krolbot/sirokko-26201-controller/pcb/README.md

# Исходники платы

Откройте **[Sirokko.kicad_pro](Sirokko.kicad_pro)** в KiCad 10 со стандартными библиотеками. Файлы проекта, функциональные листы схемы и локальные библиотеки образуют один комплект; копируйте каталог целиком.

- `Sirokko.kicad_pcb` — плата.
- `Sirokko.kicad_sch` — корневая схема, остальные `.kicad_sch` — её листы.
- `sym-lib-table`, `fp-lib-table`, `.kicad_sym`, `.pretty/`, `3dmodels/` — зависимости проекта с относительными путями.
- [schematic.pdf](schematic.pdf) — схема для просмотра без KiCad.

Соединения и конструкцию меняйте в этих файлах, без каталогов альтернативных плат. После изменения платы пересоберите Gerber/сверловку и монтажные файлы в [production](../production/). PDF схемы также экспортируйте из текущего проекта.

[Сборка и подключения](../BUILD.md) · [Компоненты](../BUY.md) · [Лицензии библиотек](KICAD_LIBRARIES_LICENSE.md)

## Вид платы

Лицевая сторона

Обратная сторона

Это изображения несущей платы; вставные DevKit, MAX31856 и внешняя панель на них не установлены. Некоторые заказные детали представлены габаритными моделями.
