krolbot/sirokko-26201-controller/BUY.md

# Компоненты Sirokko

Ведомость на один контроллер. [Скачать CSV](BUY.csv) для закупки или открытия в таблице.

## Детали с карточками ChipDip

Количество включает все перечисленные обозначения. Наличие и цену уточняйте в магазине.

| Обозначения | Кол. | Деталь и параметры | Артикул / карточка |
|---|---:|---|---|
| C21 | 1 | Конденсатор — 100 нФ, 100 В, X7R, 0805 | [GRM21BR72A104KAC4L](https://www.chipdip.ru/product/0.1mkf-x7r-100v-10-0805-grm21br72a104kac4l-murata-9000427298) |
| C22 | 1 | Конденсатор — 330 мкФ, 63 В, радиальный D10 P5 | [EEUFS1J331L](https://www.chipdip.ru/product/eeufs1j331l-panasonic-8027723178) |
| C24 | 1 | Конденсатор — 220 нФ, 100 В, X7R, 0805 | [CL21B224KCFSFNE](https://www.chipdip.ru/product/cl21b224kcfsfne-samsung-8017846748) |
| C25 | 1 | Конденсатор — 1 мкФ, 100 В, 1206 | [GRM31CR72A105KA01L](https://www.chipdip.ru/product/1-mkf-x7r-100v-10-1206-grm31cr72a105ka01l-murata-9000122527) |
| C101,C102 | 2 | Конденсатор — 2,2 мкФ, 100 В, X7R, 1210 | [GRM32ER72A225KA35L](https://www.chipdip.ru/product/2.2-mkf-x7r-10-100v-1210-grm32er72a225k-kondensator-murata-9000103930) |
| C103 | 1 | Конденсатор — 100 мкФ, 100 В, радиальный D10 P5 | [EEU-FR2A101](https://www.chipdip.ru/product/eeufr2a101-kondensatory-alyuminievye-panasonic-8048099750) |
| C104 | 1 | Конденсатор — 2,2 нФ, 50 В, C0G, 0603 | [GRM1885C1H222JA01D](https://www.chipdip.ru/product/2200pf-np0-50v-5-0603-grm1885c1h222ja01d-kondensator-murata-9000122092) |
| C105,C106 | 2 | Конденсатор — 47 мкФ, 16 В, X5R, 1210 | [GRM32ER61C476KE15L](https://www.chipdip.ru/product/47mkf-x5r-16v-10-1210-grm32er61c476ke15l-kondensator-murata-9000070696) |
| C107 | 1 | Конденсатор — 4,7 нФ, 50 В, C0G, 0603 | [GRM1885C1H472JA01D](https://www.chipdip.ru/product/4700pf-np0-50v-5-0603-grm1885c1h472ja01d-kondensator-murata-9000342731) |
| C108 | 1 | Конденсатор — 820 пФ, 50 В, C0G, 0603 | [CC0603JRNPO9BN821](https://www.chipdip.ru/product/820pf-np0-50v-5-0603-cc0603jrnpo9bn821-kondensator-yageo-9000537404) |
| C109 | 1 | Конденсатор — 33 нФ, 100 В, C0G, 0805 | [GRM2195C2A333JE01J](https://www.chipdip.ru/product/grm2195c2a333je01j-capacitor-ceramic-mlcc-33nf-100v-murata-8061975501) |
| D1 | 1 | TVS-защита — VSON-8 3×3 мм | [TVS3301DRBR](https://www.chipdip.ru/product/tvs3301drbr-texas-instruments-8003769406) |
| D101 | 1 | Диод Шоттки — 100 В, 5 А, TO-252 | [STPS5H100B-TR](https://www.chipdip.ru/product/stps5h100b-tr-diod-shottki-100v-5a-dpak-st-microelectronics-9001570322) |
| F1 | 1 | Держатель плавкой вставки — для вставки 0997015.WXN, посадочное место Keystone 3568 | [3568](https://www.chipdip.ru/product/3568-derzhatel-predohranitelya-tht-keystone-8070123077) |
| F1 | 1 | Плавкая вставка — 15 А, 58 В DC, для держателя 3568 | [0997015.WXN](https://www.chipdip.ru/product/0997015-wxn-predohranitel-plavkaya-vstavka-15a-littelfuse-8013841700) |
| J1,J3 | 2 | Гнездовая колодка 1×22 — P2,54, вертикальная, для DevKit | [SSQ-122-01-T-S](https://www.chipdip.ru/product0/8065631635) |
| J12 | 1 | Винтовая клеммная колодка 1×3 — MKDS 1,5, P5,08, горизонтальная | [1715734](https://www.chipdip.ru/product/1715734-vintovoy-terminal-17.5a-250v-phoenix-contact-8031094982) |
| J13,J27,J28 | 3 | Винтовая клеммная колодка 1×2 — MKDS 5-HV-2, P9,52 | [1756993](https://www.chipdip.ru/product/1756993-fixed-terminal-blocks-mkds-5-hv-2-9-phoenix-contact-8005105820) |
| J29 | 1 | Винтовая клеммная колодка 1×4 — MKDS 1,5-4, P5,08, горизонтальная | [1715747](https://www.chipdip.ru/product/1715747-fixed-terminal-blocks-4p-5.08mm-phoenix-contact-8005104956) |
| J30,J31 | 2 | Колодка модуля 1×9 — P2,54, для модулей MAX31856 | [SSW-109-01-T-S](https://www.chipdip.ru/product/ssw-109-01-t-s-headers-wire-housings-tiger-buy-samtec-8004762790) |
| K1,K2 | 2 | Колодка реле — 5 выводов, впаиваемая, для DG85BM-5021-76-1024 | [DZ85AB-5-PCB](https://www.chipdip.ru/product/dz85ab-5-pcb-dz-5-pin-pcb-mount-relay-socket-for-durakool-8034111209) |
| L101 | 1 | Силовой дроссель — 33 мкГн, Isat не менее 10 А | [SRP1770TA-330M](https://www.chipdip.ru/product/srp1770ta-330m-power-inductors-smd-33uh-20-bourns-8005125913) |
| Q1,Q2,Q3,Q4 | 4 | N-канальный MOSFET — 100 В, PG-TO263-7 | [IPB017N10N5LFATMA1](https://www.chipdip.ru/product/ipb017n10n5lfatma1-100v-180a-1.7mohm-100a-10v-313w-infineon-8044731406) |
| R1,R86,R87 | 3 | Резистор — 4,7 кОм, THT DIN0207, P10,16 | [MFR-25FTE52-4K7](https://www.chipdip.ru/product/mfr-25fte52-4k7-metal-film-resistors-4.7k-250mw-50ppm-yageo-8003541082) |
| R2,R3,R7,R8 | 4 | Резистор — 10 кОм, THT DIN0207, P10,16 | [MFR-25FBF52-10K](https://www.chipdip.ru/product/mfr-25fbf52-10k-through-hole-resistor-10-kohm-mfr-yageo-8015456907) |
| R90,R91,R92,R93 | 4 | Резистор — 4,7 Ом, 1 %, 0805 | [RC0805FR-074R7L](https://www.chipdip.ru/product/0.125vt-0805-4.7-om-1-rc0805fr-074r7l-chip-rezistor-yageo-9000237107) |
| R94 | 1 | Резистор — 84,5 кОм, 1 %, 0805 | [RC0805FR-0784K5L](https://www.chipdip.ru/product/rc0805fr-0784k5l-yageo-8001774452) |
| R95 | 1 | Резистор — 3,48 кОм, 1 %, 0805 | [RC0805FR-073K48L](https://www.chipdip.ru/product0/8001789855) |
| R96 | 1 | Резистор — 75 кОм, 1 %, 0805 | [RC0805FR-0775KL](https://www.chipdip.ru/product/rc0805fr-0775kl-yageo-8059892229) |
| R97 | 1 | Резистор — 5,62 кОм, 1 %, 0805 | [RC0805FR-075K62L](https://www.chipdip.ru/product/rc0805fr-075k62l-yageo-8001794155) |
| R101,R103 | 2 | Резистор — 31,6 кОм, 1 %, 0603 | [RC0603FR-0731K6L](https://www.chipdip.ru/product/rc0603fr-0731k6l-thick-film-resistors-smd-general-yageo-8005039309) |
| R102,R105,R107 | 3 | Резистор — 10 кОм, 1 %, 0603 | [RC0603FR-0710KL](https://www.chipdip.ru/product/rc0603fr-0710kl) |
| R104 | 1 | Резистор — 100 кОм, 1 %, 0603 | [RC0603FR-07100KL](https://www.chipdip.ru/product/0.1vt-0603-100-kom-1-rc0603fr-07100kl-chip-rezistor-yageo-9000721722) |
| R106 | 1 | Резистор — 82 кОм, 1 %, 0603 | [RC0603FR-0782KL](https://www.chipdip.ru/product/rc0603fr-0782kl-chip-rezistor-0603-82-kom-1-0.1vt-yageo-8045103082) |
| R108 | 1 | Резистор — 22 кОм, 1 %, 1210 | [RC1210FR-0722KL](https://www.chipdip.ru/product/rc1210fr-0722kl-yageo-8044377004) |
| TP101 | 1 | Контрольная точка — Micro Mini | [5015](https://www.chipdip.ru/product/5015-keystone-8002072088) |
| U11 | 1 | Драйвер двигателя — HTSSOP-16 с тепловой площадкой | [DRV8803PWPR](https://www.chipdip.ru/product/drv8803pwpr-texas-instruments-9001599750) |
| U13 | 1 | Контроллер идеального диода — WSON-12 3×3 мм с тепловой площадкой | [LM74800QDRRRQ1](https://www.chipdip.ru/product/lm74800qdrrrq1-kontroller-upravleniya-texas-instruments-9001859100) |
| U101 | 1 | Импульсный понижающий контроллер — DDA-8 | [LM5013DDAR](https://www.chipdip.ru/product/lm5013ddar-texas-instruments-8075672392) |
| J30,J31 | 2 | Модуль термопары MAX31856 — совместим с колодкой SSW-109-01-T-S, 9 контактов P2,54 | [синий 9-контактный, геометрия Adafruit 3263](https://www.chipdip.ru/product/3263-datchik-adapter-dlya-datchika-3-3-5vdc-ic-adafruit-8062129909) |
| J12 | 1 | Герметичный температурный зонд — IP67, трёхпроводный, для J12 | [DS18B20](https://www.chipdip.ru/product/ds18b20-ip67-1-3-wire-gilza-49-7-h-6-mm-smartmodule-9000725119) |

Для MAX31856 карточка Adafruit 3263 служит эталоном геометрии и распиновки; это не артикул безымянного синего модуля.

## Покупка вне ChipDip и изделия по месту

Ниже позиции без закреплённой карточки ChipDip. Это не утверждение об отсутствии товара во всём каталоге. Для маркетплейсов ищите указанную модель; одинакового названия недостаточно без совпадения исполнения.

| Обозначения | Кол. | Что купить | Совместимость |
|---|---:|---|---|
| J32 | 1 | Ключевой IDC-разъём 2×6 | P2,54, вертикальный, THT, ключевой, по посадочному месту IDC-Header_2x06. Для панели TFT |
| K1,K2 | 2 | Реле 24 В — DG85BM-5021-76-1024 | вставное, для колодки DZ85AB-5-PCB. Не заменять на другое семейство реле |
| J1,J3 | 1 | ESP32 DevKit — YD-ESP32-S3 N16R8 V1.4 | готовая плата, N16R8, V1.4, два ряда по 22 контакта. Голый ESP32-S3-WROOM не подходит |
| J29 | 1 | Контроллер двигателя — HC-160A S2 | исполнение S2, линии A1, A2, PA, G. Не часть PCB |
| J32 | 1 | Панель TFT с энкодером | TFT 2,4″ SPI, 3,3 В, EC11, отдельная KEY0, 12 доступных контактов. Не заменять панелью с другой распиновкой |
| — | 2 | Термопара — тип K | рабочий диапазон 0–600 °C. Механическое исполнение и длина не заданы |
| J32 | 1 | Шлейф панели | до 100 мм, ключевой 2×6 IDC со стороны J32, 12 контактов к выбранной панели. Разводка контактов не 1:1 |

## Колодки, вставные модули и кабели

- F1: держатель Keystone 3568 и вставка Littelfuse 0997015.WXN приобретаются отдельно.
- K1/K2: впаиваемые DZ85AB-5-PCB и вставные DG85BM-5021-76-1024 — разные позиции.
- J1/J3 и J30/J31 — колодки, не сами DevKit и MAX31856.
- Для TFT нужен шлейф до 100 мм по [таблице подключения J32](BUILD.md#панель-tft-24--ec11--key0), не прямой кабель 1:1.
- Крепёжные отверстия H* не являются закупаемыми деталями. Крепёж подбирается под корпус.

[Распиновки и электрические требования](BUILD.md) · [Файлы для монтажника](production/README.md)
