krolbot/sirokko-26201-controller/docs/research/YD_V14_ELECTRICAL_INTEGRATION_RU.md

# Sirokko — документарное сопряжение YD-ESP32-S3 V1.4

> Уточнение 2026-10-27: действуют [REQ-010/011/016](../REQUIREMENTS_RU.md#2-монтаж-компоненты-и-интерфейсы). YD-ESP32-S3 N16R8 USB-C сохраняется. Проектные 25%/30% не предъявляются к готовым DevKit/TFT и их внутренним компонентам. Применение 1,25 к U3 в расчёте ниже — сохранённая историческая проверка, НЕ действующий критерий приёмки и не основание переделывать или заменять модуль. Паспортные пределы, реальный баланс нагрузки, электрическая совместимость и проверка нашего питания остаются обязательными; к собственной обвязке Sirokko запасы применяются по REQ-016. Расчёты здесь не повторялись, CAD/BOM/прошивка не менялись.

## Происхождение и дата исследования

Публичная производная инженерного исследования проекта Sirokko: `YD_V14_ELECTRICAL_INTEGRATION_RU.md`, SHA256 исходника `140f7cfa49f716a295a7a53b1be22378153adbd3284611e0542f4abc1efaa834`. Основной текст сохранён; удалены только частные абсолютные пути к PCB, оставлено имя файла. Приведённые чтения паспортов, осмотры страниц, расчёты и CAD-проверки относятся к исходному исследованию и не повторялись при публикации.

Контекст зафиксирован **2026-10-26**. Формулировки ниже «текущий», «ожидает» и «откат выполняется» описывают этапы исследования, а не актуальное состояние CAD. К моменту публикации PCB уже восстановлена, адресная работа RESET возобновлена единственным CAD-редактором; её дальнейший результат и приёмка сюда не подставлены. Это не [CURRENT_STATE](../CURRENT_STATE_RU.md) и не новая инструкция монтажа RESET.

Предыдущий аппаратный снимок `d015fbb1` доступен в истории Git; настоящая копия сохраняет действующее исследование без дублирования CAD. **DRAFT / NOT FOR ORDER / NO FIRE. Производственного допуска нет.**

---

DRAFT / NOT FOR ORDER / НЕ ДЛЯ ОГНЕВЫХ ИСПЫТАНИЙ.
Результат: проверены назначения контактов и топология схемы модуля. Это не изменение PCB, не проверка конкретного экземпляра и не завершённая квалификация питания.

## Источники и границы

- Схема изготовителя: https://raw.githubusercontent.com/vcc-gnd/YD-ESP32-S3/main/5-public-YD-ESP32-S3-Hardware%20info/YD-ESP32-S3-SCH-V1.4.pdf . PDF скачан, отрисован и осмотрен, в том числе реальные диодные символы и соединения.
- Руководство: https://github.com/vcc-gnd/YD-ESP32-S3 .
- Исходная карта Sirokko: DEVKIT_NATIVE_TO_WAVESHARE_PINMAP.csv. Она использована ТОЛЬКО как реестр назначенных сетей несущей платы, не как доказательство схемы YD и не как свежее чтение PCB.
- Пользователь подтвердил визуальное совпадение выбранной RadioStack с YD. Это исходное данное пользователя, не наша прозвонка внутренних цепей.

## Проверка всех контактов

Результат инструментального сравнения: 44 контакта, 0 различий функций; 33 назначенных контакта, 11 неиспользуемых. Полная карта — DEVKIT_YD_V14_TO_CARRIER_PINMAP.csv.
На YD второй ряд называется J2, на Sirokko его ответная колодка — J3. Это разные reference, а не перестановка выводов.

J1 модуля, номера 1…22:
3V3,3V3,EN,4,5,6,7,15,16,17,18,8,3,46,9,10,11,12,13,14,5V-вход до D3,GND.

J2 модуля, номера 1…22:
GND,43,44,1,2,42,41,40,39,38,37,36,35,0,45,48,47,21,20,19,GND,GND.

Назначение совпадает с реестром, но это не доказывает сторону установки, хиральность, межрядье, габарит и целостность меди текущей PCB. Их проверяет единственный CAD-редактор. GPIO35/36/37 при Octal памяти не использовать; в реестре они не назначены. GPIO19/20 оставить нативному USB.

## Действующий pin-contract Sirokko

- `J1.3 = EN` — `NC`, на PCB `unconnected-(J1-Pin_3-Pad3)`. Внутреннюю цепь EN DevKit не менять.
- `J1.11 = GPIO18 = /OCP_OK` — цифровой вход Hi-Z. LOW означает аппаратное событие токовой отсечки. Запрещены внутренний pull-down и выходной режим. Существующая R9008 подтягивает сеть к +3V3; второй pull-up не добавлять. MCU только считывает событие и не может обойти аппаратную отсечку U9003→U9005.
- `J2.10 = GPIO38 = /ENC_SW` — действующее назначение энкодера, не менять.
- `J2.16 = GPIO48 = /TFT_DC` — действующее назначение после снятия перемычки RGB 0 Ом; не переносить на другой GPIO.

`/OCP_OK` не является измеренным током или RPM. Будущая прошивка должна программно защёлкивать аварию, запрещать розжиг и самопуск и отключать FUEL/GLOW. Минимальная длительность импульса, захват GPIO и полное время реакции требуют отдельной проверки; при неисправном двигателе нельзя обещать продувку.

## GPIO48 — принятое решение без переназначения TFT

По схеме: GPIO48 → перемычка RGB 0 Ом,0603 → RGB_CTRL → U1.3 DI. U1 — XL-5050RGBC-WS2812B, питание U1.1 от внутренней 5V, земля U1.4; U1.2 DO не используется.

Назначено для сборки Sirokko: разомкнуть/снять именно перемычку RGB 0 Ом. Не резать случайные дорожки и не замыкать её площадки. GPIO48 остаётся на J2.16 и используется как TFT_DC; прочие назначения GPIO не меняются. Программное отключение RGB не заменяет снятие перемычки. Питание RGB после этого сохраняется, его DI остаётся неподключённым; состояние/свечение U1 не считается диагностикой контроллера. Удаление/подтяжка DI допустимы только отдельной адресной сборочной доработкой, если реально нужны; не заземлять площадку GPIO48.

## Питание — фактическая топология

- USB1 VBUS (VBUSB) → анод D1 → катод → внутренняя 5V.
- USB2 VBUS → анод D2 → катод → внутренняя 5V.
- Контакт J1.21 → анод D3 → катод → внутренняя 5V.
- IN-OUT 0 Ом шунтирует D3.
- USB-OTG 0 Ом шунтирует D2.
- Внутренняя 5V питает вход U3.3 CJ6107A33GW; U3.2/4 дают VDD33. Номиналы на схеме: C4 10мкФ на входе, C3 10мкФ на выходе.
- CH343P U2.3/VDD5 и U2.9/VBUS питаются от USB1/VBUSB до D1; U2.1/VIO — от VDD33. Неподключённый USB не означает, что UART-микросхема полностью без напряжений.

Назначенная безопасная исходная конфигурация: IN-OUT РАЗОМКНУТА, USB-OTG РАЗОМКНУТА. Тогда D1/D2 препятствуют обратной подаче внутреннего питания на USB, D3 препятствует питанию шины несущей PCB от USB. Это заключение о топологии при исправных компонентах, не гарантия величины утечки и переходных режимов. Не устанавливать IN-OUT только ради устранения падения D3 без повторной проверки обратного тока.

Физический риск: установленная USB-OTG соединяет внутреннюю 5V с VBUS USB2 и может подать питание на порт компьютера. Перед подключением компьютера конфигурацию перемычек проверяет сборщик при обесточенном устройстве; огневые/силовые нагрузки отключены.

Открытая часть квалификации: D1…D3 обозначены в схеме только D26, без доказанного полного MPN и гарантированного VF/тока/утечки. Не переносить сюда B5819WS Waveshare. Рабочие данные U3 теперь найдены и проверены по официальному CJ6107 Series Rev.1.2 (см. раздел ниже); это закрывает прежний пробел поиска паспорта, но НЕ квалификацию всей цепи. Остаются идентификация диодов, суммарная нагрузка 3,3 В, предельный dropout и нагрев при фактической температуре. До этого нельзя заявлять запас питания, температурный режим или работоспособность всей сборки. Независимое размещение колодок и сохранение pin-map этим не блокируются.

### U3 CJ6107A33GW — прочитан паспорт, 1 А не является тепловым допуском

Источник изготовителя JSCJ: https://www.jscj-elec.com/gallery/file/CJ6107B33M%20Rev-1.2.pdf . Имя файла содержит B33M, но сам документ — общий CJ6107 Series, Rev.1.2; на страницах 1–2 явно присутствуют A/B, корпус G и варианты GW/GL. Прочитан текст и визуально проверены физические/печатные страницы 2–3. Локальный PDF `sirokko_CJ6107_rev12.pdf`, 9 страниц, SHA256 `2b61b50b933bc8af0eb7368e5fa2f40284809e7d92a45b95c068f4bd8b79da4e`. Редакция 1.3 найдена также в карточке LCSC https://www.lcsc.com/product-detail/C2829350.html и извлечена текстом, но расчётные ограничения здесь привязаны к осмотренной официальной Rev.1.2; её актуальность как последней редакции не утверждается.

Прямые данные Rev.1.2:
- Стр.2, SOT-223 GW: pin1=VSS, pin3=VIN, pin2=VOUT. Запись 1/3/2 — номера в порядке строк VSS/VIN/VOUT, не физическая последовательность выводов. Это совпадает с тремя основными выводами U3 в схеме YD. TAB=VDD33 показан самой схемой YD; паспортная связь TAB отдельно на этой странице не установлена.
- Стр.2, Absolute Maximum Ratings при Ta=25°C: Pd(SOT-223)=800 мВт; Iout=1100 мА; рабочие Ta −40…+85°C и Tj −40…+125°C приведены в этой таблице. Нельзя использовать 800 мВт как гарантированную непрерывную мощность в корпусе отопителя.
- Стр.3: Vin 2,5…6,0 В MIN/MAX; это не гарантия стабилизации 3,3 В при Vin=2,5 В.
- Стр.3: Vout=0,98…1,02 от номинала при Iout=100 мА, Ta=25°C, Vin=Vout+1 В. Для исполнения 3,3 В вычислено 3,234…3,366 В; не переносить этот предел на весь температурный/токовый диапазон.
- Стр.3: dropout 150 мВ при 300 мА и 500 мВ при 1000 мА стоят в колонке TYP, MAX пуст. Iout=1000 мА также TYP, не гарантированный минимум. Iq=70 мкА TYP; load regulation=30 мВ TYP. Тепловое отключение 150°C TYP не является рабочей температурой: Tj из стр.2 ниже.
- Стр.4, Typical Application: Cin и Cout не менее 4,7 мкФ, требуется проверка отсутствия генерации. На YD нанесено 10 мкФ, но без MPN нельзя считать доказанными эффективную ёмкость под напряжением и устойчивость по ESR.

Свежая read-only трассировка парной Sirokko SCH через MCP подтверждает, что +3V3 от J1.1/2 питает не только DevKit: среди нагрузок — J26.6 TFT, U9/U10 AVDD/DVDD, U1…U8, J12.1 и J25.1, подтяжки и развязка. Это вывод о назначении сети, не доказательство её медной связности и не полный токовый бюджет.

Расчётная проверка чувствительности, не реальный ток устройства:

`P_U3 = (V5 − VF_D3 − V3V3) * I3V3 + (V5 − VF_D3) * Iq`

Для явно условных V5=5,00 В, V3V3=3,30 В, Iq=70 мкА TYP и I3V3=0,50 А:
- VF_D3=0,20 В → P=0,750336 Вт;
- VF_D3=0,40 В → P=0,650322 Вт;
- VF_D3=0,60 В → P=0,550308 Вт.

Если отдельно применить условие 25% запаса по мощности к табличным 0,8 Вт при 25°C, необходимый, но недостаточный бюджет — P<=0,8/1,25=0,64 Вт. Первые два условных случая его не выполняют; третий проходит только этот скрининг, НЕ температурную квалификацию. При 0,30 А соответствующие потери 0,450336/0,390322/0,330308 Вт. Все значения получены execute_code. Без Iq номинальная граница при 0,50 А — VF>=0,42 В; это диагностический результат, НЕ требование выбирать диод с большим падением. Большое VF ухудшает запас по dropout, малое VF повышает нагрев LDO: оба края должны проверяться вместе.

Решение на текущем этапе: YD и согласованную топологию не менять; IN-OUT и USB-OTG сохранять разомкнутыми. Не объявлять 1 А допустимой нагрузкой всей 3,3-В сети, не шунтировать D3 и не добавлять параллельный источник 3,3 В ради снятия этого ограничения. Следующий электрический критерий — полный токовый бюджет и предельные Vin/VF/потери/температура, затем адресная доработка при реальном превышении. Неопубликованный максимальный dropout не заменять типовой кривой. Измерения пользователя для продолжения документального проектирования не запрашивать.

## Передача в единый CAD

Сохранить текущие функциональные сети и механическую компоновку по REQ-029; не переносить прежнюю нагрузку RGB/GPIO38 Waveshare. Внести сборочные требования RGB/IN-OUT/USB-OTG в актуальную документацию и BOM модуля. После применения выполнить native pad/net/connectivity comparison, полный DRC и свежие изображения. После принятия компоновки отдельно актуализировать firmware-контракт на N16R8 (16МБ Flash/8МБ Octal PSRAM) через default; эту сборку здесь не выполняли.
