krolbot/sirokko-26201-controller/hardware/bom.csv

Группа | Обозначения | Количество | Наименование | MPN / модель | Производитель | Параметры и посадочное место | Источник / статус | Ссылка | Примечание
Плата | C21 | 1 | Конденсатор | GRM21BR72A104KAC4L | Murata | 100 нФ, 100 В, X7R, 0805 | ChipDip — точный MPN | https://www.chipdip.ru/product/0.1mkf-x7r-100v-10-0805-grm21br72a104kac4l-murata-9000427298 | —
Плата | C22 | 1 | Конденсатор | EEUFS1J331L | Panasonic Industry | 330 мкФ, 63 В, радиальный D10 P5 | ChipDip — точный MPN | https://www.chipdip.ru/product/eeufs1j331l-panasonic-8027723178 | —
Плата | C24 | 1 | Конденсатор | CL21B224KCFSFNE | Samsung Electro-Mechanics | 220 нФ, 100 В, X7R, 0805 | ChipDip — точный MPN | https://www.chipdip.ru/product/cl21b224kcfsfne-samsung-8017846748 | —
Плата | C25 | 1 | Конденсатор | GRM31CR72A105KA01L | Murata | 1 мкФ, 100 В, 1206 | ChipDip — точный MPN | https://www.chipdip.ru/product/1-mkf-x7r-100v-10-1206-grm31cr72a105ka01l-murata-9000122527 | —
Плата | C101,C102 | 2 | Конденсатор | GRM32ER72A225KA35L | Murata | 2,2 мкФ, 100 В, X7R, 1210 | ChipDip — точный MPN | https://www.chipdip.ru/product/2.2-mkf-x7r-10-100v-1210-grm32er72a225k-kondensator-murata-9000103930 | —
Плата | C103 | 1 | Конденсатор | EEU-FR2A101 | Panasonic Industry | 100 мкФ, 100 В, радиальный D10 P5 | ChipDip — точный MPN | https://www.chipdip.ru/product/eeufr2a101-kondensatory-alyuminievye-panasonic-8048099750 | —
Плата | C104 | 1 | Конденсатор | GRM1885C1H222JA01D | Murata | 2,2 нФ, 50 В, C0G, 0603 | ChipDip — точный MPN | https://www.chipdip.ru/product/2200pf-np0-50v-5-0603-grm1885c1h222ja01d-kondensator-murata-9000122092 | —
Плата | C105,C106 | 2 | Конденсатор | GRM32ER61C476KE15L | Murata | 47 мкФ, 16 В, X5R, 1210 | ChipDip — точный MPN | https://www.chipdip.ru/product/47mkf-x5r-16v-10-1210-grm32er61c476ke15l-kondensator-murata-9000070696 | —
Плата | C107 | 1 | Конденсатор | GRM1885C1H472JA01D | Murata | 4,7 нФ, 50 В, C0G, 0603 | ChipDip — точный MPN | https://www.chipdip.ru/product/4700pf-np0-50v-5-0603-grm1885c1h472ja01d-kondensator-murata-9000342731 | —
Плата | C108 | 1 | Конденсатор | CC0603JRNPO9BN821 | Yageo | 820 пФ, 50 В, C0G, 0603 | ChipDip — точный MPN | https://www.chipdip.ru/product/820pf-np0-50v-5-0603-cc0603jrnpo9bn821-kondensator-yageo-9000537404 | —
Плата | C109 | 1 | Конденсатор | GRM2195C2A333JE01J | Murata | 33 нФ, 100 В, C0G, 0805 | ChipDip — точный MPN | https://www.chipdip.ru/product/grm2195c2a333je01j-capacitor-ceramic-mlcc-33nf-100v-murata-8061975501 | —
Плата | D1 | 1 | TVS-защита | TVS3301DRBR | Texas Instruments | VSON-8 3×3 мм | ChipDip — точный MPN | https://www.chipdip.ru/product/tvs3301drbr-texas-instruments-8003769406 | —
Плата | D101 | 1 | Диод Шоттки | STPS5H100B-TR | STMicroelectronics | 100 В, 5 А, TO-252 | ChipDip — точный MPN | https://www.chipdip.ru/product/stps5h100b-tr-diod-shottki-100v-5a-dpak-st-microelectronics-9001570322 | —
Плата | F1 | 1 | Держатель плавкой вставки | 3568 | Keystone Electronics | для вставки 0997015.WXN, посадочное место Keystone 3568 | ChipDip — точный MPN | https://www.chipdip.ru/product/3568-derzhatel-predohranitelya-tht-keystone-8070123077 | Впаивается в PCB
Вставное | F1 | 1 | Плавкая вставка | 0997015.WXN | Littelfuse | 15 А, 58 В DC, для держателя 3568 | ChipDip — точный MPN | https://www.chipdip.ru/product/0997015-wxn-predohranitel-plavkaya-vstavka-15a-littelfuse-8013841700 | Устанавливается в держатель F1
Плата | J1,J3 | 2 | Гнездовая колодка 1×22 | SSQ-122-01-T-S | Samtec | P2,54, вертикальная, для DevKit | ChipDip — точный MPN | https://www.chipdip.ru/product0/8065631635 | —
Плата | J12 | 1 | Винтовая клеммная колодка 1×3 | 1715734 | Phoenix Contact | MKDS 1,5, P5,08, горизонтальная | ChipDip — точный MPN | https://www.chipdip.ru/product/1715734-vintovoy-terminal-17.5a-250v-phoenix-contact-8031094982 | Для DS18B20
Плата | J13,J27,J28 | 3 | Винтовая клеммная колодка 1×2 | 1756993 | Phoenix Contact | MKDS 5-HV-2, P9,52 | ChipDip — точный MPN | https://www.chipdip.ru/product/1756993-fixed-terminal-blocks-mkds-5-hv-2-9-phoenix-contact-8005105820 | Вход 24 В и два выхода нагрузки
Плата | J29 | 1 | Винтовая клеммная колодка 1×4 | 1715747 | Phoenix Contact | MKDS 1,5-4, P5,08, горизонтальная | ChipDip — точный MPN | https://www.chipdip.ru/product/1715747-fixed-terminal-blocks-4p-5.08mm-phoenix-contact-8005104956 | Для HC-160A S2
Плата | J30,J31 | 2 | Колодка модуля 1×9 | SSW-109-01-T-S | Samtec | P2,54, для модулей MAX31856 | ChipDip — точный MPN | https://www.chipdip.ru/product/ssw-109-01-t-s-headers-wire-housings-tiger-buy-samtec-8004762790 | —
Плата | J32 | 1 | Ключевой IDC-разъём 2×6 | — | — | P2,54, вертикальный, THT, ключевой, по посадочному месту IDC-Header_2x06 | MPN и карточка не назначены | — | Для панели TFT
Плата | K1,K2 | 2 | Колодка реле | DZ85AB-5-PCB | Durakool | 5 выводов, впаиваемая, для DG85BM-5021-76-1024 | ChipDip — точный MPN | https://www.chipdip.ru/product/dz85ab-5-pcb-dz-5-pin-pcb-mount-relay-socket-for-durakool-8034111209 | Впаивается в PCB
Вставное | K1,K2 | 2 | Реле 24 В | DG85BM-5021-76-1024 | Durakool | вставное, для колодки DZ85AB-5-PCB | Вне ChipDip — выбранный MPN | — | —
Плата | L101 | 1 | Силовой дроссель | SRP1770TA-330M | Bourns | 33 мкГн, Isat не менее 10 А | ChipDip — точный MPN | https://www.chipdip.ru/product/srp1770ta-330m-power-inductors-smd-33uh-20-bourns-8005125913 | —
Плата | Q1,Q2,Q3,Q4 | 4 | N-канальный MOSFET | IPB017N10N5LFATMA1 | Infineon Technologies | 100 В, PG-TO263-7 | ChipDip — точный MPN | https://www.chipdip.ru/product/ipb017n10n5lfatma1-100v-180a-1.7mohm-100a-10v-313w-infineon-8044731406 | —
Плата | R1,R86,R87 | 3 | Резистор | MFR-25FTE52-4K7 | Yageo | 4,7 кОм, THT DIN0207, P10,16 | ChipDip — точный MPN | https://www.chipdip.ru/product/mfr-25fte52-4k7-metal-film-resistors-4.7k-250mw-50ppm-yageo-8003541082 | —
Плата | R2,R3,R7,R8 | 4 | Резистор | MFR-25FBF52-10K | Yageo | 10 кОм, THT DIN0207, P10,16 | ChipDip — точный MPN | https://www.chipdip.ru/product/mfr-25fbf52-10k-through-hole-resistor-10-kohm-mfr-yageo-8015456907 | —
Плата | R90,R91,R92,R93 | 4 | Резистор | RC0805FR-074R7L | Yageo | 4,7 Ом, 1 %, 0805 | ChipDip — точный MPN | https://www.chipdip.ru/product/0.125vt-0805-4.7-om-1-rc0805fr-074r7l-chip-rezistor-yageo-9000237107 | —
Плата | R94 | 1 | Резистор | RC0805FR-0784K5L | Yageo | 84,5 кОм, 1 %, 0805 | ChipDip — точный MPN | https://www.chipdip.ru/product/rc0805fr-0784k5l-yageo-8001774452 | —
Плата | R95 | 1 | Резистор | RC0805FR-073K48L | Yageo | 3,48 кОм, 1 %, 0805 | ChipDip — точный MPN | https://www.chipdip.ru/product0/8001789855 | —
Плата | R96 | 1 | Резистор | RC0805FR-0775KL | Yageo | 75 кОм, 1 %, 0805 | ChipDip — точный MPN | https://www.chipdip.ru/product/rc0805fr-0775kl-yageo-8059892229 | —
Плата | R97 | 1 | Резистор | RC0805FR-075K62L | Yageo | 5,62 кОм, 1 %, 0805 | ChipDip — точный MPN | https://www.chipdip.ru/product/rc0805fr-075k62l-yageo-8001794155 | —
Плата | R101,R103 | 2 | Резистор | RC0603FR-0731K6L | Yageo | 31,6 кОм, 1 %, 0603 | ChipDip — точный MPN | https://www.chipdip.ru/product/rc0603fr-0731k6l-thick-film-resistors-smd-general-yageo-8005039309 | —
Плата | R102,R105,R107 | 3 | Резистор | RC0603FR-0710KL | Yageo | 10 кОм, 1 %, 0603 | ChipDip — точный MPN | https://www.chipdip.ru/product/rc0603fr-0710kl | —
Плата | R104 | 1 | Резистор | RC0603FR-07100KL | Yageo | 100 кОм, 1 %, 0603 | ChipDip — точный MPN | https://www.chipdip.ru/product/0.1vt-0603-100-kom-1-rc0603fr-07100kl-chip-rezistor-yageo-9000721722 | —
Плата | R106 | 1 | Резистор | RC0603FR-0782KL | Yageo | 82 кОм, 1 %, 0603 | ChipDip — точный MPN | https://www.chipdip.ru/product/rc0603fr-0782kl-chip-rezistor-0603-82-kom-1-0.1vt-yageo-8045103082 | —
Плата | R108 | 1 | Резистор | RC1210FR-0722KL | Yageo | 22 кОм, 1 %, 1210 | ChipDip — точный MPN | https://www.chipdip.ru/product/rc1210fr-0722kl-yageo-8044377004 | —
Плата | TP101 | 1 | Контрольная точка | 5015 | Keystone Electronics | Micro Mini | ChipDip — точный MPN | https://www.chipdip.ru/product/5015-keystone-8002072088 | —
Плата | U11 | 1 | Драйвер двигателя | DRV8803PWPR | Texas Instruments | HTSSOP-16 с тепловой площадкой | ChipDip — точный MPN | https://www.chipdip.ru/product/drv8803pwpr-texas-instruments-9001599750 | —
Плата | U13 | 1 | Контроллер идеального диода | LM74800QDRRRQ1 | Texas Instruments | WSON-12 3×3 мм с тепловой площадкой | ChipDip — точный MPN | https://www.chipdip.ru/product/lm74800qdrrrq1-kontroller-upravleniya-texas-instruments-9001859100 | —
Плата | U101 | 1 | Импульсный понижающий контроллер | LM5013DDAR | Texas Instruments | DDA-8 | ChipDip — точный MPN | https://www.chipdip.ru/product/lm5013ddar-texas-instruments-8075672392 | —
Внешнее | J1,J3 | 1 | ESP32 DevKit | YD-ESP32-S3 N16R8 V1.4 | YD | готовая плата, N16R8, V1.4, два ряда по 22 контакта | Вне ChipDip — согласованное исполнение | — | —
Внешнее | J30,J31 | 2 | Модуль термопары MAX31856 | синий 9-контактный, геометрия Adafruit 3263 | — | совместим с колодкой SSW-109-01-T-S, 9 контактов P2,54 | ChipDip — эталон геометрии | https://www.chipdip.ru/product/3263-datchik-adapter-dlya-datchika-3-3-5vdc-ic-adafruit-8062129909 | Геометрия и распиновка Adafruit 3263
Внешнее | J12 | 1 | Герметичный температурный зонд | DS18B20 | Smartmodule | IP67, трёхпроводный, для J12 | ChipDip — карточка зонда | https://www.chipdip.ru/product/ds18b20-ip67-1-3-wire-gilza-49-7-h-6-mm-smartmodule-9000725119 | Длина кабеля выбирается по месту
Внешнее | J29 | 1 | Контроллер двигателя | HC-160A S2 | — | исполнение S2, линии A1, A2, PA, G | Вне ChipDip — согласованное исполнение | — | —
Внешнее | J32 | 1 | Панель TFT с энкодером | — | — | TFT 2,4″ SPI, 3,3 В, EC11, отдельная KEY0, 12 доступных контактов | Вне ChipDip — ограничения совместимости | — | Распиновка — в docs/assembly.md
Внешнее | — | 2 | Термопара | тип K | — | рабочий диапазон 0–600 °C | Исполнение выбирается по месту | — | Механическое исполнение и длина не заданы
Внешнее | J32 | 1 | Шлейф панели | — | — | до 100 мм, ключевой 2×6 IDC со стороны J32, 12 контактов к выбранной панели | Исполнение выбирается по месту | — | Разводка контактов не 1:1
