krolbot/sirokko-26201-controller/BUILD.md

# Сборка и подключение

[Детали](BUY.md) · [Заказать плату](production/README.md) · [Запись и настройка](SETUP.md) · [Управление](USE.md)

## Порядок сборки

1. Закажите плату по производственным файлам и соберите комплект по [BUY.csv](BUY.csv). Для самостоятельной пайки используйте [сборочный вид](production/assembly/assembly.pdf) и [схему](pcb/schematic.pdf).
2. Впаяйте SMD-компоненты, затем выводные детали, клеммники и колодки. F1 в монтажной ведомости — держатель; K1/K2 — колодки реле. Сами предохранитель, реле и модули устанавливаются после пайки.
3. Сверьте ориентацию микросхем, диода D101, электролитов и ключей разъёмов по схеме и сборочному виду. Удалите остатки монтажа; проверьте отсутствие замыкания питания.
4. Без вставных модулей и подключённых нагрузок подайте питание на J13 и проверьте полярность и выход 5 В. Отключите питание перед дальнейшей сборкой.
5. Запишите прошивку в вынутый DevKit по [SETUP.md](SETUP.md), затем установите его в J1/J3. Настройку перемычек смотрите ниже.
6. Установите два MAX31856 в J30/J31 и закрепите их стойками подходящей высоты без изгиба плат. Вставьте предохранитель и два реле.
7. Изготовьте шлейф панели по таблице J32 ниже. Подключите датчики, внешний моторный контроллер, свечу и муфту, сверяя номер каждого контакта.
8. До запуска выполните [начальную настройку и калибровку](SETUP.md). Порядок обычной работы — в [USE.md](USE.md).

## Питание и нагрузки

Номинальное питание — **24 В DC**, проектный диапазон **21,6–28,8 В**. Входная защита: предохранитель F1, LM74800-Q1 с MOSFET от переполюсовки и TVS3301. На плате LM5013 формирует 5 В для DevKit; питание 3,3 В датчиков и панели поступает от DevKit.

Проектные пределы интерфейсов:

| Цепь | Непрерывно | Кратковременно |
|---|---:|---:|
| J27, свеча | 7 А | 10 А, не более 1 с |
| J28, муфта насоса | 2 А | 3 А, не более 1 с |
| J13, общий ввод платы | 10 А | 13 А, не более 1 с |

F1 — **Littelfuse 0997015.WXN, 15 А / 58 В DC**, держатель **Keystone 3568**. Номинал вставки не повышает допустимый ток платы до 15 А. Температура воздуха у держателя — не выше 80 °C. Расчётный непрерывный бюджет выхода 5 В — 0,70 А; это не разрешение отбирать такой же ток из 3,3-вольтового стабилизатора DevKit. Мощность внешнего БП не определяет допустимый ток через Sirokko.

Плата рассчитана на указанный источник постоянного напряжения; соответствие автомобильным импульсам ISO и промышленным испытаниям ЭМС не заявляется. F1 не является быстродействующей защитой MOSFET и может не отключить перегрузку от БП с ограничением тока.

## Внешние соединения

Номера ниже — **номера площадок/контактов**, не положение слева направо на фотографии. На плате есть обозначения разъёмов; сверяйте полярность по схеме и маркировке.

| Разъём | Контакты | Назначение |
|---|---|---|
| J13 | 1: +24 В; 2: GND | Основное питание платы и релейных нагрузок |
| J27 | 1: коммутируемый плюс; 2: GND | Свеча, реле K1 |
| J28 | 1: коммутируемый плюс; 2: GND | Муфта насоса, реле K2 |
| J12 | 1: +3,3 В; 2: DQ; 3: GND | Комнатный DS18B20 |
| J29 | 1: A1; 2: A2/GND; 3: PA/PWM; 4: G/GND | Только управление внешним HC-160A-S2 |
| J30 | См. ниже | Модуль MAX31856 выхлопной термопары |
| J31 | См. ниже | Модуль MAX31856 термопары горячего воздуха |
| J32 | См. таблицу панели | Панель TFT + EC11 + KEY0 |

### ESP32-S3

Используется **YD-ESP32-S3 N16R8 V1.4**, вставленный в J1/J3; колодки находятся на лицевой стороне платы. Не подменяйте его произвольным DevKit с другим порядком выводов. [Схема изготовителя и документация](https://github.com/vcc-gnd/YD-ESP32-S3).

- Штатная перемычка RGB сохранена; RGB использует GPIO48.
- **IN-OUT и USB-OTG разомкнуты**: они обходят развязывающие диоды питания.
- Установленный DevKit питается от Sirokko. **Для USB-прошивки выньте DevKit из обесточенной платы**: это исключает обратное питание периферии и USB.
- Встроенные кнопки EN/BOOT остаются на DevKit; отдельной RESET на несущей плате нет.

### Моторный контроллер

HC-160A-S2 находится **вне платы**. Его силовое питание и оба вывода двигателя подключаются непосредственно к нему. **Ни один моторный вывод Н-моста не соединять с постоянной землёй.** Выход `+5V OUT` HC-160A не используется.

J29.1 получает команду включения с GPIO16, J29.3 — ШИМ с GPIO17. A2 постоянно соединён с GND; реверс не используется. Нужен экземпляр HC-160A-S2 с входами, совместимыми с логикой 3,3 В и используемой частотой ШИМ. Интерфейс не содержит тахометра, измерения тока или FAULT: отображаемый процент — команда, не измеренные обороты.

### Датчики

DS18B20 подключается трёхпроводно к J12, **без паразитного питания**. Подтяжка DQ 4,7 кОм уже есть на плате. Цвета проводов разных зондов не стандартизованы. Расчётный предел суммарной ёмкости линии, включая кабель и датчик, — 300 пФ; произвольная добавочная ёмкость на DQ не предусмотрена.

Для J30/J31 нужны девятиконтактные модули MAX31856 с геометрией и порядком выводов **Adafruit 3263**:

| Контакт | Сигнал |
|---:|---|
| 1 | DRDY |
| 2 | FLT, не подключён |
| 3 | CS |
| 4 | SDI/MOSI |
| 5 | SDO/MISO |
| 6 | SCK |
| 7 | GND |
| 8 | 3Vo, не подключён |
| 9 | VIN, +3,3 В |

SPI общая, CS и DRDY раздельные. **Термопары типа K подключаются к клеммам самих модулей**, не к цифровым колодкам J30/J31. Диапазон зонда, его кабеля и изоляции должен покрывать место установки; выбранный тип датчика и температурные пределы задаются при настройке.

### Панель TFT 2,4″ + EC11 + KEY0

Панель — покупной SPI-модуль ST7789 с энкодером и кнопкой KEY0, питание и логика **3,3 В**. J32 — IDC 2×6, шаг 2,54 мм, кабель не длиннее 100 мм. **Кабель не прямой 1:1.**

| J32 | Контакт панели | Сигнал | GPIO |
|---:|---:|---|---:|
| 1 | 1 | GND | — |
| 2 | 2 | VCC, +3,3 В | — |
| 3 | 4 | SDA/MOSI | 7 |
| 4 | — | Дополнительный GND | — |
| 5 | 3 | SCL/SCK | 8 |
| 6 | 9 | Энкодер A | 5 |
| 7 | 10 | Энкодер B | 38 |
| 8 | 11 | Нажатие энкодера | 47 |
| 9 | 5 | RES | 6 |
| 10 | 6 | DC | 41 |
| 11 | 7 | CS | 42 |
| 12 | 12 | KEY0, Пуск/стоп | 40 |

Контакт панели 8 `BLK` не подключён: нужен модуль с включённой по умолчанию подсветкой. KEY0 должен замыкаться на GND; в ESP32 включена подтяжка. Подписи SDA/SCL здесь означают **SPI, не I²C**. Модуль должен соответствовать разрешению и ориентации, настроенным в прошивке; одинаковая диагональ не гарантирует одинаковую распиновку.

## Реле

K1 и K2 — **Durakool DG85BM-5021-76-1024**, катушка 24 В без встроенного подавителя, вставляются в **DZ85AB-5-PCB**. DRV8803 коммутирует катушки по минусу: GPIO14 — свеча, GPIO15 — муфта. R86/R87 удерживают команды в нуле при запуске.

Силовые контакты нормально разомкнутые: 30 получает защищённый плюс, 87 идёт к нагрузке. Независимого последовательного контакта для отключения залипшего K2 и аппаратной обратной связи от реле нет; программная команда OFF не устраняет сваривание контактов.
