krolbot/sirokko-26201-controller/docs/assembly.md

# Сборка и подключение

[Детали](../hardware/BOM.md) · [Заказать плату](../manufacturing/README.md) · [Запись и настройка](user-guide.md#первоначальная-настройка) · [Управление](user-guide.md#управление)

## Порядок сборки

1. Закажите плату по производственным файлам и соберите комплект по [ведомости компонентов](../hardware/bom.csv). Для самостоятельной пайки используйте [сборочный вид](../manufacturing/assembly/assembly.pdf) и [схему](../hardware/schematic.pdf).
2. Впаяйте SMD-компоненты, затем выводные детали, клеммники и колодки. F1 в монтажной ведомости — держатель; K1/K2 — колодки реле. Сами предохранитель, реле и модули устанавливаются после пайки.
3. Сверьте ориентацию микросхем, диода D101, электролитов и ключей разъёмов по схеме и сборочному виду. Удалите остатки монтажа; проверьте отсутствие замыкания питания.
4. Без вставных модулей и подключённых нагрузок подайте питание на J13 и проверьте полярность и выход 5 В. Отключите питание перед дальнейшей сборкой.
5. Запишите прошивку в вынутый DevKit по [руководству пользователя](user-guide.md#первоначальная-настройка), затем установите его в J1/J3. Настройку перемычек смотрите ниже.
6. Установите два MAX31856 в J30/J31 и закрепите их стойками подходящей высоты без изгиба плат. Вставьте предохранитель и два реле.
7. Изготовьте шлейф панели по таблице J32 ниже. Подключите датчики, внешний моторный контроллер, свечу и муфту, сверяя номер каждого контакта.
8. До запуска выполните [начальную настройку](user-guide.md#первоначальная-настройка). Порядок обычной работы — в [руководстве пользователя](user-guide.md#управление).

## Питание и нагрузки

Номинальное питание — **24 В DC**, проектный диапазон **21,6–28,8 В**. Входная защита: предохранитель F1, LM74800-Q1 с MOSFET от переполюсовки и TVS3301. На плате LM5013 формирует 5 В для DevKit; питание 3,3 В датчиков и панели поступает от DevKit.

Проектные пределы интерфейсов:

| Цепь | Непрерывно | Кратковременно |
|---|---:|---:|
| J27, свеча | 7 А | 10 А, не более 1 с |
| J28, муфта насоса | 2 А | 3 А, не более 1 с |
| J13, общий ввод платы | 10 А | 13 А, не более 1 с |

F1 — **Littelfuse 0997015.WXN, 15 А / 58 В DC**, держатель **Keystone 3568**. Температура воздуха у держателя — не выше 80 °C. Расчётный непрерывный ток выхода 5 В — 0,70 А.

Стойкость к автомобильным импульсным помехам и соответствие промышленным требованиям ЭМС не подтверждены. При питании от БП с ограничением тока F1 может не отключить перегрузку; быстродействующая защита MOSFET предохранителем не обеспечивается.

## Внешние соединения

Нумерация контактов соответствует схеме и маркировке платы.

| Разъём | Контакты | Назначение |
|---|---|---|
| J13 | 1: +24 В; 2: GND | Основное питание платы и релейных нагрузок |
| J27 | 1: коммутируемый плюс; 2: GND | Свеча, реле K1 |
| J28 | 1: коммутируемый плюс; 2: GND | Муфта насоса, реле K2 |
| J12 | 1: +3,3 В; 2: DQ; 3: GND | Комнатный DS18B20 |
| J29 | 1: A1; 2: A2/GND; 3: PA/PWM; 4: G/GND | Управление HC-160A-S2 |
| J30 | См. ниже | Модуль MAX31856 выхлопной термопары |
| J31 | См. ниже | Модуль MAX31856 термопары горячего воздуха |
| J32 | См. таблицу панели | Панель TFT + EC11 + KEY0 |

### ESP32-S3

**YD-ESP32-S3 N16R8 V1.4** устанавливается в J1/J3 на лицевой стороне платы. [Схема изготовителя и документация](https://github.com/vcc-gnd/YD-ESP32-S3).

- Штатная перемычка RGB сохранена; RGB использует GPIO48.
- **IN-OUT и USB-OTG разомкнуты**: они обходят развязывающие диоды питания.
- Установленный DevKit питается от Sirokko. **Для USB-прошивки выньте DevKit из обесточенной платы**: это исключает обратное питание периферии и USB.
- Сброс и вход в загрузчик — кнопками EN/BOOT на DevKit.

### Моторный контроллер

Подключите питание и двигатель к HC-160A-S2. **Ни один моторный вывод Н-моста не соединять с постоянной землёй.** Выход `+5V OUT` HC-160A не используется.

Двигатель подключён двумя силовыми проводами к выходу драйвера. Штатное переключение второй скорости Sirokko не используется; регулирование выполняется ШИМ HC-160A-S2.

J29.1 получает команду включения с GPIO16, J29.3 — ШИМ с GPIO17. A2 постоянно соединён с GND; реверс не используется. Нужен экземпляр HC-160A-S2 с входами, совместимыми с логикой 3,3 В и используемой частотой ШИМ. Обратной связи по оборотам, току и FAULT нет.

### Датчики

DS18B20 подключается трёхпроводно к J12, **без паразитного питания**. Подтяжка DQ 4,7 кОм уже есть на плате. Распиновку зонда определяйте по его документации. Расчётный предел суммарной ёмкости кабеля и датчика — 300 пФ.

Для J30/J31 нужны девятиконтактные модули MAX31856 с геометрией и порядком выводов **Adafruit 3263**:

| Контакт | Сигнал |
|---:|---|
| 1 | DRDY |
| 2 | FLT, не подключён |
| 3 | CS |
| 4 | SDI/MOSI |
| 5 | SDO/MISO |
| 6 | SCK |
| 7 | GND |
| 8 | 3Vo, не подключён |
| 9 | VIN, +3,3 В |

SPI общая, CS и DRDY раздельные. Термопары K подключаются к клеммам модулей. Зонд, кабель и изоляцию выбирайте по температуре в месте установки.

### Панель TFT 2,4″ + EC11 + KEY0

Панель — покупной SPI-модуль ST7789 с энкодером и кнопкой KEY0, питание и логика **3,3 В**. J32 — IDC 2×6, шаг 2,54 мм, кабель не длиннее 100 мм. **Кабель не прямой 1:1.**

| J32 | Контакт панели | Сигнал | GPIO |
|---:|---:|---|---:|
| 1 | 1 | GND | — |
| 2 | 2 | VCC, +3,3 В | — |
| 3 | 4 | SDA/MOSI | 7 |
| 4 | — | Дополнительный GND | — |
| 5 | 3 | SCL/SCK | 8 |
| 6 | 9 | Энкодер A | 5 |
| 7 | 10 | Энкодер B | 38 |
| 8 | 11 | Нажатие энкодера | 47 |
| 9 | 5 | RES | 6 |
| 10 | 6 | DC | 41 |
| 11 | 7 | CS | 42 |
| 12 | 12 | KEY0, Пуск/стоп | 40 |

Контакт панели 8 `BLK` не подключён: нужен модуль с включённой по умолчанию подсветкой. KEY0 должен замыкаться на GND; в ESP32 включена подтяжка. Подписи SDA/SCL здесь означают **SPI, не I²C**. Разрешение и ориентация экрана должны соответствовать настройкам прошивки.

## Реле

K1 и K2 — **Durakool DG85BM-5021-76-1024**, катушка 24 В без встроенного подавителя, вставляются в **DZ85AB-5-PCB**. DRV8803 коммутирует катушки по минусу: GPIO14 — свеча, GPIO15 — муфта. R86/R87 удерживают команды в нуле при запуске.

Силовые контакты нормально разомкнутые: 30 получает защищённый плюс, 87 идёт к нагрузке. Контроль состояния контактов и резервное отключение при залипании K2 не предусмотрены.
