krolbot/sirokko-26201-controller/docs/user-guide.md

# Руководство пользователя

## Первоначальная настройка

### Запись прошивки

Скачайте и распакуйте [Sirokko-firmware.zip](https://github.com/krolbot/sirokko-26201-controller/releases/latest/download/Sirokko-firmware.zip), сохранив подкаталоги.

Выньте DevKit из обесточенной платы Sirokko и подключите к USB. В терминале ESP-IDF 5.2.3 перейдите в каталог комплекта:

```sh
sha256sum -c SHA256SUMS
python -m esptool --chip esp32s3 --port /dev/ttyACM0 write_flash @flash_args
```

Замените порт своим, например `COM5` в Windows. Если автоматический вход в загрузчик не сработал: зажмите BOOT, нажмите и отпустите EN, отпустите BOOT и повторите запись.

### Подключение к веб-пульту

Подключитесь к сети **Sirokko-XXXXXX** и откройте **http://192.168.26.1/**. По умолчанию пароля нет. Интернет через эту сеть недоступен; при запросе телефона выберите «Оставаться подключённым».

### Параметры отопителя

Откройте **Настройки → Параметры отопителя**. Для обычного отопления заполните поля **«Отключать топливо при выхлопе ниже»** и **«Не снижать ШИМ ниже»**. Остальные обязательные параметры уже заполнены. Первые измерения можно получить через **Первый запуск**, без заполненного профиля. Параметры можно сохранять частями; сохранение доступно при остановленном отопителе и само по себе не запускает нагрев.

| Параметр | Назначение |
|---|---|
| Накал свечи перед подачей топлива | Длительность работы свечи при выключенных двигателе и муфте. По умолчанию 30 с, допустимо 30–60 с |
| Время на розжиг | Время от подачи топлива до подтверждённого прогрева выхлопа. Включает 10 с работы свечи; по умолчанию 90 с |
| Минимальное время охлаждения | Двигатель продолжает работать после отключения топлива не менее этого времени. По умолчанию 150 с |
| Отключать топливо при выхлопе ниже | После выключения свечи выхлоп должен держаться не ниже этой температуры 1 с, чтобы контроллер завершил розжиг. Во время работы непрерывное падение ниже неё на заданную задержку отключает топливо и запускает аварийное охлаждение |
| Задержка отключения при остывании выхлопа | 1–30 с непрерывно ниже нижнего порога. Возврат к порогу сбрасывает отсчёт. По умолчанию 1 с; при обновлении прежнее поведение сохраняется. Не влияет на розжиг, перегрев или отказ датчика |
| Отключать топливо при выхлопе от | Необязательная настройка. При достижении заданной температуры выключаются муфта и свеча, двигатель охлаждает отопитель. Пустое поле отключает только эту дополнительную проверку |
| Выключать двигатель при выхлопе ниже | Температура завершения охлаждения; также должно истечь минимальное время. По умолчанию 40 °C |
| ШИМ при розжиге | Команда двигателя при розжиге и верхняя граница регулирования |
| Не снижать ШИМ ниже | При отоплении ШИМ не опускается ниже этого значения. Если оно равно ШИМ при розжиге, регулировки двигателя не будет |
| ШИМ при охлаждении | Команда двигателя после отключения топлива |

ШИМ задаётся числом от 1 до 4014; это команда регулятору HC-160A-S2, а не измеренные обороты. Температурные пределы относятся к термопаре в потоке выхлопа. Нижнюю границу температуры и ШИМ определяют при настройке. Поле **«Отключать топливо при выхлопе от»** можно оставить пустым.

Времена предварительного накала, ожидания розжига и охлаждения взяты из [инструкции Sirokko 241–265](https://ikarusbusclub.ru/books/Store/Instrukzia_Sirokko_241-265.pdf), разделы 6.2 и 7.7. Указанные в ней примерно 450 °C выхлопа и 120 °C нагретого воздуха при входных 0 °C — номинальные температуры, а не аварийные пределы. Штатную защиту от перегрева обеспечивает плавкий элемент в цепи муфты (§5.2.4); он должен оставаться подключённым. При неисправности термопары, потере её показаний или достижении границы измерения 600 °C прошивка также отключает топливо. 600 °C — граница измерения используемых термопар, не допустимая температура отопителя.

При обновлении с версии до 1.10 параметры отопителя нужно сохранить заново. Пароль Wi-Fi, заданная комнатная температура и таймер сохраняются.

### Первый запуск и запись измерений

Отключите USB, установите DevKit в обесточенную плату и подключите оборудование по [инструкции сборки](assembly.md). После подачи питания проверьте показания датчиков в **Состоянии**. Для первого запуска нужны исправные термопары, подключённая панель с KEY0 и остывший отопитель.

Перед запуском верните штатное отключение топлива при перегреве непосредственно в цепь муфты. Пока минимальная рабочая температура выхлопа не определена, контроллер не подтверждает горение по температуре: за розжигом нужно наблюдать, при неудаче — нажать KEY0 для остановки.

1. Откройте **Настройки → Параметры отопителя → Первый запуск** и нажмите **Подготовить запуск**. Запись измерений начнётся автоматически.
2. В течение 30 секунд нажмите KEY0 на панели. Свеча накаляется 30 секунд при выключенных двигателе и муфте.
3. Включаются двигатель и топливная муфта. Свеча работает с ними ещё 10 секунд, затем выключается. Начальный ШИМ — 4014 при питании 24 В.
4. Убедившись в устойчивом горении, нажмите **Горение устойчивое** в браузере или энкодер на панели. Без подтверждения топливо отключится через 90 секунд после начала подачи. При отсутствии розжига сразу остановите запуск кнопкой KEY0 или в веб-пульте.
5. После подтверждения доступны до 30 минут работы и регулировка ШИМ. В браузере переместите ползунок и нажмите **Применить ШИМ**; на панели поверните энкодер и нажмите его. Оба пульта показывают фактически применённую команду.
6. На проверенном значении нажмите **Выбрать этот ШИМ как нижний**. Для предложения температуры нужны 2 минуты с колебаниями выхлопа не более 5 °C на выбранном ШИМ. Это проверка стабильности измерений, а не качества горения.
7. Повторно нажмите KEY0 или **Остановить запуск** в веб-пульте для остановки. Повторные подтверждения и изменения ШИМ не продлевают время запуска.

Повторное нажатие KEY0, кнопка **Остановить запуск** в браузере, неисправность датчика или сбой обработки кнопки отключают свечу и топливо. Затем двигатель охлаждает отопитель не менее 150 секунд и до заданной температуры завершения охлаждения — по умолчанию ниже 40 °C на выхлопе. Автоматического повторения или перехода к обычному отоплению нет.

Сначала прогрейте отопитель на полной команде. В инструкции (§7.7) перед регулировкой охлаждающего выбега предусмотрено около 10 минут полной нагрузки. При исследовании пониженных команд меняйте ШИМ постепенно и выдерживайте каждое значение, пока температурный график не перестанет заметно меняться. Остановку вращения или срыв горения не принимайте за рабочую нижнюю границу.

Запись и расчёт выполняются на ESP. Страницу можно закрыть: после подключения снова появятся выбранный ШИМ и предложение температуры. Измерения хранятся в ограниченном буфере оперативной памяти (около 24 КБ), без записи во флеш. Охлаждение не расходует буфер измерений. Запись и результат остаются до перезапуска ESP или нового первого запуска; сохранённые настройки переживают отключение питания.

После охлаждения на странице появится кнопка **Сохранить ШИМ и температуру**. Она сохраняет выбранный код в **«Не снижать ШИМ ниже»**, а предложение — в **«Отключать топливо при выхлопе ниже»**. Остальные параметры не меняются. До подтверждения сохранения настройки остаются прежними.

Температурное предложение — середина между нижним опорным значением (большее из температуры до подачи топлива и температуры завершения охлаждения) и минимальной температурой подтверждённого горения в выбранном диапазоне ШИМ. Учитываются переходы между командами, но не охлаждение и не работа ниже выбранного ШИМ. Проверяется, что при записанном розжиге выхлоп успевал превысить предложение после выключения свечи на время подтверждения. Ошибки датчиков, пропуски в работе контроллера, авария или изменение профиля делают запись непригодной для предложения. Обрыв Wi-Fi на запись не влияет.

Это начальная настройка по одному запуску; её проверяют при следующем холодном запуске. Температура выхлопа реагирует на погасание с задержкой и сама по себе не подтверждает качество горения. Верхний аварийный предел из записи не рассчитывается.

Скачивать и передавать CSV для настройки не требуется. **Новый первый запуск** заменяет предыдущую запись после принятия команды контроллером; сохранённые настройки не удаляются. Отдельная запись CSV в разделе **Состояние** остаётся инструментом наблюдения в браузере и не участвует в расчёте настроек.

### Обычное отопление

После настройки параметров отопителя нажмите **Включить отопление** или коротко нажмите KEY0 на местной панели.

Если пуск недоступен, рядом с кнопкой указана причина и ссылка на соответствующий раздел. ESP без подключённых датчиков позволяет настроить параметры, но не запустить отопление.

## Управление

### Местная панель

| Действие | Результат |
|---|---|
| Короткое нажатие KEY0 | Пуск или остановка |
| Поворот энкодера на главном экране | Изменение температуры или ручного уровня |
| Нажатие энкодера | Открыть меню, выбрать пункт, применить значение |
| Двойное нажатие энкодера | Отменить правку или вернуться назад |

В **Режиме** выбирается ручное управление или поддержание температуры помещения по DS18B20. В ручном режиме уровень задаётся в процентах от максимального ШИМ, в пределах настроенного диапазона двигателя.

### Веб-пульт

- **Отопление** — пуск, остановка, режим и температура. Изменения шкалы или кнопок −/+ подтверждаются кнопкой **Применить**.
- **Таймер** — длительность нагрева и оставшееся время. При остановленном отопителе отсчёт начнётся после пуска; при работающем — после применения таймера. По истечении времени начинается остановка с охлаждением. **Выключить таймер** отменяет ограничение времени, сохраняя нагрев.
- **Состояние** — температуры, график, журнал событий и запись измерений.
- **Настройки** — параметры отопителя, Wi-Fi, тема и обновление. В **Дополнительно → Скорость изменения ШИМ** находятся ползунки скорости повышения и снижения команды двигателя.

Панель и браузер показывают одно состояние. Если другой пульт изменил редактируемое значение, местная панель отменяет правку, а браузер предлагает загрузить текущее значение.

Тема по умолчанию следует системе; можно выбрать светлую или тёмную вручную.

### График и запись измерений

График в **Состоянии** хранит около 30 минут данных в памяти ESP. Старые точки заменяются новыми; выключение питания очищает историю.

Для CSV нажмите **Запись измерений → Начать запись**. Записываются температуры, время и состояние датчиков, команды двигателя, свечи и муфты. В **Отметку в записи** можно добавить своё наблюдение.

Держите страницу открытой и экран включённым. По завершении нажмите **Завершить запись → Скачать CSV**. Данные хранятся в памяти браузера до закрытия страницы. Запись заканчивается при перезапуске ESP или достижении 21 600 строк; пропуски связи отмечаются в файле.

### Пароль Wi-Fi

После остановки и охлаждения откройте **Настройки → Wi-Fi**. Пароль — от 8 до 63 латинских букв, цифр или символов без пробелов; он используется для сети и входа в веб-пульт. **Убрать пароль** открывает доступ всем находящимся рядом.

Новый пароль применяется при следующем включении питания. После этого переподключитесь к сети и войдите в веб-пульт с новым паролем. Обновление прошивки сохраняет пароль.

## Запуск, остановка и ошибки

Для свечи используется [схема с дополнительным накалом 10 с после подачи топлива](https://www.drive2.ru/c/725421214318744547/). Температура выхлопа контролирует результат розжига и последующую работу; длительность накала от неё не зависит.

1. **Накал:** работает свеча, двигатель и муфта выключены.
2. **Розжиг:** включаются двигатель и муфта. Свеча работает ещё **10 с**, затем выключается по времени. После этого контроллер ждёт, чтобы выхлоп держался не ниже заданной минимальной температуры 1 с, и переходит к обычной работе. Если за отведённое на розжиг время выхлоп не прогрелся, топливо отключается и начинается аварийное охлаждение.
3. **Работа:** двигатель поддерживает выбранный уровень или температуру помещения. Топливо отключается при достижении верхнего предела выхлопа, падении ниже минимальной температуры на 1 с, устойчивом падении температуры при неизменной команде двигателя либо неисправности нужных для работы датчиков.
4. **Остановка:** муфта и свеча выключаются. Двигатель работает не менее заданного времени охлаждения и до выхлопа ниже заданной температуры — по умолчанию 40 °C. Для завершения нужны исправные, свежие показания обеих термопар.

Остановить нагрев можно кнопкой KEY0 или из веб-пульта. Питание отключают после завершения охлаждения.

Если питание пропало во время незавершённого цикла, после включения контроллер выполняет охлаждение; нагрев сам не возобновляется. После штатно завершённой остановки включение питания оставляет двигатель выключенным.

При ошибке сообщение и показания доступны в **Состоянии**. После устранения причины нажмите энкодер на главном экране для сброса ошибки.

## Обновление

После остановки и охлаждения откройте **Настройки → Обновление** и загрузите подписанный файл `.sota`. После перезагрузки версия отображается в интерфейсе. Для первой записи и восстановления используется USB.

Пакет должен быть подписан ключом, соответствующим установленной прошивке. [Сборка и подпись собственного пакета](../firmware/README.md#подпись-ota).
