krolbot/sirokko-26201-controller/hardware/schematic.pdf

1 | 2 | 3 | 4 | 5 | 6 | 7 | 8 | 9 | 10 | 11
1 | 2 | 3 | 4 | 5 | 6 | 7 | 8 | 9 | 10 | 11

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
### FGH Date: 2026-10-23

Size: A2 | Rev: 1.0
KiCad E.D.A. 10.0.8 | Id: 1/5

## Title: Sirokko 262.01 - common controller interfaces

### File: Sirokko.kicad_sch

### Sheet: /

### 24 V heater controller

GND

P24_PROTECTED

GLOW_CMD

FUEL_CMD

K_GLOW_COIL_LOW

K_CLUTCH_RUN_COIL_LOW RelayDriver

File: RelayDriver.kicad_sch

VIN_RAW_24
P24_PROTECTED
GND

InputProtection

File: InputProtection.kicad_sch

P24_PROTECTED
GND

Power5V

File: Power5V.kicad_sch

GND

SPEED_CMD

FAN_REQUEST MotorInterface

File: MotorInterface.kicad_sch

R8

10k

30

30

85 85 | 86

86

87 87

87a | 87a K1
DG85BM-5021-76-1024 + DZ85AB-5-PCB / GLOW | 30

30

85

85
86

86

87

87

87a 87a K2

DG85BM-5021-76-1024 + DZ85AB-5-PCB / CLUTCH_RUN

1
2

J27 GLOW_OUTPUT_PHOENIX_1756993

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
J31 MAX31856 AIR

1
2

J28 CLUTCH_OUTPUT_PHOENIX_1756993

1
2

J13

24V_INPUT_PHOENIX_1756993 R3

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
# J30 MAX31856 EXHAUST 1

2
3

J12 ROOM_DS18B20_HARNESS R1

4k7 | R7

10k R2

10k

1 | 2
3 | 4
5 | 6
7 | 8
9 | 10
11 | 12

J32

TFT_2.4_EC11_SPI_3V3_100mm_MAX

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
# J1 DEVKITC1_J1

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
J3 DEVKITC1_J3 +5V_DEVKIT

FUEL_CMD

GND

P24_PROTECTED

TFT_RES

ENC_B

GND

GND

K_GLOW_COIL_LOW

+3V3

GLOW_SWITCHED_POS

TFT_CS GND

ENC_A ENC_SW

# TC_AIR_CS +3V3

TFT_DC

GLOW_CMD

PANEL_SCL | PANEL_KEY0

CLUTCH_SWITCHED_POS K_CLUTCH_RUN_COIL_LOW

P24_PROTECTED

GND

SPEED_CMD
FAN_REQUEST
FAN_REQUEST | SPEED_CMD
TC_AIR_DRDY | P24_PROTECTED

GND

GLOW_CMD

TC_SDO_MISO

P24_PROTECTED PANEL_SDA

TC_AIR_CS
TC_EXH_CS
TC_SDI_MOSI TC_SCK | GND

CLUTCH_SWITCHED_POSGND

GND

ROOM_DQ

K_CLUTCH_RUN_COIL_LOW

P24_PROTECTED

P24_PROTECTED

PANEL_SDA +3V3

TC_EXH_DRDY

TC_EXH_CS

TC_SDO_MISO

TFT_RES

ENC_A+3V3

ROOM_DQ

TC_SCK | +3V3 | GLOW_SWITCHED_POS K_GLOW_COIL_LOW

PANEL_SCL

TC_SDI_MOSI GND +3V3

GND | GND

# TC_EXH_DRDY GND

GND

ENC_SW

ENC_B

TFT_DC

TFT_CS PANEL_KEY0 GND

GND

GND

TC_EXH_CS +3V3

GND

ROOM_DQ

TC_AIR_DRDY

TC_AIR_CS +3V3
TC_SDI_MOSI TC_SDO_MISO

SPEED_CMD

FUEL_CMD +3V3

TC_SCK

P24_PROTECTED

FAN_REQUEST VIN_RAW_24 | CONTROLLER POWER AND RESET

J1.6/GPIO6 drives TFT_RES on J32.9. No external watchdog/latch or independent 24 V presence input. Firmware disables fuel/glow after reset and requires an explicit start. PANEL: SPI, 3.3 V, TFT + EC11 + KEY0; J32 IDC 2x6, NOT A 1:1 CABLE. J32 -> module: 1->1 GND; 2->2 VCC; 3->4 MOSI GPIO7; 5->3 SCK GPIO8; 6->9 A GPIO5; 7->10 B GPIO38; 8->11 PUSH GPIO47; 9->5 RES GPIO6; 10->6 DC GPIO41; 11->7 CS GPIO42; 12->12 KEY0 GPIO40. J32.4=GND; module pin8 BLK not connected; panel must support default-on backlight.

PANEL_SDA/PANEL_SCL are SPI, not I2C. Cable <=100 mm. KEY0 must close to GND; long press starts/stops. Encoder handles the menu. | RELAY DRIVER — DRV8803 IN1=GLOW_CMD; IN2=FUEL_CMD. Unused IN3/IN4, nENBL and RESET=GND. OUT1 sinks K1 coil; OUT2 sinks K2 coil. OUT3/OUT4/nFAULT not connected.

TWO RELAYS: K1 GLOW; K2 CLUTCH. U11 IN1=GLOW_CMD, IN2=FUEL_CMD.
IN3/IN4, nENBL and RESET tied to GND. No independent series contact for a welded K2; motor control is external.

LM5013 supplies +5V_DEVKIT. The installed DevKit is powered only from Sirokko. Remove the DevKit before connecting USB for programming. MAIN INPUT / ROOM SENSOR

J13: 1=VIN_RAW_24, 2=GND. Design supply 21.6..28.8 V. DevKit is powered only from this board; remove it before USB programming. J12: 1=3V3, 2=DQ, 3=GND. Never apply 24 V to logic terminals.

THERMOCOUPLES: J30 EXHAUST / J31 HOT AIR — TYPE K
9-pin MAX31856 modules, Adafruit 3263 pin order and geometry.

VIN=3V3; 3Vo/FLT not connected; probes connect at module terminals. SIROKKO 262.01 — CONTROLLER YD-ESP32-S3 N16R8 V1.4; 24 V supply. Motor: external HC-160A-S2; K1 glow; K2 fuel clutch.

LOCAL PANEL

TFT 2.4 + EC11 + KEY0 at J32; KEY0=START/STOP, GPIO40. No separate user controls on the carrier. The DevKit retains its own EN/BOOT buttons and USB programming interface. J28 CLUTCH: 1=switched positive; 2=power GND. Design load: 2 A continuous; 3 A for up to 1 s. J27 GLOW: 1=switched positive; 2=power GND. Design load: 7 A continuous; 10 A for up to 1 s. DEFINED INPUTS / OUTPUTS R1: room-sensor pull-up; R2/R3: thermocouple CS pull-ups.

R7/R8: fan/PWM pulldowns; relay pulldowns on RelayDriver sheet. The external TFT 2.4 + EC11 + KEY0 panel connects to J32.

# J1 DEVKITC1_J1

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
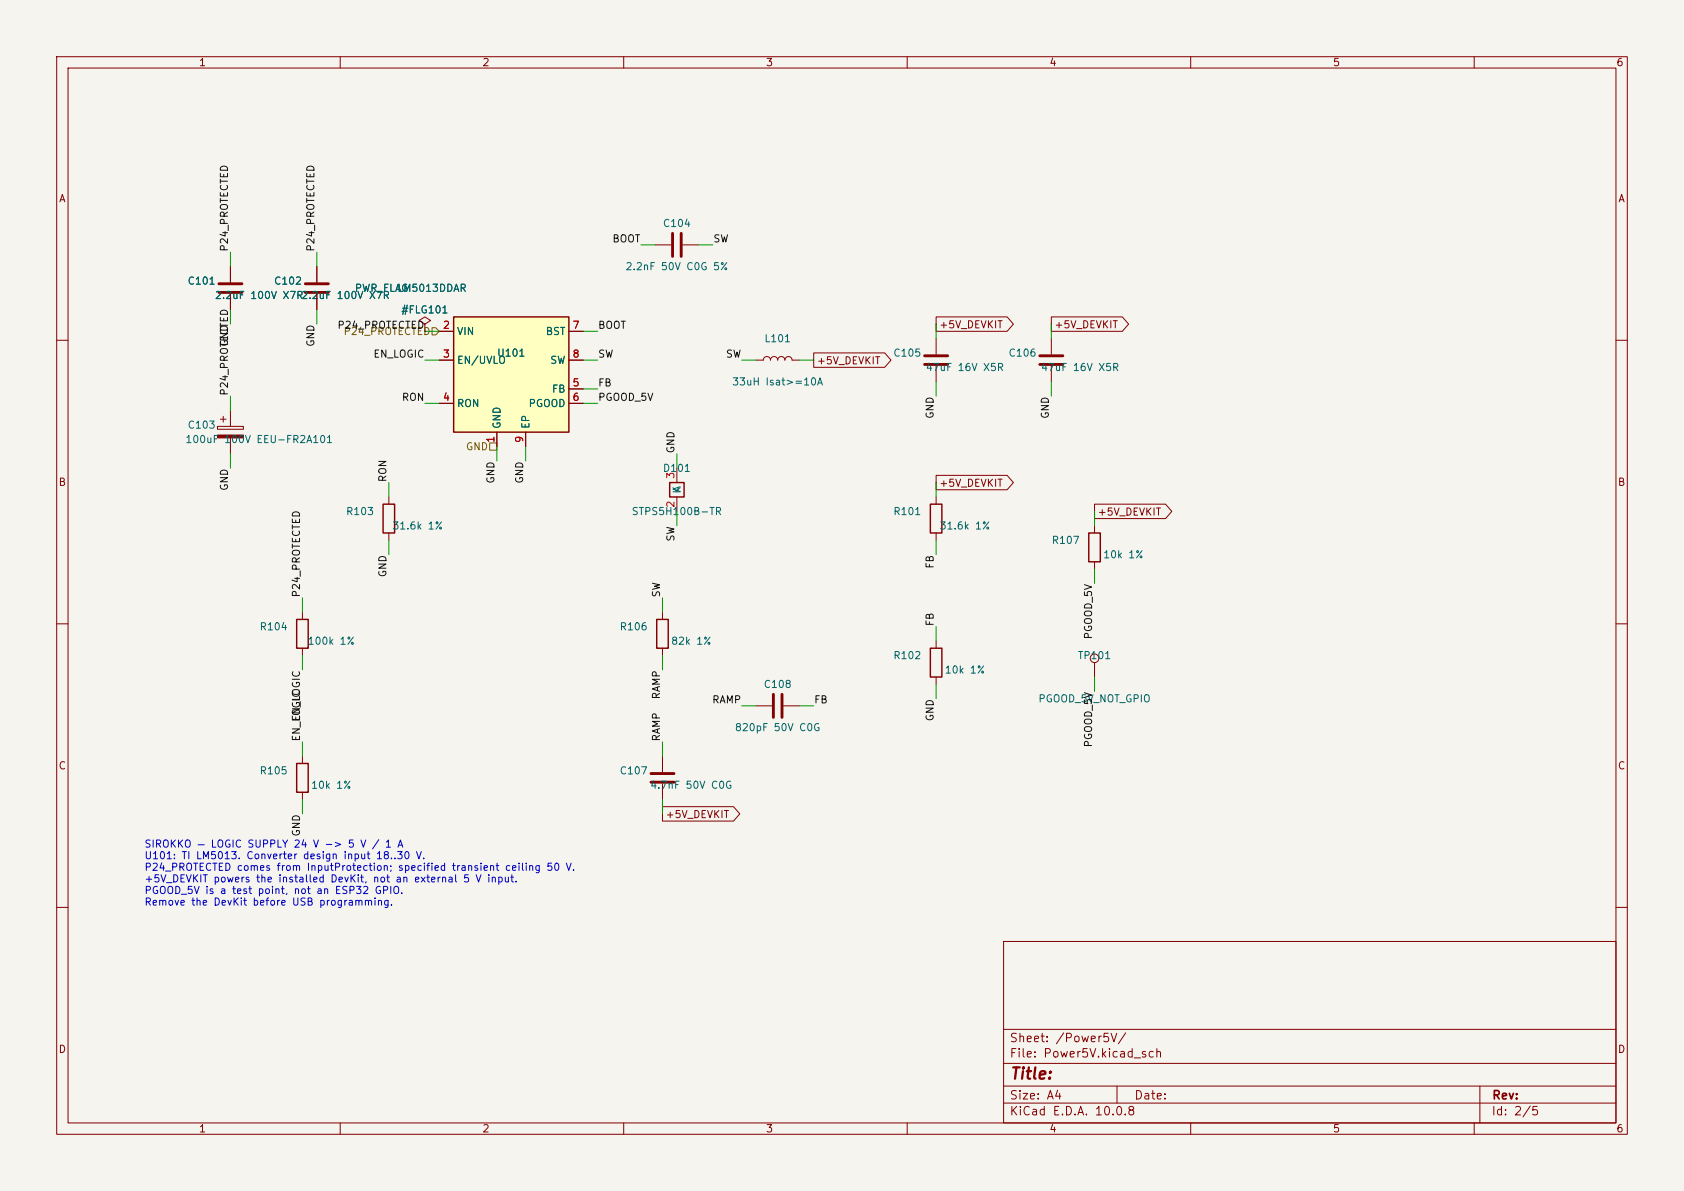
[picture p3: page 2]

SIROKKO — LOGIC SUPPLY 24 V -> 5 V / 1 A U101: TI LM5013. Converter design input 18..30 V. P24_PROTECTED comes from InputProtection; specified transient ceiling 50 V. +5V_DEVKIT powers the installed DevKit, not an external 5 V input. PGOOD_5V is a test point, not an ESP32 GPIO. Remove the DevKit before USB programming.

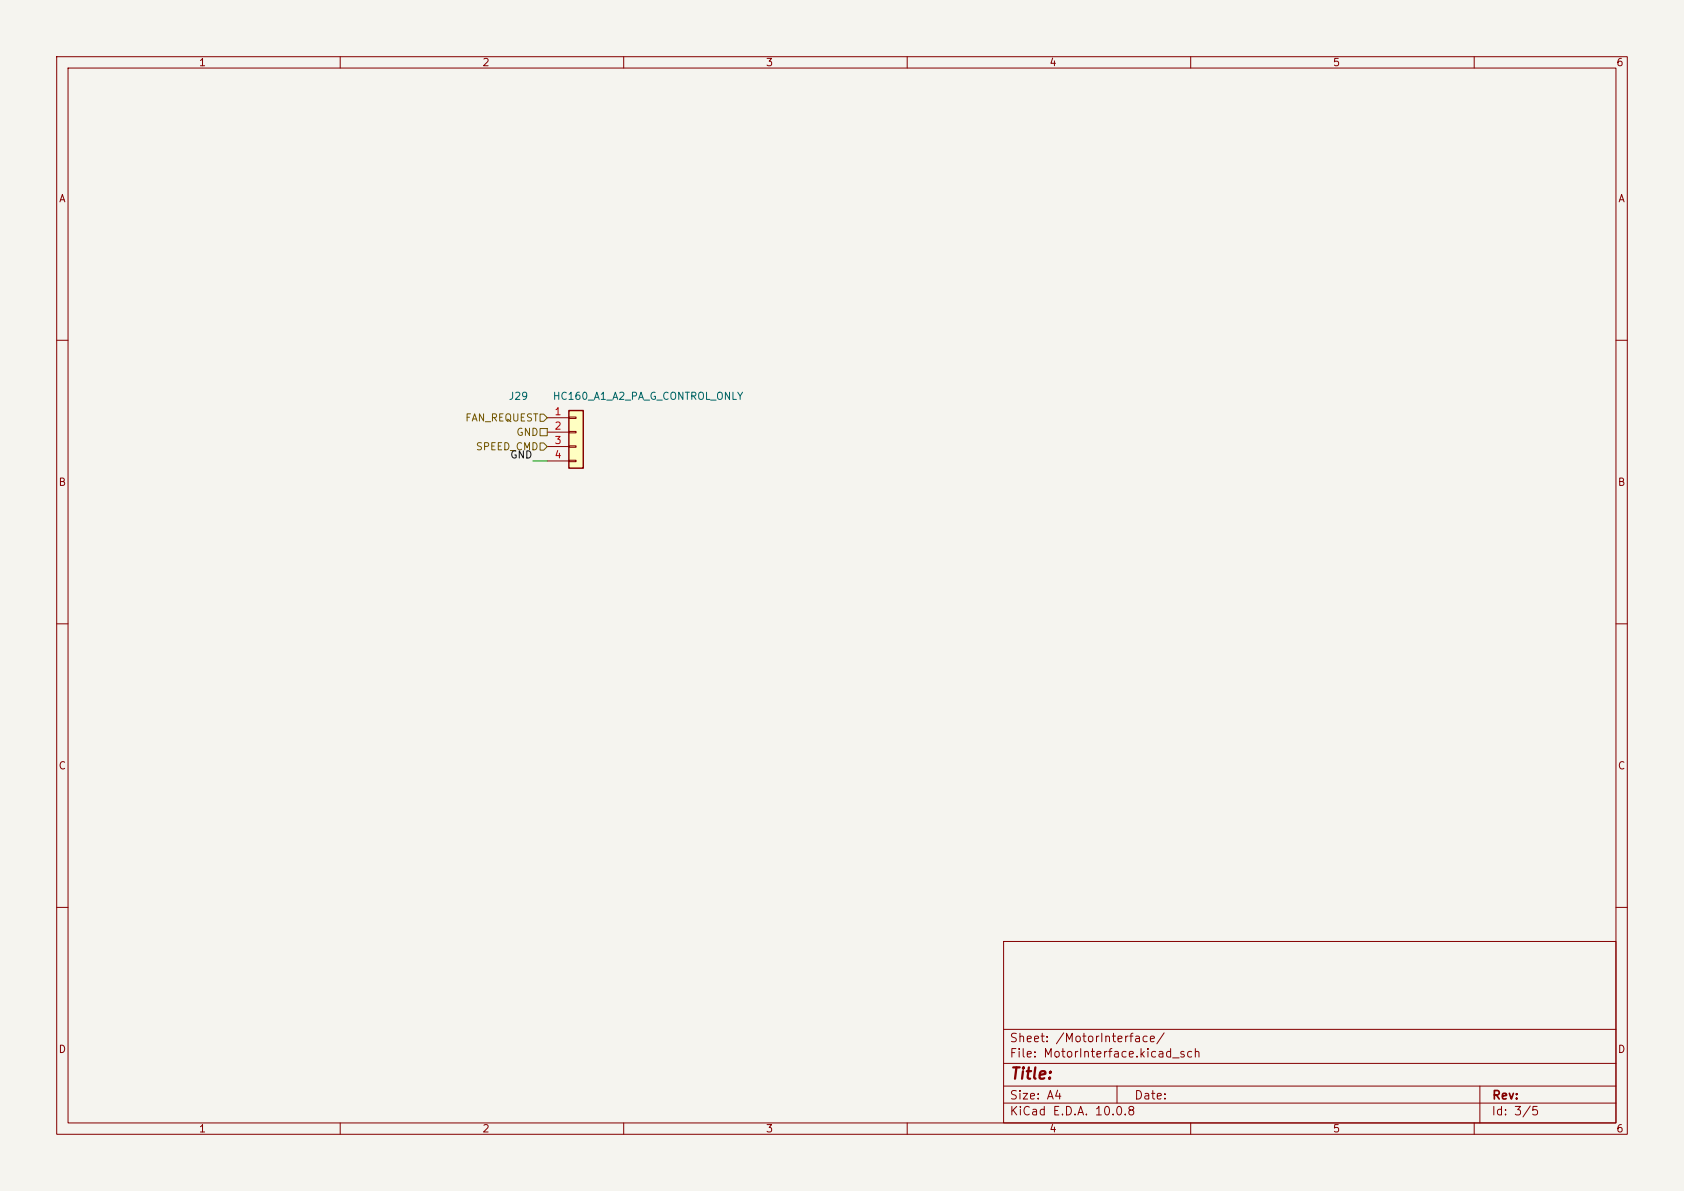
[picture p4: page 3]

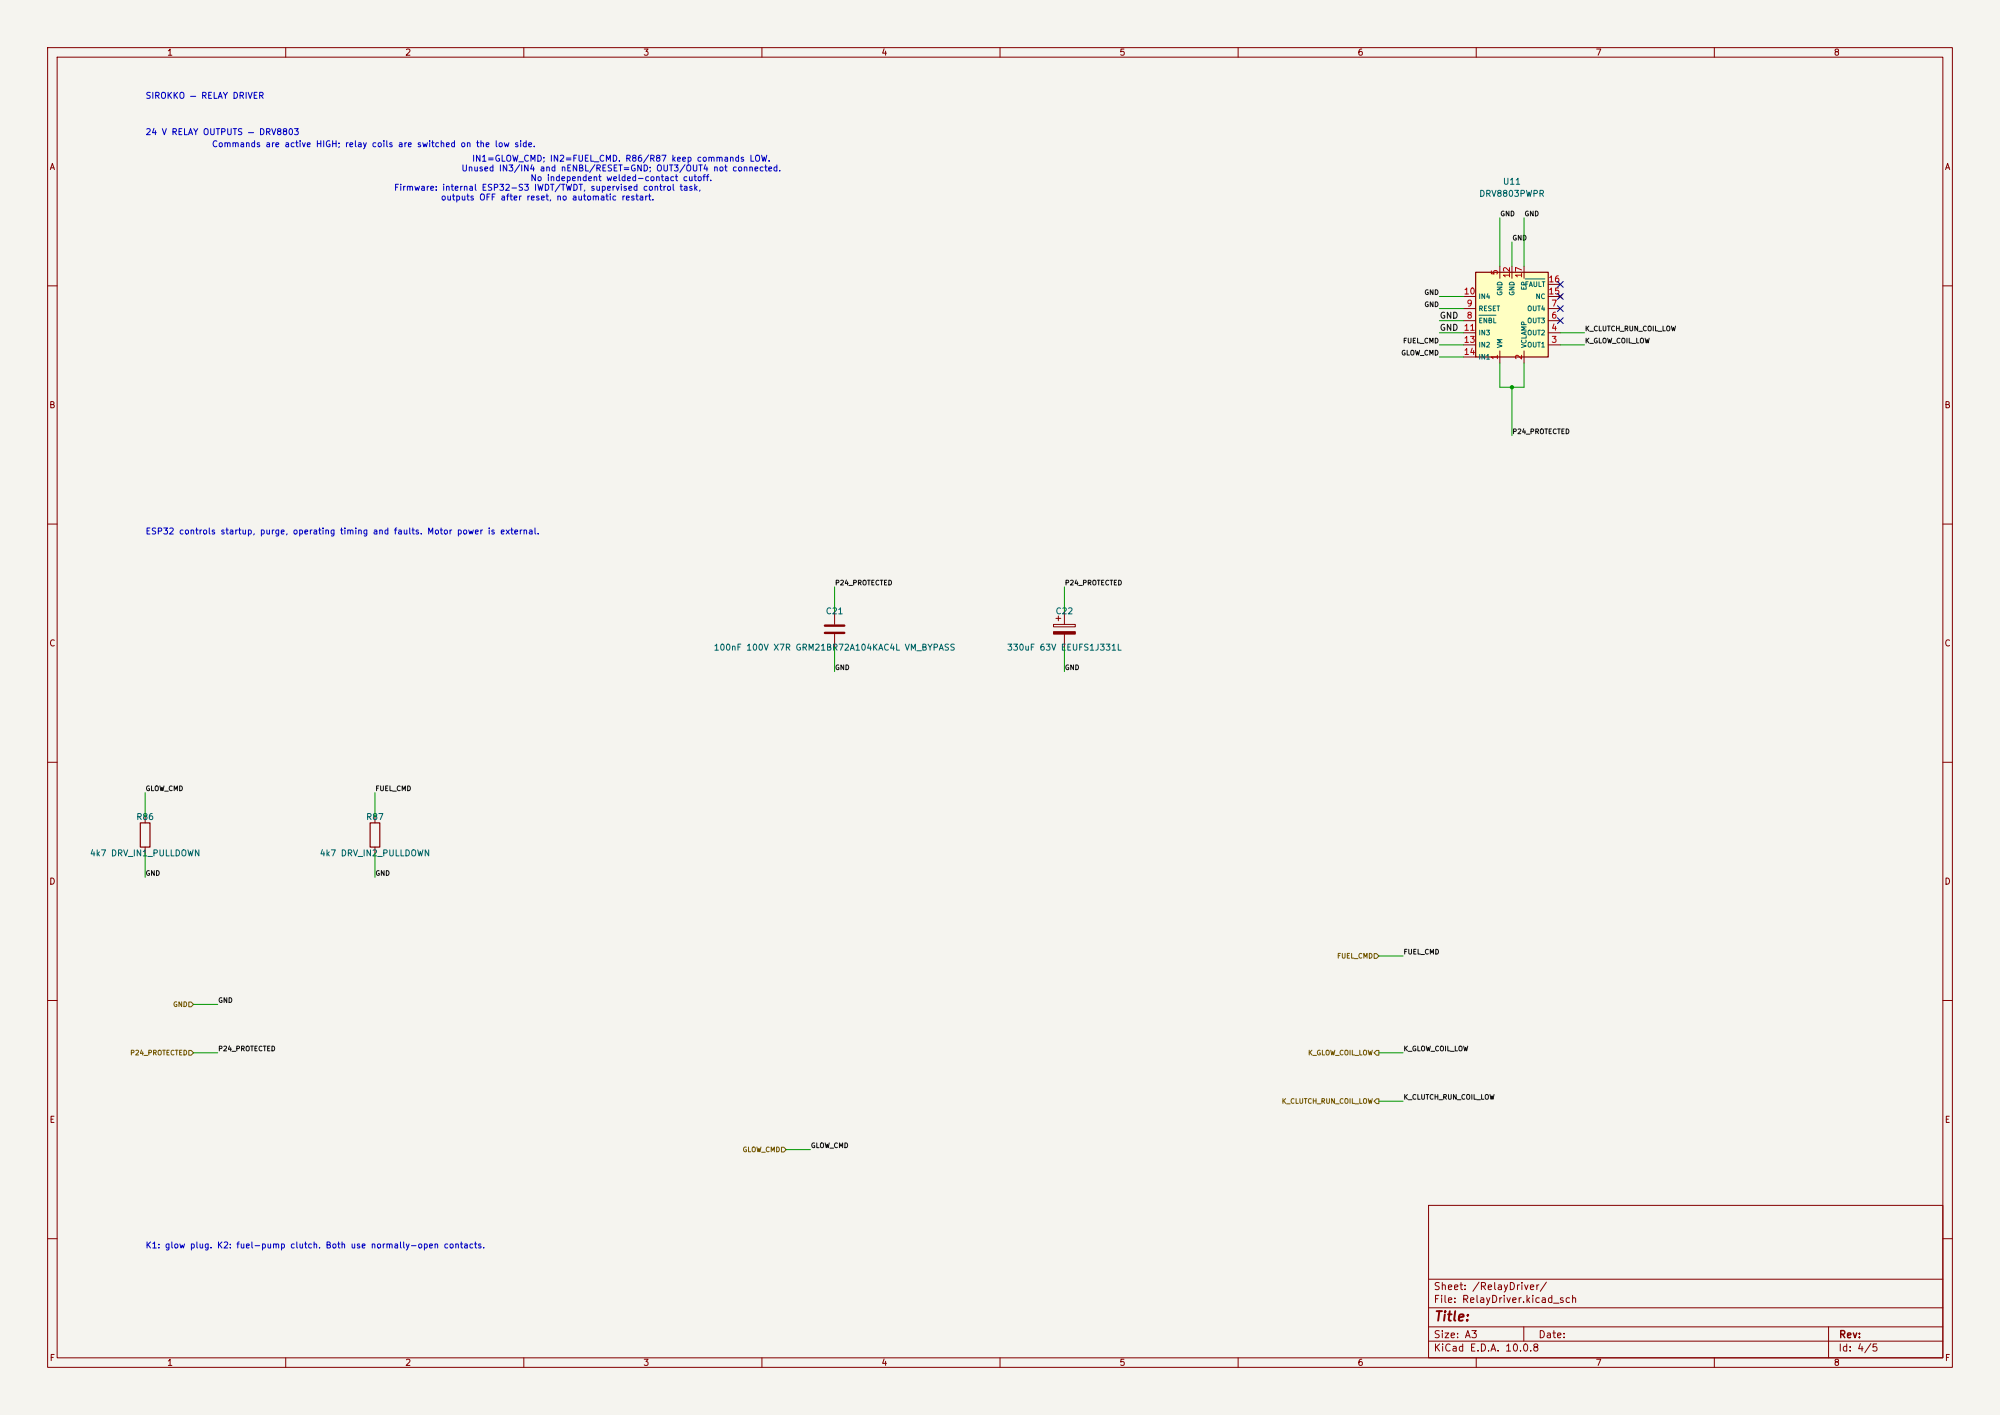
[picture p5: page 4]

P24_PROTECTED ESP32 controls startup, purge, operating timing and faults. Motor power is external. 24 V RELAY OUTPUTS — DRV8803 Commands are active HIGH; relay coils are switched on the low side. SIROKKO — RELAY DRIVER

IN1=GLOW_CMD; IN2=FUEL_CMD. R86/R87 keep commands LOW. Unused IN3/IN4 and nENBL/RESET=GND; OUT3/OUT4 not connected. No independent welded-contact cutoff.

Firmware: internal ESP32-S3 IWDT/TWDT, supervised control task,

outputs OFF after reset, no automatic restart.

K1: glow plug. K2: fuel-pump clutch. Both use normally-open contacts.

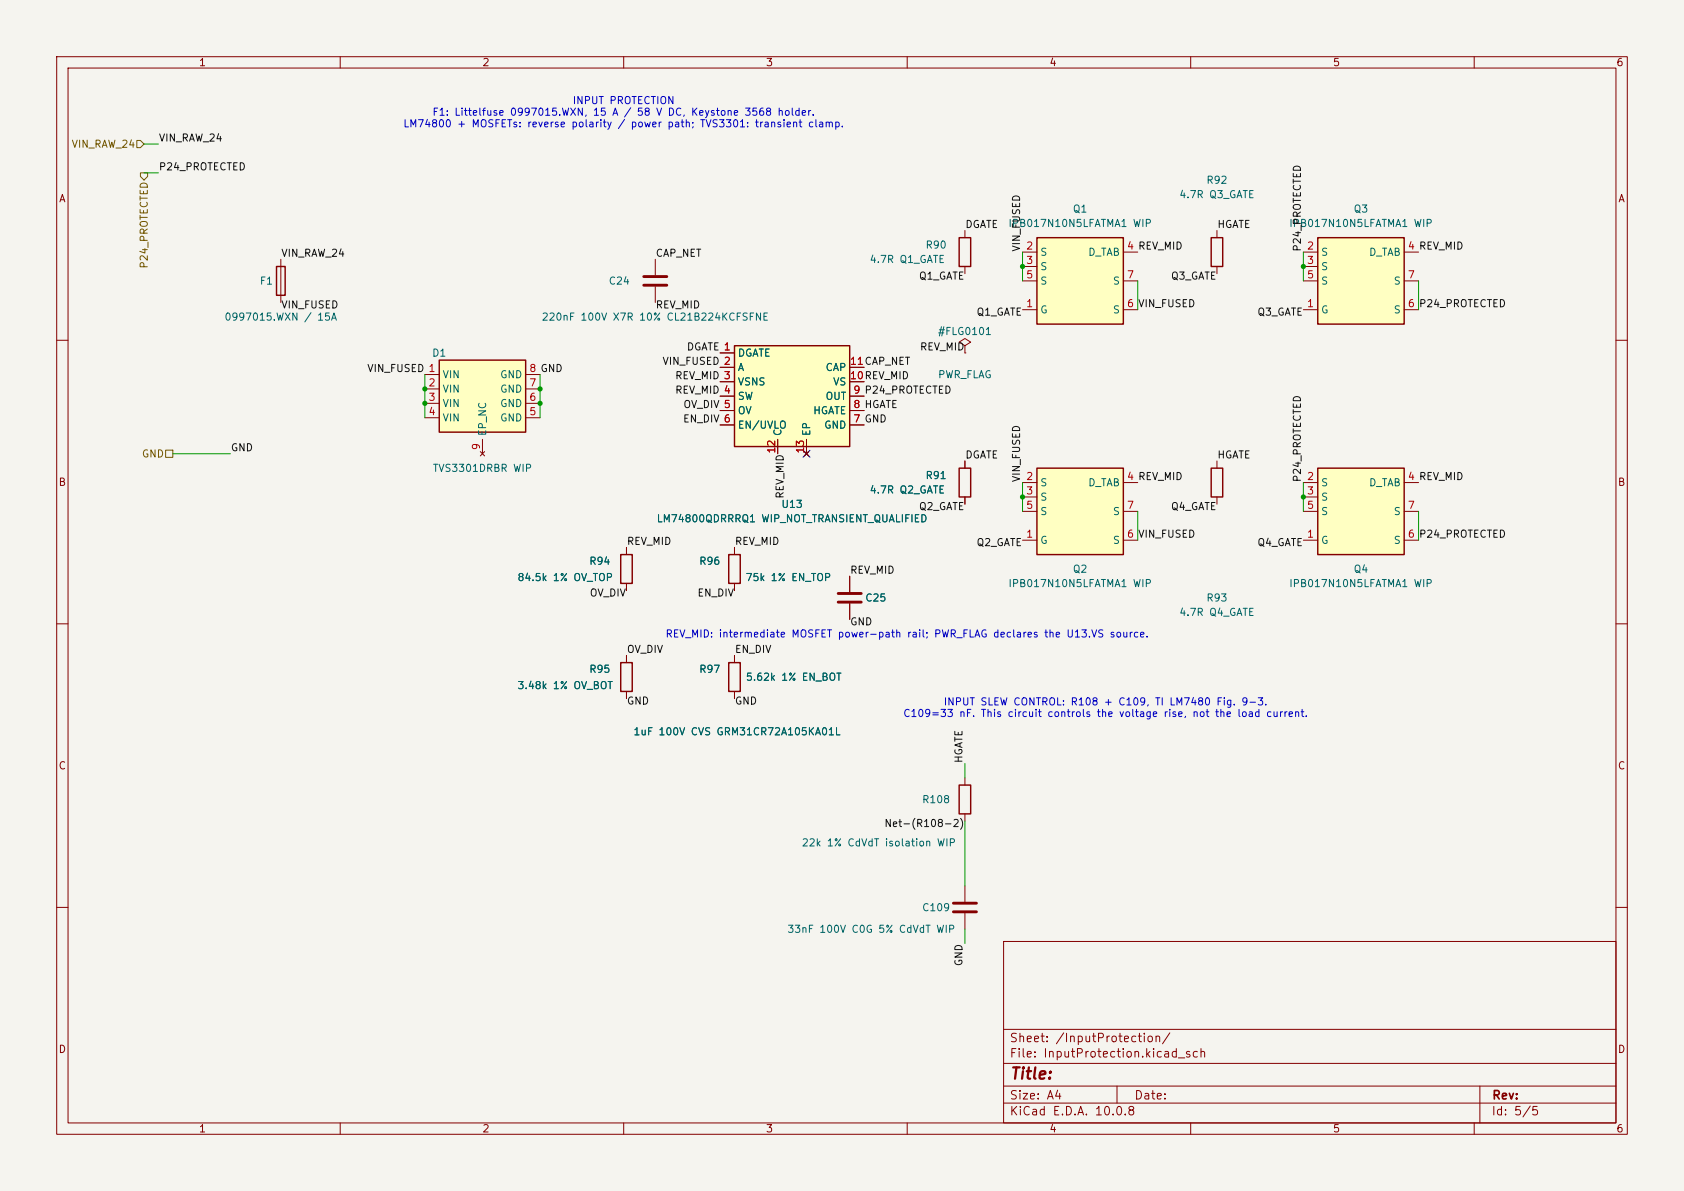
[picture p6: page 5]

F1: Littelfuse 0997015.WXN, 15 A / 58 V DC, Keystone 3568 holder. LM74800 + MOSFETs: reverse polarity / power path; TVS3301: transient clamp. REV_MID: intermediate MOSFET power-path rail; PWR_FLAG declares the U13.VS source. U13

INPUT SLEW CONTROL: R108 + C109, TI LM7480 Fig. 9-3. C109=33 nF. This circuit controls the voltage rise, not the load current.
