krolbot/sirokko-26201-controller/manufacturing/assembly/assembly.pdf

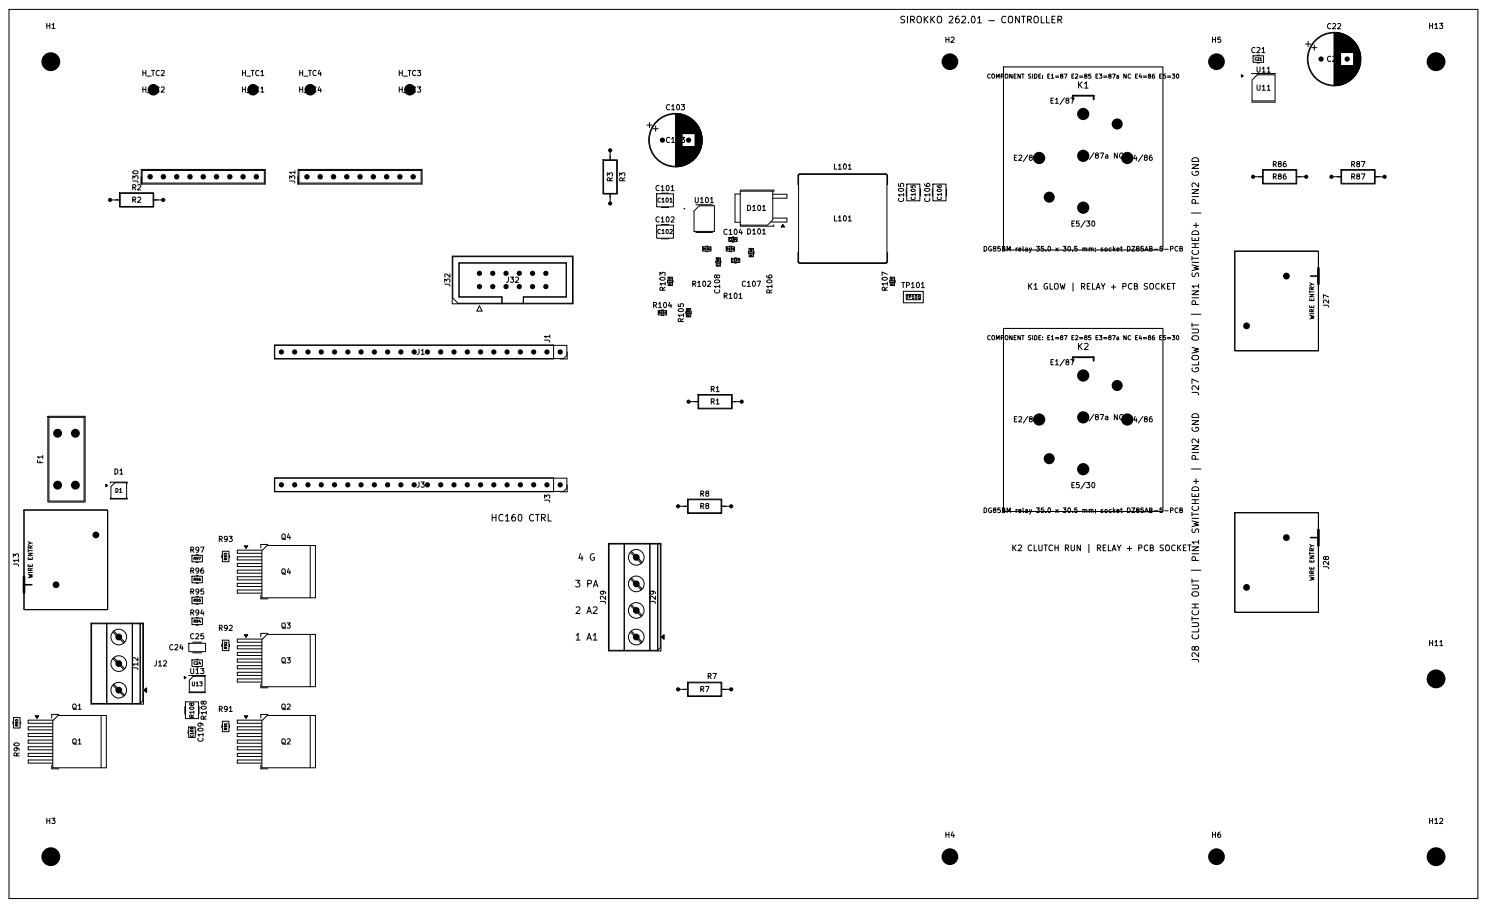
[picture p7: page 1]

K1 GLOW | RELAY + PCB SOCKET K2 CLUTCH RUN | RELAY + PCB SOCKET J27 GLOW OUT | PIN1 SWITCHED+ | PIN2 GND J28 CLUTCH OUT | PIN1 SWITCHED+ | PIN2 GND J29 C102

DG85BM relay 35.0 x 30.5 mm; socket DZ85AB-5-PCB E3/87a NC E4/86
