krolbot/sirokko-26201-controller/hardware/Sirokko.kicad_pcb

## KiCad design hardware/Sirokko.kicad_pcb (2026-11-12)

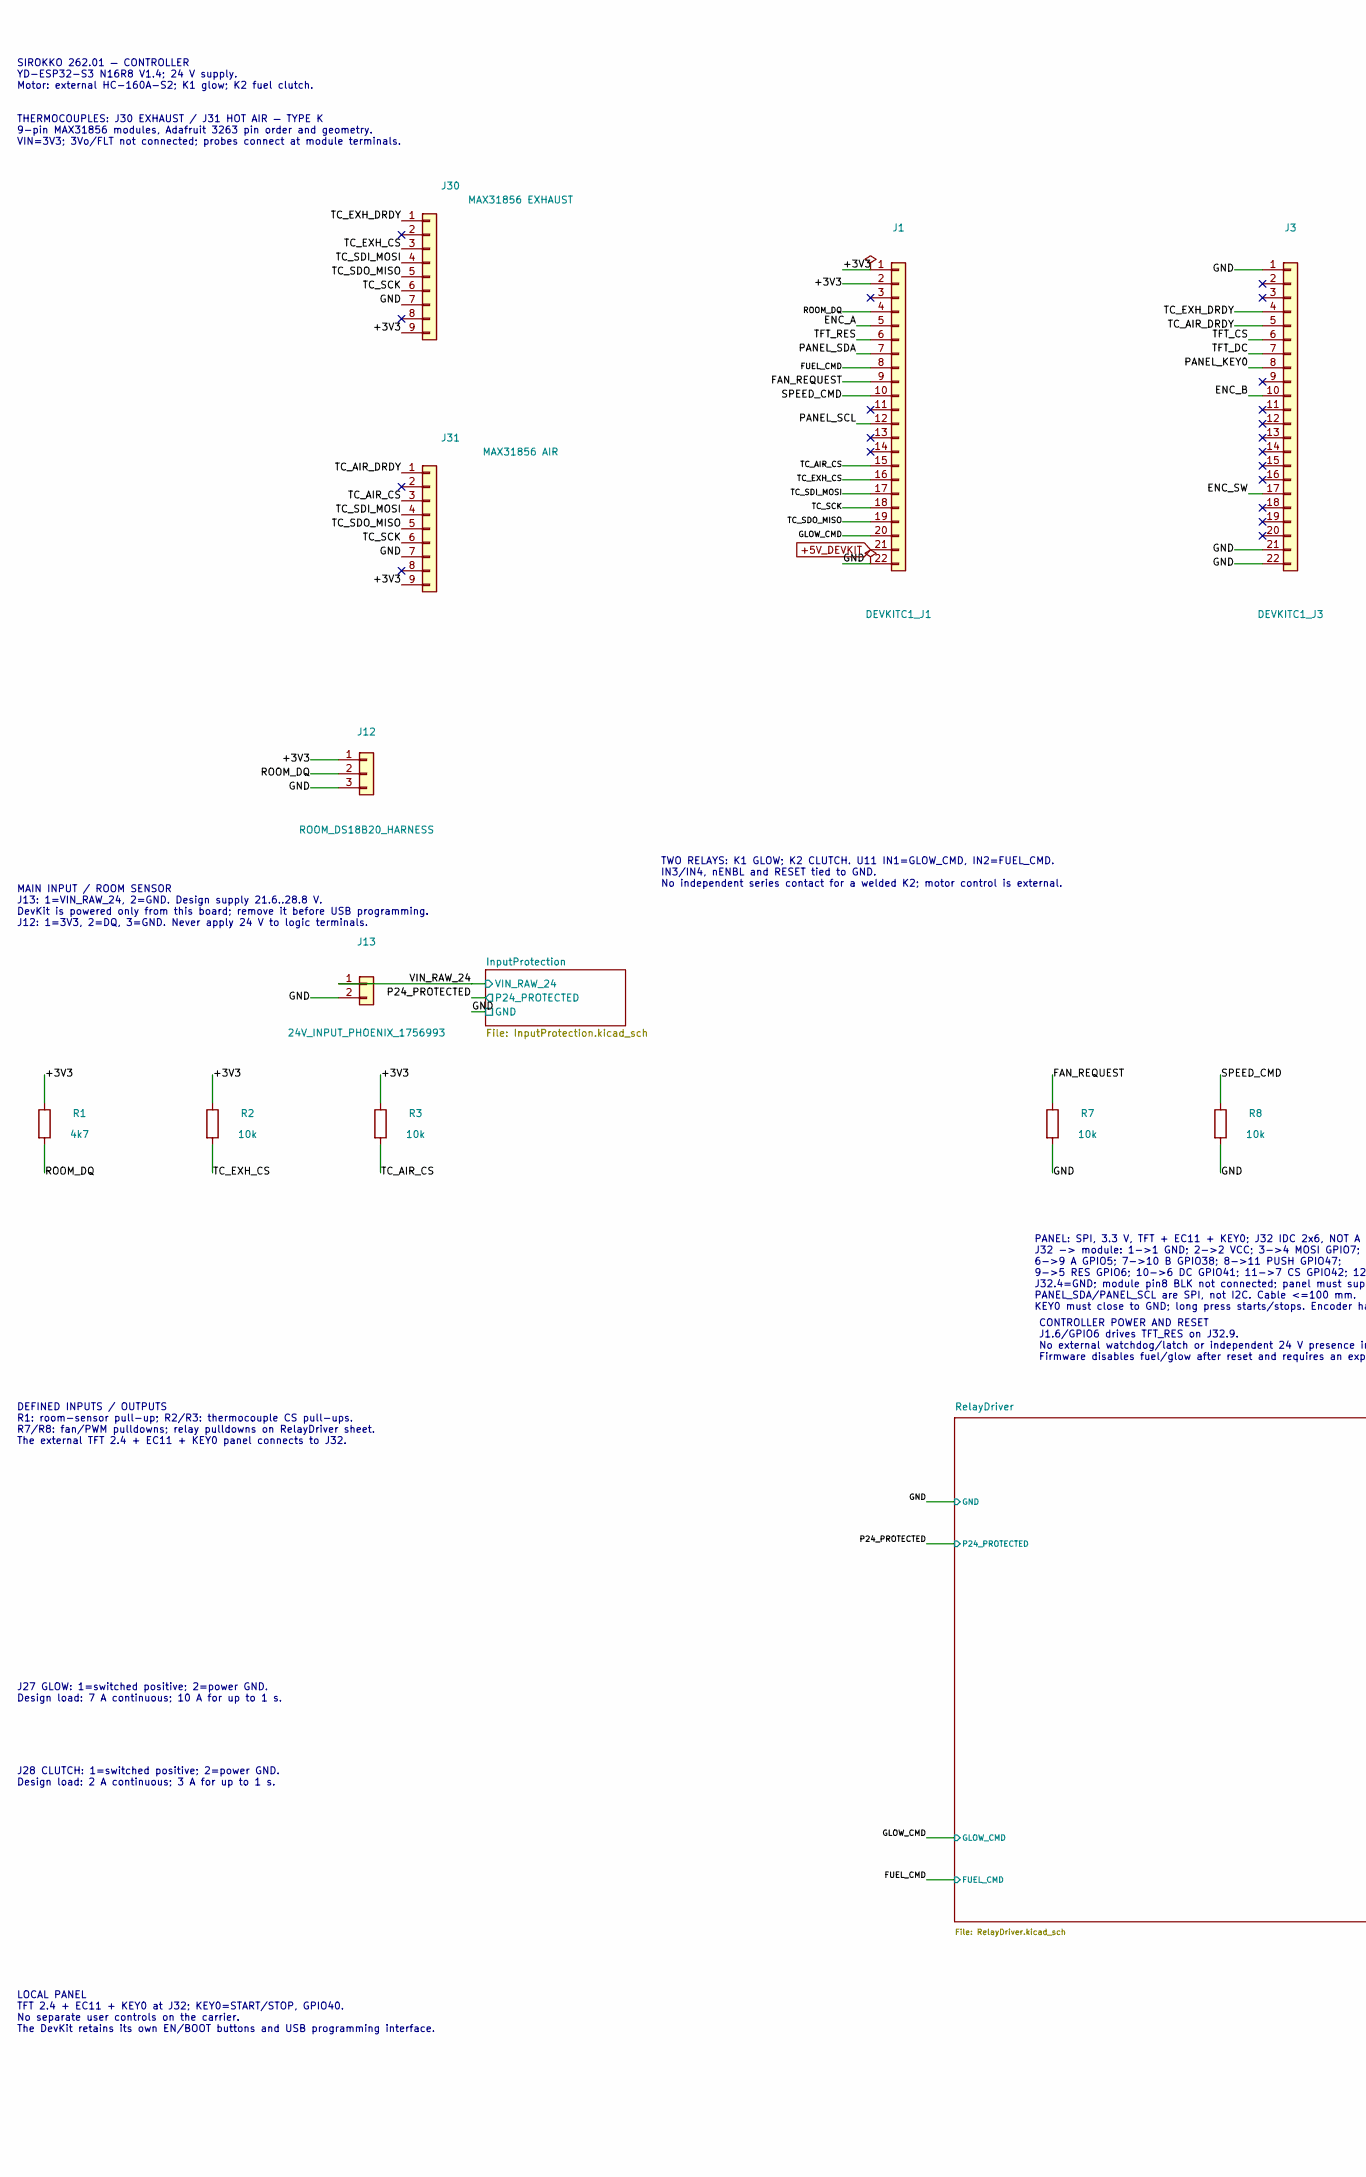
[picture p8: schematic Sirokko.kicad_sch, Sirokko 262.01 - common controller interfaces, part in row 1, column 1]

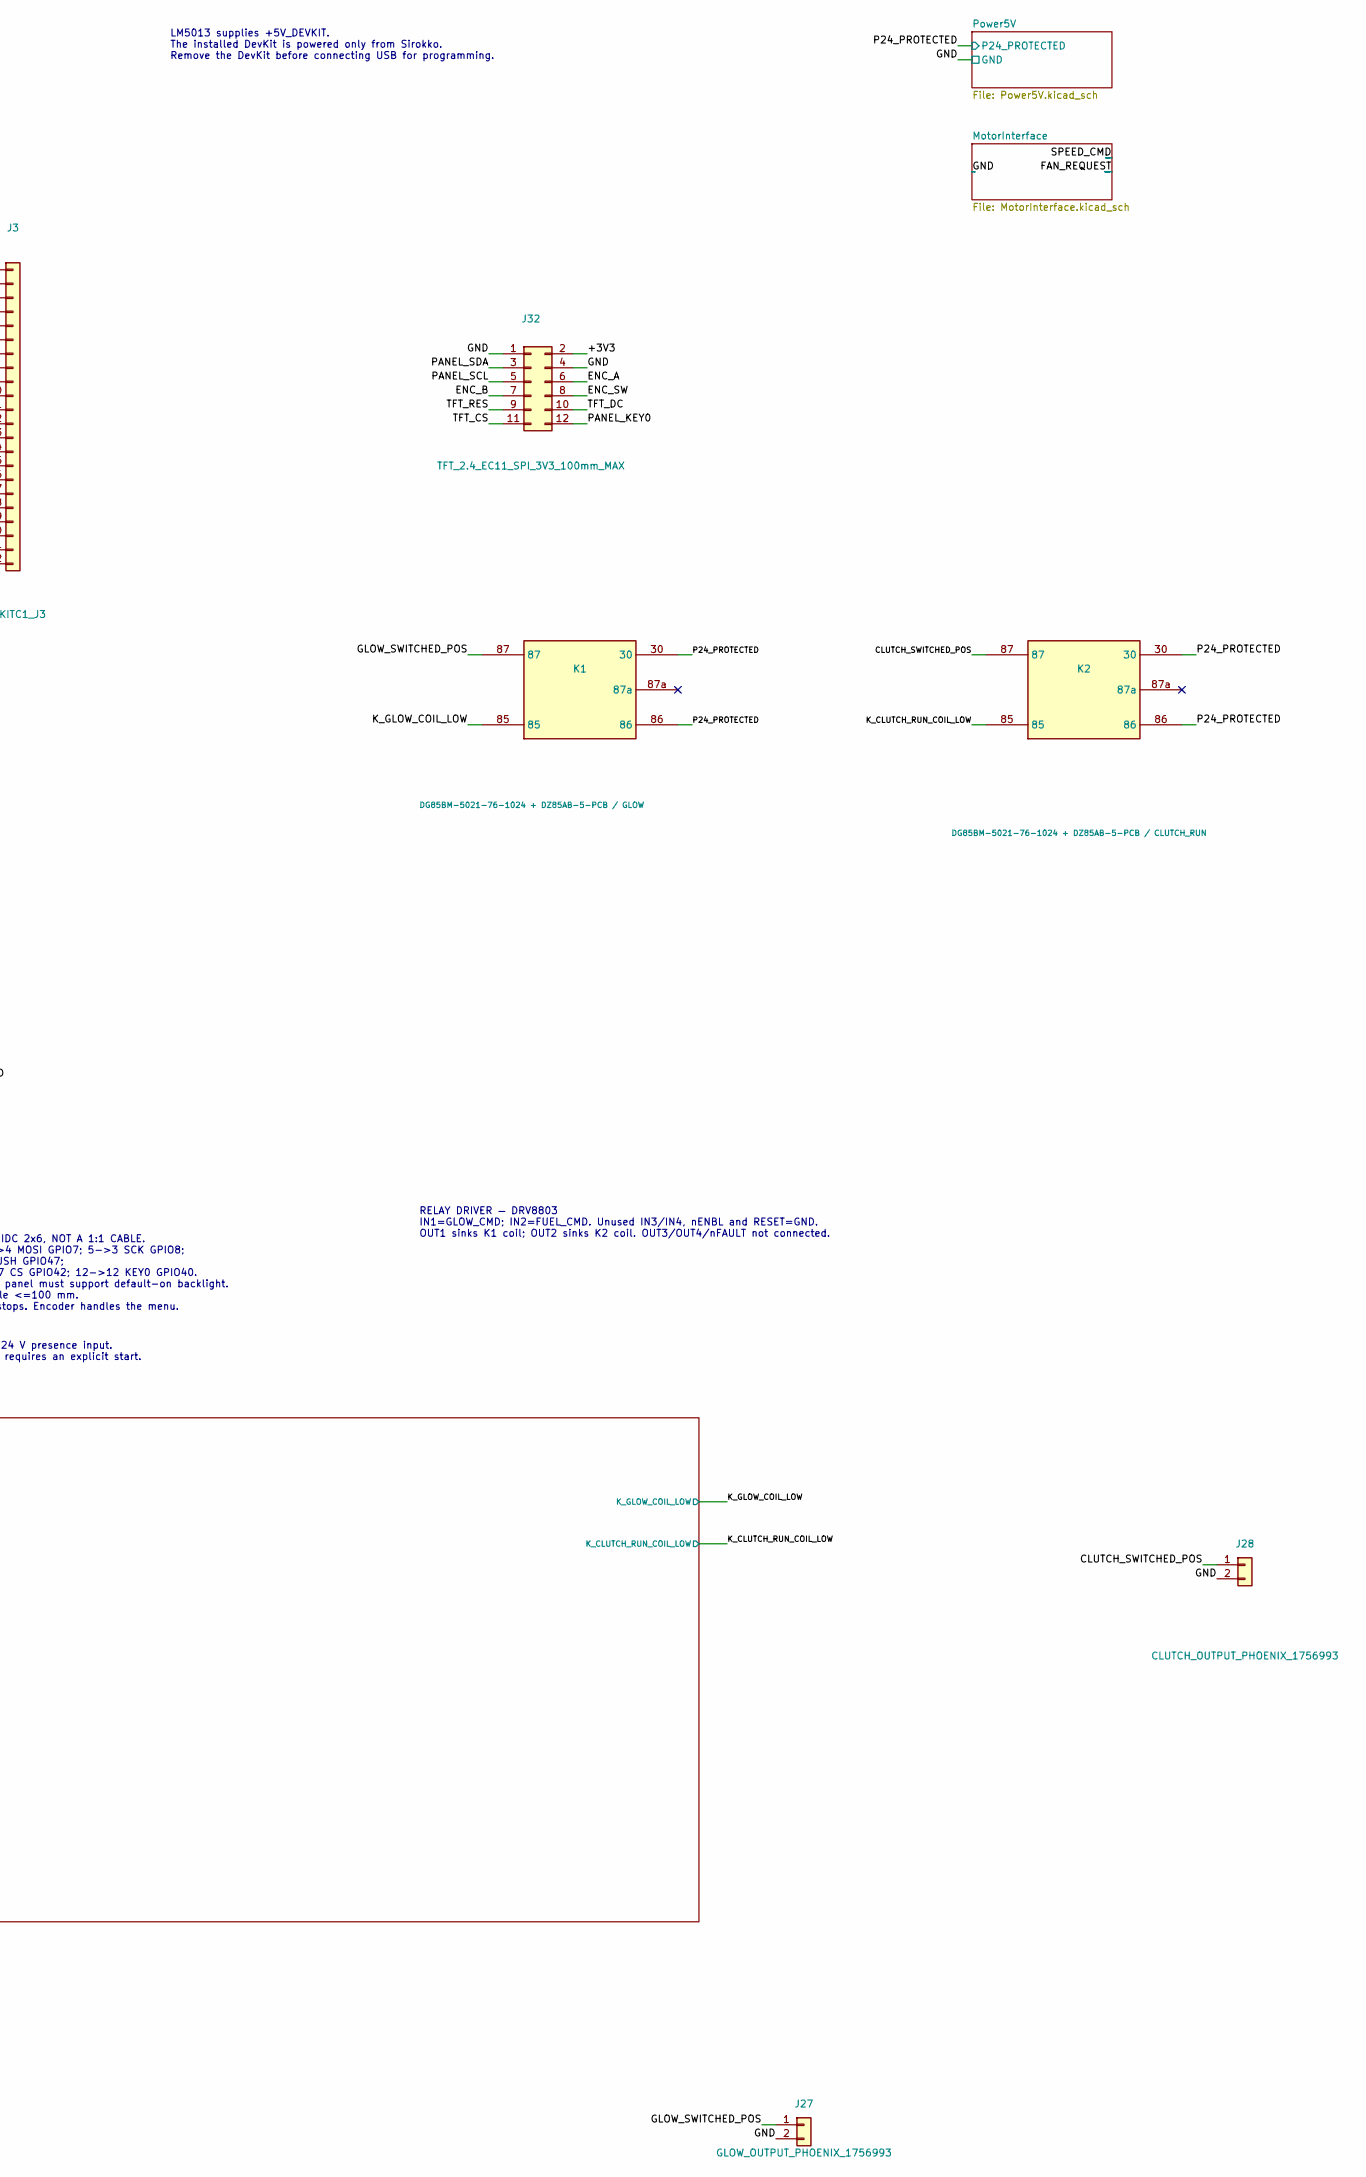
[picture p9: schematic Sirokko.kicad_sch, Sirokko 262.01 - common controller interfaces, part in row 1, column 2]

Parts:
J1: DEVKITC1_J1; PinSocket_1x22_P2.54mm_Vertical; MPN SSQ-122-01-T-S
J3: DEVKITC1_J3; PinSocket_1x22_P2.54mm_Vertical; MPN SSQ-122-01-T-S
J12: ROOM_DS18B20_HARNESS; TerminalBlock_Phoenix_MKDS-1,5-3-5.08_1x03_P5.08mm_Horizont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; MPN 1715734
J13: 24V_INPUT_PHOENIX_1756993; Phoenix_1756993_MKDS5HV_2_9.52_ZSZS; MPN 1756993
J27: GLOW_OUTPUT_PHOENIX_1756993; Phoenix_1756993_MKDS5HV_2_9.52_ZSZS; MPN 1756993
J28: CLUTCH_OUTPUT_PHOENIX_1756993; Phoenix_1756993_MKDS5HV_2_9.52_ZSZS; MPN 1756993
J30: MAX31856 EXHAUST; Samtec_SSW-109-01-T-S_1x09_P2.54mm_D1.04mm; MPN SSW-109-01-T-S
J31: MAX31856 AIR; Samtec_SSW-109-01-T-S_1x09_P2.54mm_D1.04mm; MPN SSW-109-01-T-S
J32: TFT_2.4_EC11_SPI_3V3_100mm_MAX; IDC-Header_2x06_P2.54mm_Vertical
K1: DG85BM-5021-76-1024 + DZ85AB-5-PCB / GLOW; DZ85AB_5_PCB_DG85BM; MPN DG85BM-5021-76-1024 + DZ85AB-5-PCB
K2: DG85BM-5021-76-1024 + DZ85AB-5-PCB / CLUTCH_RUN; DZ85AB_5_PCB_DG85BM; MPN DG85BM-5021-76-1024 + DZ85AB-5-PCB
R1: 4k7; R_Axial_DIN0207_L6.3mm_D2.5mm_P10.16mm_Horizontal; MPN MFR-25FTE52-4K7
R2, R3, R7, R8: 10k; R_Axial_DIN0207_L6.3mm_D2.5mm_P10.16mm_Horizontal; MPN MFR-25FBF52-10K

Connections:
+5V_DEVKIT: J1.21; also elsewhere on the board
/+3V3: J1.1, J1.2, J12.1, J30.9, J31.9, J32.2, R1.1, R2.1, R3.1
/CLUTCH_SWITCHED_POS: J28.1, K2.87
/ENC_A: J1.5, J32.6
/ENC_B: J3.10, J32.7
/ENC_SW: J3.17, J32.8
/FAN_REQUEST: J1.9, R7.1; also elsewhere on the board
/FUEL_CMD: J1.8; also elsewhere on the board
/GLOW_CMD: J1.20; also elsewhere on the board
/GLOW_SWITCHED_POS: J27.1, K1.87
/GND: J1.22, J3.1, J3.21, J3.22, J12.3, J13.2, J27.2, J28.2, J30.7, J31.7, J32.1, J32.4, R7.2, R8.2; also elsewhere on the board
/K_CLUTCH_RUN_COIL_LOW: K2.85; also elsewhere on the board
/K_GLOW_COIL_LOW: K1.85; also elsewhere on the board
/P24_PROTECTED: K1.30, K1.86, K2.30, K2.86; also elsewhere on the board
/PANEL_KEY0: J3.8, J32.12
/PANEL_SCL: J1.12, J32.5
/PANEL_SDA: J1.7, J32.3
/ROOM_DQ: J1.4, J12.2, R1.2
/SPEED_CMD: J1.10, R8.1; also elsewhere on the board
/TC_AIR_CS: J1.15, J31.3, R3.2
/TC_AIR_DRDY: J3.5, J31.1
/TC_EXH_CS: J1.16, J30.3, R2.2
/TC_EXH_DRDY: J3.4, J30.1
/TC_SCK: J1.18, J30.6, J31.6
/TC_SDI_MOSI: J1.17, J30.4, J31.4
/TC_SDO_MISO: J1.19, J30.5, J31.5
/TFT_CS: J3.6, J32.11
/TFT_DC: J3.7, J32.10
/TFT_RES: J1.6, J32.9
/VIN_RAW_24: J13.1; also elsewhere on the board

Notes on the sheet:
SIROKKO 262.01 — CONTROLLER YD-ESP32-S3 N16R8 V1.4; 24 V supply. Motor: external HC-160A-S2; K1 glow; K2 fuel clutch.
THERMOCOUPLES: J30 EXHAUST / J31 HOT AIR — TYPE K 9-pin MAX31856 modules, Adafruit 3263 pin order and geometry. VIN=3V3; 3Vo/FLT not connected; probes connect at module terminals.
TWO RELAYS: K1 GLOW; K2 CLUTCH. U11 IN1=GLOW_CMD, IN2=FUEL_CMD. IN3/IN4, nENBL and RESET tied to GND. No independent series contact for a welded K2; motor control is external.
MAIN INPUT / ROOM SENSOR J13: 1=VIN_RAW_24, 2=GND. Design supply 21.6..28.8 V. DevKit is powered only from this board; remove it before USB programming. J12: 1=3V3, 2=DQ, 3=GND. Never apply 24 V to logic terminals.
DEFINED INPUTS / OUTPUTS R1: room-sensor pull-up; R2/R3: thermocouple CS pull-ups. R7/R8: fan/PWM pulldowns; relay pulldowns on RelayDriver sheet. The external TFT 2.4 + EC11 + KEY0 panel connects to J32.
CONTROLLER POWER AND RESET J1.6/GPIO6 drives TFT_RES on J32.9. No external watchdog/latch or independent 24 V presence input. Firmware disables fuel/glow after reset and requires an explicit start.
LM5013 supplies +5V_DEVKIT. The installed DevKit is powered only from Sirokko. Remove the DevKit before connecting USB for programming.
J27 GLOW: 1=switched positive; 2=power GND. Design load: 7 A continuous; 10 A for up to 1 s.
J28 CLUTCH: 1=switched positive; 2=power GND. Design load: 2 A continuous; 3 A for up to 1 s.
RELAY DRIVER — DRV8803 IN1=GLOW_CMD; IN2=FUEL_CMD. Unused IN3/IN4, nENBL and RESET=GND. OUT1 sinks K1 coil; OUT2 sinks K2 coil. OUT3/OUT4/nFAULT not connected.
LOCAL PANEL TFT 2.4 + EC11 + KEY0 at J32; KEY0=START/STOP, GPIO40. No separate user controls on the carrier. The DevKit retains its own EN/BOOT buttons and USB programming interface.
PANEL: SPI, 3.3 V, TFT + EC11 + KEY0; J32 IDC 2x6, NOT A 1:1 CABLE. J32 -> module: 1->1 GND; 2->2 VCC; 3->4 MOSI GPIO7; 5->3 SCK GPIO8; 6->9 A GPIO5; 7->10 B GPIO38; 8->11 PUSH GPIO47; 9->5 RES GPIO6; 10->6 DC GPIO41; 11->7 CS GPIO42; 12->12 KEY0 GPIO40. J32.4=GND; module pin8 BLK not connected; pa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

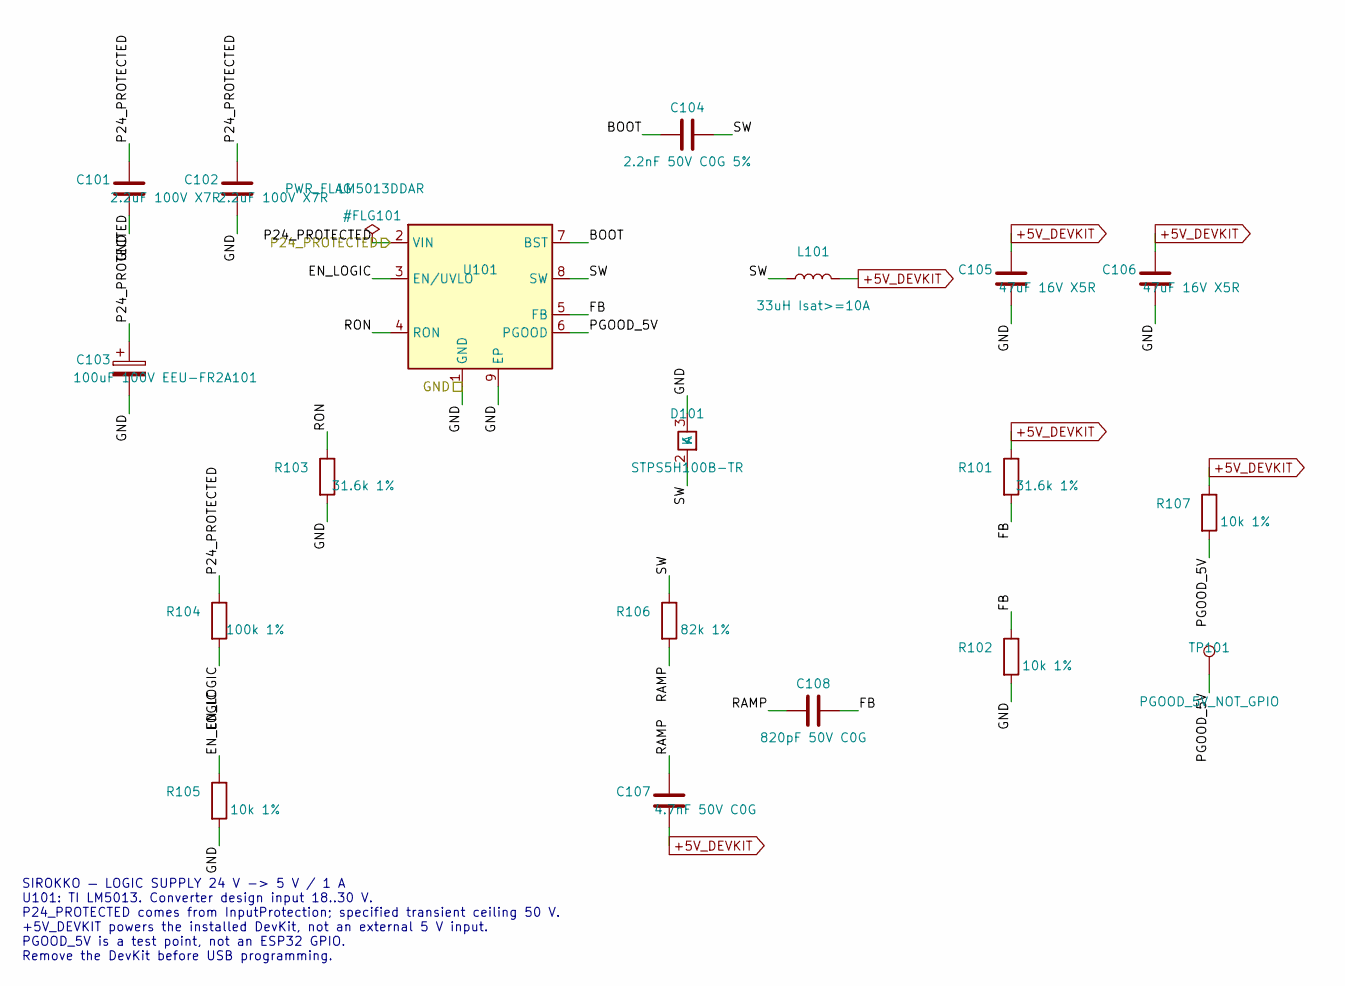
[picture p10: schematic Power5V.kicad_sch]

Parts:
C101, C102: 2.2uF 100V X7R; C_1210_3225Metric; MPN GRM32ER72A225KA35L
C103: 100uF 100V EEU-FR2A101; CP_Radial_D10.0mm_P5.00mm_Courtyard_D11.0mm; MPN EEU-FR2A101
C104: 2.2nF 50V C0G 5%; C_0603_1608Metric; MPN GRM1885C1H222JA01D
C105, C106: 47uF 16V X5R; C_1210_3225Metric; MPN GRM32ER61C476KE15L
C107: 4.7nF 50V C0G; C_0603_1608Metric; MPN GRM1885C1H472JA01D
C108: 820pF 50V C0G; C_0603_1608Metric; MPN CC0603JRNPO9BN821
D101: STPS5H100B-TR; TO-252-2; MPN STPS5H100B-TR
L101: 33uH Isat>=10A; L_Bourns_SRP1770TA_16.9x16.9mm; MPN SRP1770TA-330M
R101, R103: 31.6k 1%; R_0603_1608Metric; MPN RC0603FR-0731K6L
R102, R105, R107: 10k 1%; R_0603_1608Metric; MPN RC0603FR-0710KL
R104: 100k 1%; R_0603_1608Metric; MPN RC0603FR-07100KL
R106: 82k 1%; R_0603_1608Metric; MPN RC0603FR-0782KL
TP101: PGOOD_5V_NOT_GPIO; TestPoint_Keystone_5015_Micro_Mini; MPN 5015
U101: LM5013DDAR; DDA0008B_LM5013DDAR_TI4214849B; MPN LM5013DDAR

Connections:
+5V_DEVKIT: C105.1, C106.1, C107.2, L101.2, R101.1, R107.1; also elsewhere on the board
/GND: C101.2, C102.2, C103.2, C105.2, C106.2, D101.3 (A), R102.2, R103.2, R105.2, U101.1 (GND), U101.9 (EP); also elsewhere on the board
/P24_PROTECTED: C101.1, C102.1, C103.1, R104.1, U101.2 (VIN); also elsewhere on the board
/Power5V/BOOT: C104.1, U101.7 (BST)
/Power5V/EN_LOGIC: R104.2, R105.1, U101.3 (EN/UVLO)
/Power5V/FB: C108.2, R101.2, R102.1, U101.5 (FB)
/Power5V/PGOOD_5V: R107.2, TP101.1, U101.6 (PGOOD)
/Power5V/RAMP: C107.1, C108.1, R106.2
/Power5V/RON: R103.1, U101.4 (RON)
/Power5V/SW: C104.2, D101.2 (K), L101.1, R106.1, U101.8 (SW)

Notes on the sheet:
SIROKKO — LOGIC SUPPLY 24 V -> 5 V / 1 A U101: TI LM5013. Converter design input 18..30 V. P24_PROTECTED comes from InputProtection; specified transient ceiling 50 V. +5V_DEVKIT powers the installed DevKit, not an external 5 V input. PGOOD_5V is a test point, not an ESP32 GPIO. Remove the DevKit be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

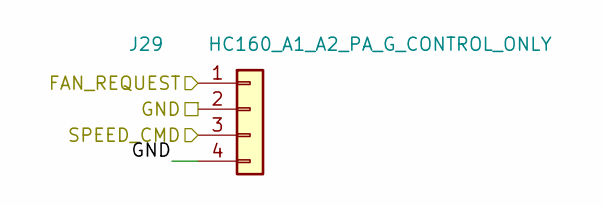
[picture p11: schematic MotorInterface.kicad_sch]

Parts:
J29: HC160_A1_A2_PA_G_CONTROL_ONLY; TerminalBlock_Phoenix_MKDS-1,5-4-5.08_1x04_P5.08mm_Horizont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; MPN 1715747

Connections:
/FAN_REQUEST: J29.1; also elsewhere on the board
/GND: J29.2, J29.4; also elsewhere on the board
/SPEED_CMD: J29.3; also elsewhere on the board

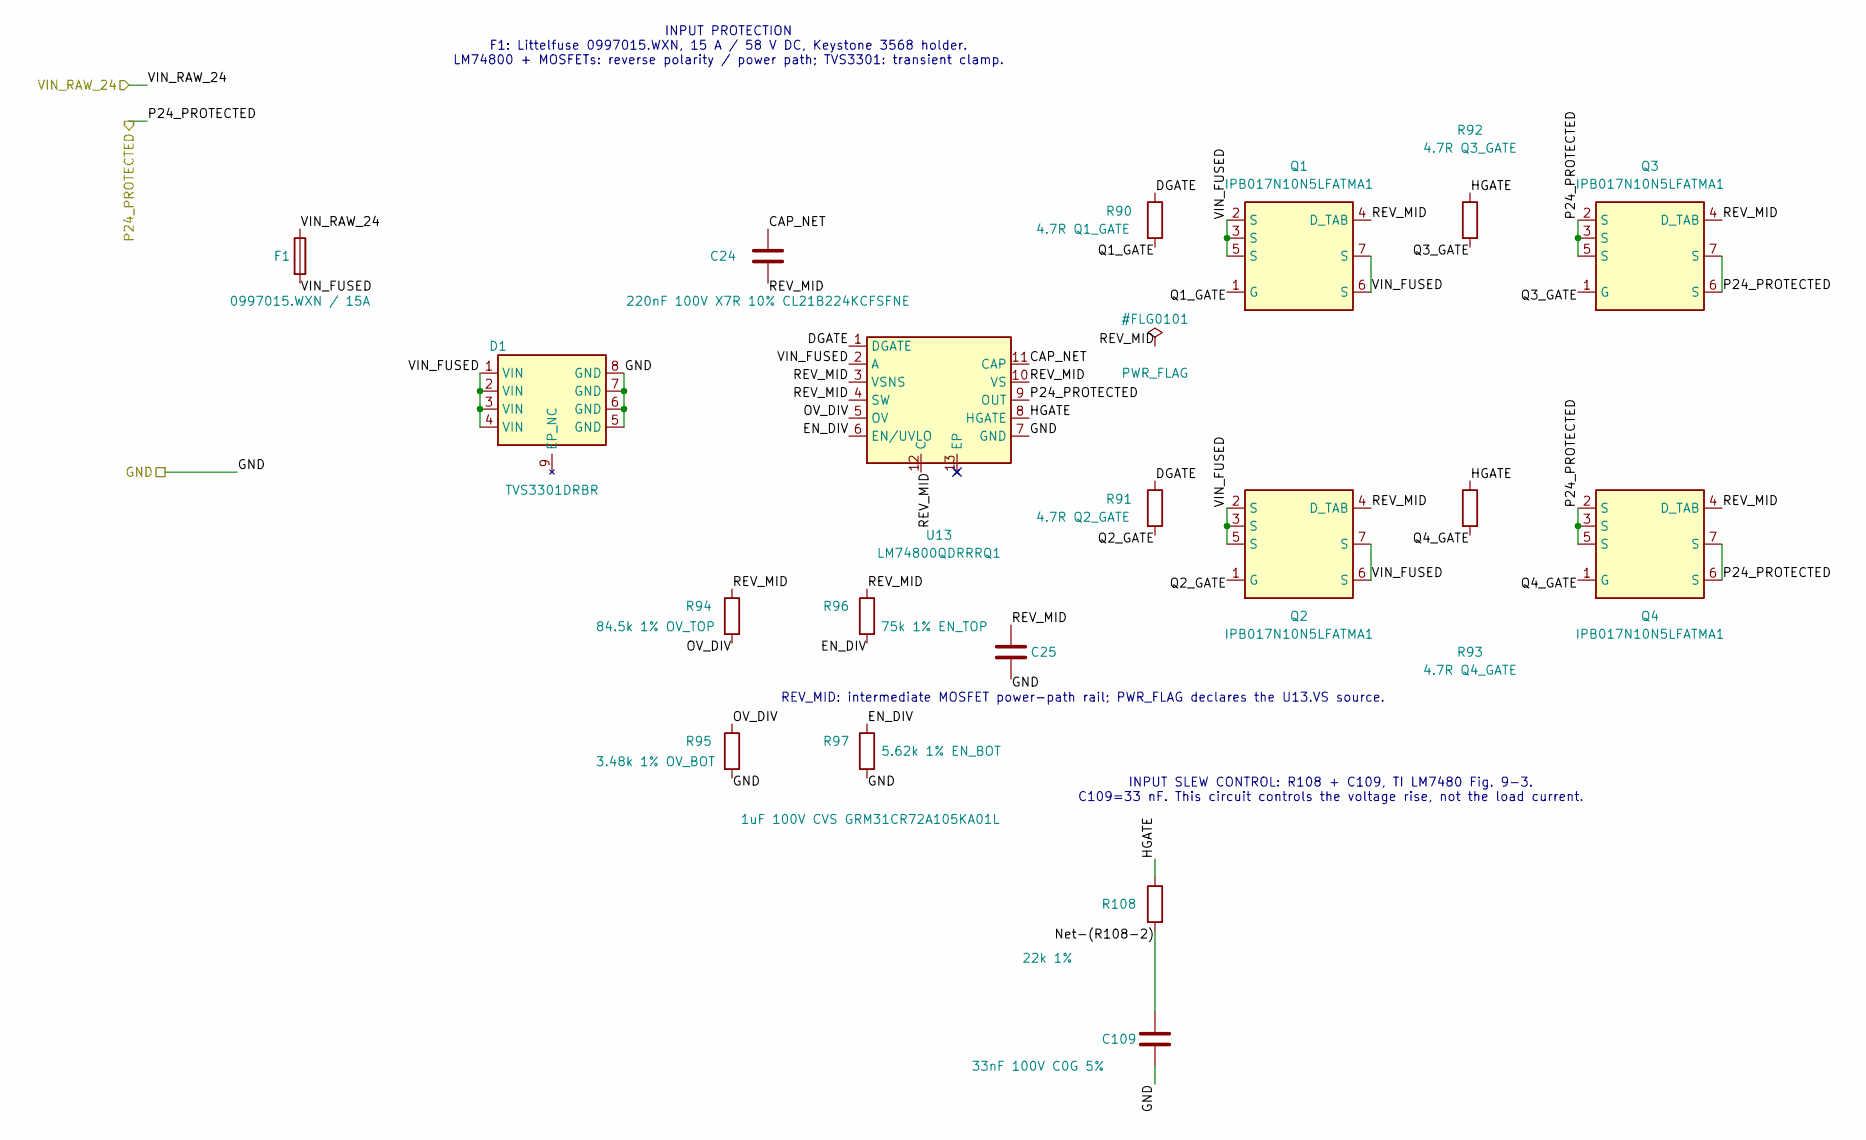
[picture p12: schematic InputProtection.kicad_sch]

Parts:
C24: 220nF 100V X7R 10% CL21B224KCFSFNE; C_0805_2012Metric; MPN CL21B224KCFSFNE
C25: 1uF 100V CVS GRM31CR72A105KA01L; GRM31_1206_Murata_Reflow; MPN GRM31CR72A105KA01L
C109: 33nF 100V C0G 5%; C_0805_2012Metric; MPN GRM2195C2A333JE01J
D1: TVS3301DRBR; VSON-8-1EP_3x3mm_P0.65mm_EP1.65x2.4mm; MPN TVS3301DRBR
F1: 0997015.WXN / 15A; Keystone_3568_MINI_Blade; MPN 0997015.WXN + 3568
Q1, Q2, Q3, Q4: IPB017N10N5LFATMA1; Infineon_PG_TO263_7_IPB017N10N5LF; MPN IPB017N10N5LFATMA1
R90: 4.7R Q1_GATE; R_0805_2012Metric; MPN RC0805FR-074R7L
R91: 4.7R Q2_GATE; R_0805_2012Metric; MPN RC0805FR-074R7L
R92: 4.7R Q3_GATE; R_0805_2012Metric; MPN RC0805FR-074R7L
R93: 4.7R Q4_GATE; R_0805_2012Metric; MPN RC0805FR-074R7L
R94: 84.5k 1% OV_TOP; R_0805_2012Metric; MPN RC0805FR-0784K5L
R95: 3.48k 1% OV_BOT; R_0805_2012Metric; MPN RC0805FR-073K48L
R96: 75k 1% EN_TOP; R_0805_2012Metric; MPN RC0805FR-0775KL
R97: 5.62k 1% EN_BOT; R_0805_2012Metric; MPN RC0805FR-075K62L
R108: 22k 1%; R_1210_3225Metric; MPN RC1210FR-0722KL
U13: LM74800QDRRRQ1; WSON-12-1EP_3x3mm_P0.5mm_EP1.5x2.5mm; MPN LM74800QDRRRQ1

Connections:
/GND: C25.2, C109.2, D1.5 (GND), D1.6 (GND), D1.7 (GND), D1.8 (GND), R95.2, R97.2, U13.7 (GND); also elsewhere on the board
/InputProtection/CAP_NET: C24.1, U13.11 (CAP)
/InputProtection/DGATE: R90.1, R91.1, U13.1 (DGATE)
/InputProtection/EN_DIV: R96.2, R97.1, U13.6 (EN/UVLO)
/InputProtection/HGATE: R92.1, R93.1, R108.1, U13.8 (HGATE)
/InputProtection/Net-(R108-2): C109.1, R108.2
/InputProtection/OV_DIV: R94.2, R95.1, U13.5 (OV)
/InputProtection/Q1_GATE: Q1.1 (G), R90.2
/InputProtection/Q2_GATE: Q2.1 (G), R91.2
/InputProtection/Q3_GATE: Q3.1 (G), R92.2
/InputProtection/Q4_GATE: Q4.1 (G), R93.2
/InputProtection/REV_MID: C24.2, C25.1, Q1.4 (D_TAB), Q2.4 (D_TAB), Q3.4 (D_TAB), Q4.4 (D_TAB), R94.1, R96.1, U13.3 (VSNS), U13.4 (SW), U13.10 (VS), U13.12 (C)
/InputProtection/VIN_FUSED: D1.1 (VIN), D1.2 (VIN), D1.3 (VIN), D1.4 (VIN), F1.2, Q1.2 (S), Q1.3 (S), Q1.5 (S), Q1.6 (S), Q1.7 (S), Q2.2 (S), Q2.3 (S), Q2.5 (S), Q2.6 (S), Q2.7 (S), U13.2 (A)
/P24_PROTECTED: Q3.2 (S), Q3.3 (S), Q3.5 (S), Q3.6 (S), Q3.7 (S), Q4.2 (S), Q4.3 (S), Q4.5 (S), Q4.6 (S), Q4.7 (S), U13.9 (OUT); also elsewhere on the board
/VIN_RAW_24: F1.1; also elsewhere on the board

Notes on the sheet:
REV_MID: intermediate MOSFET power-path rail; PWR_FLAG declares the U13.VS source.
INPUT SLEW CONTROL: R108 + C109, TI LM7480 Fig. 9-3. C109=33 nF. This circuit controls the voltage rise, not the load current.
INPUT PROTECTION F1: Littelfuse 0997015.WXN, 15 A / 58 V DC, Keystone 3568 holder. LM74800 + MOSFETs: reverse polarity / power path; TVS3301: transient clamp.

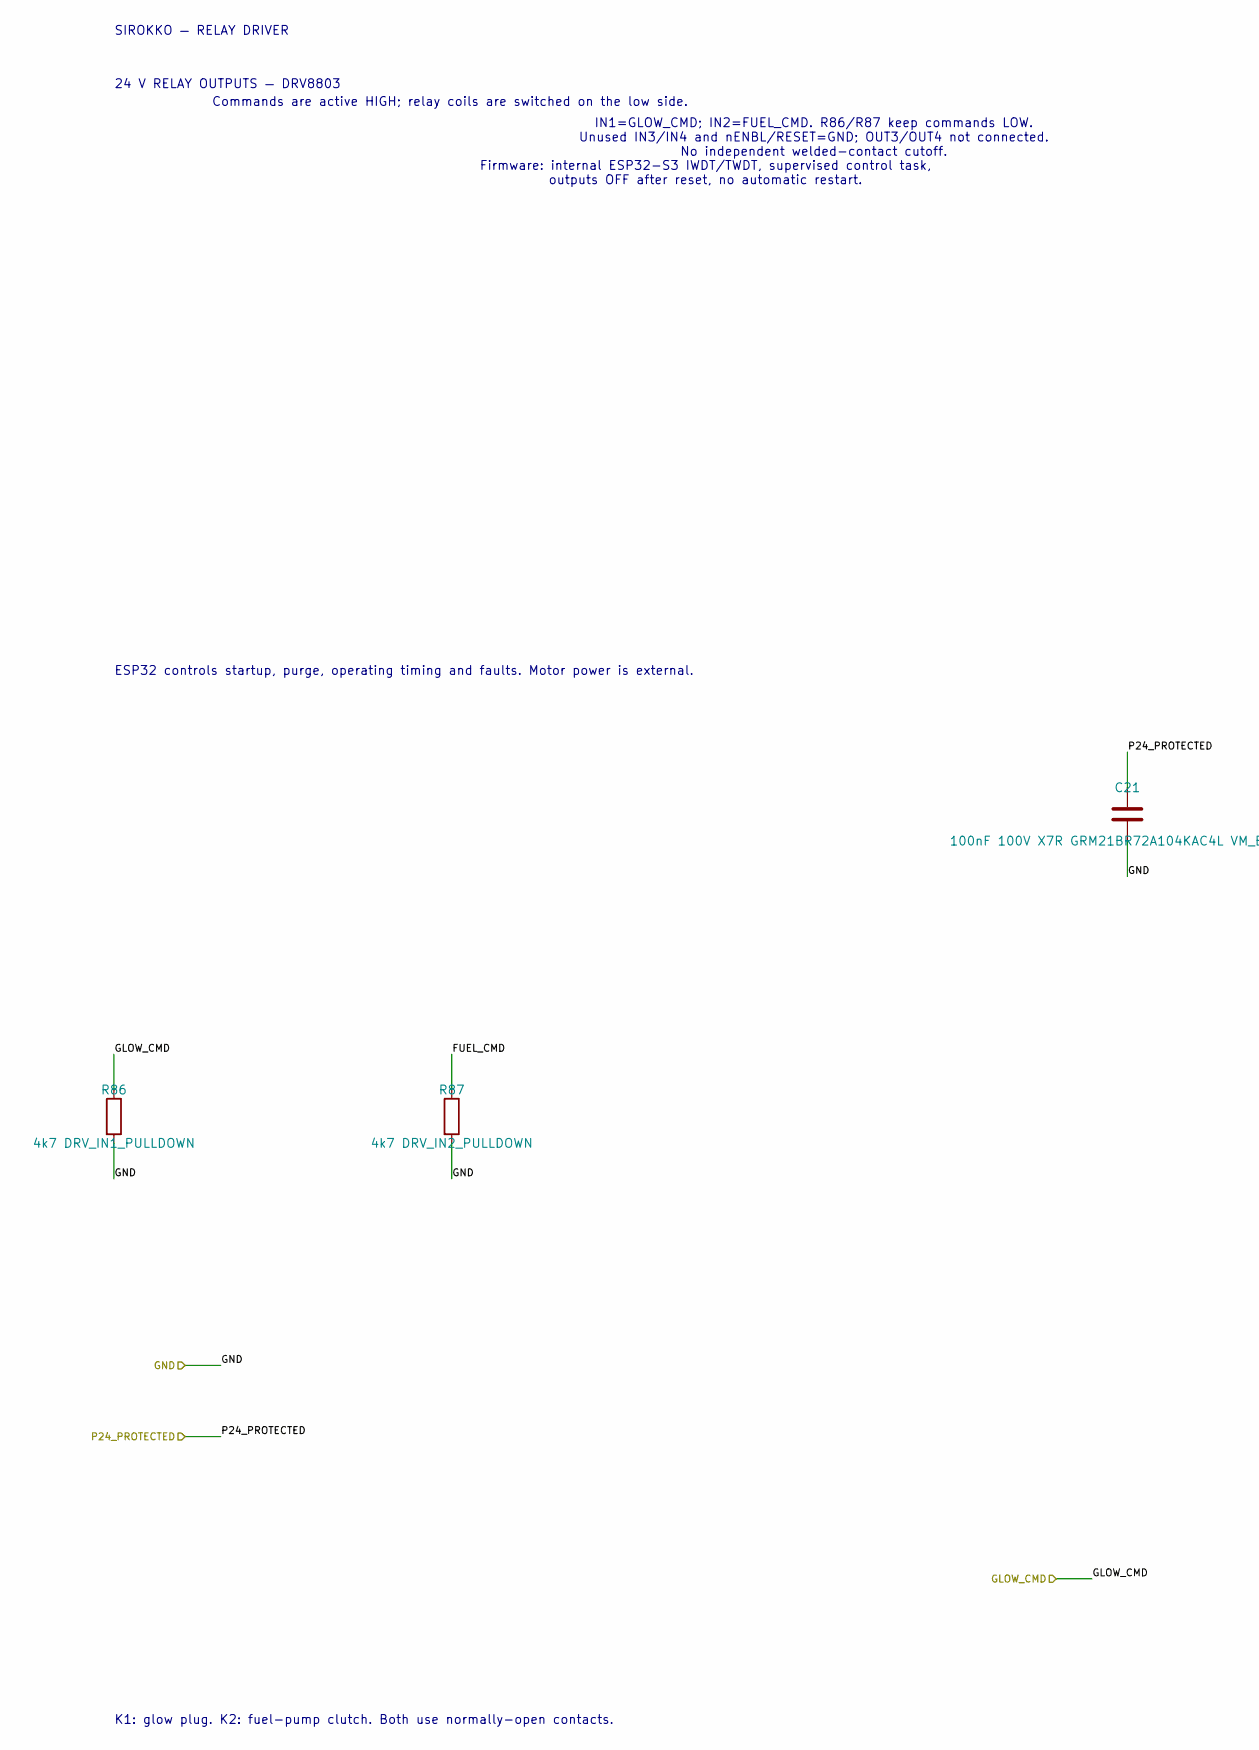
[picture p13: schematic RelayDriver.kicad_sch, part in row 1, column 1]

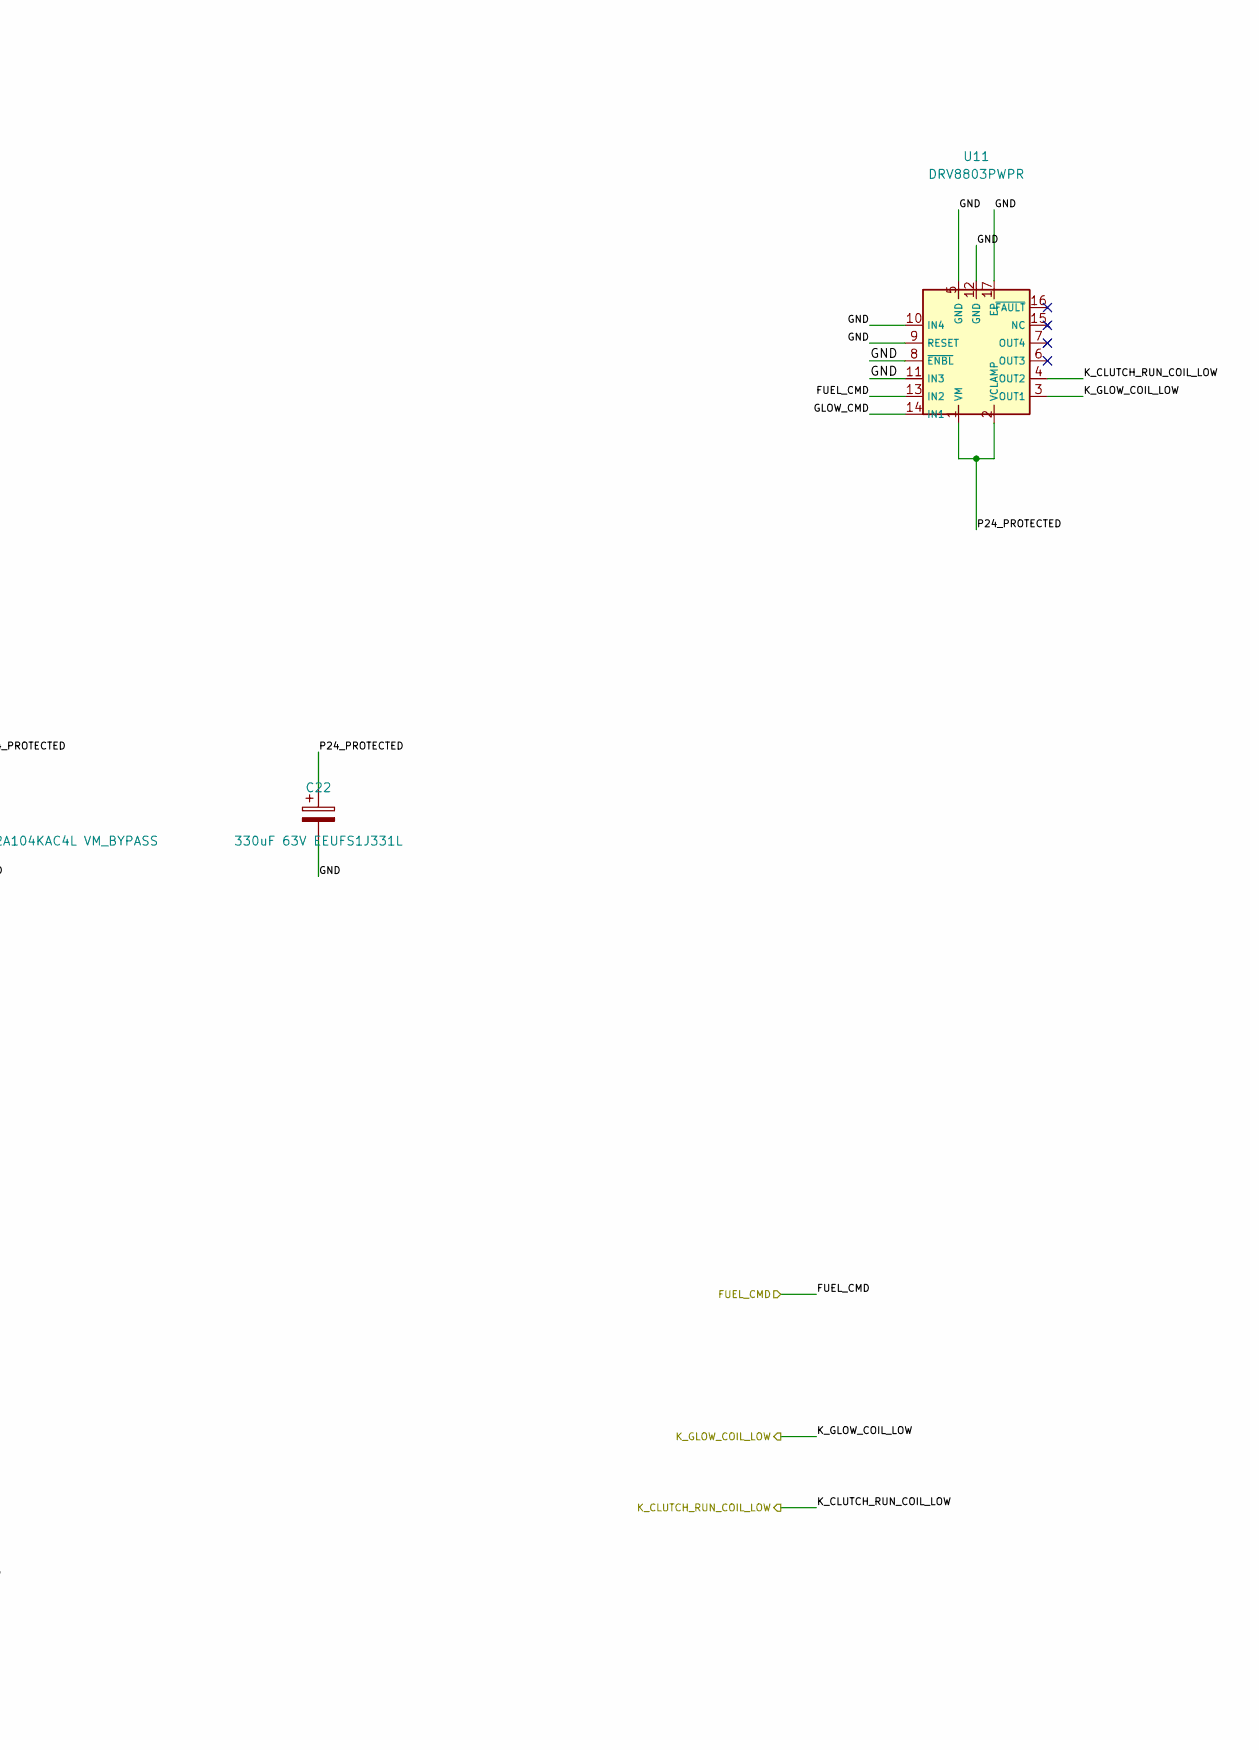
[picture p14: schematic RelayDriver.kicad_sch, part in row 1, column 2]

Parts:
C21: 100nF 100V X7R GRM21BR72A104KAC4L VM_BYPASS; C_0805_2012Metric; MPN GRM21BR72A104KAC4L
C22: 330uF 63V EEUFS1J331L; CP_Radial_D10.0mm_P5.00mm; MPN EEUFS1J331L
R86: 4k7 DRV_IN1_PULLDOWN; R_Axial_DIN0207_L6.3mm_D2.5mm_P10.16mm_Horizontal; MPN MFR-25FTE52-4K7
R87: 4k7 DRV_IN2_PULLDOWN; R_Axial_DIN0207_L6.3mm_D2.5mm_P10.16mm_Horizontal; MPN MFR-25FTE52-4K7
U11: DRV8803PWPR; HTSSOP-16-1EP_4.4x5mm_P0.65mm_EP3x3mm; MPN DRV8803PWPR

Connections:
/FUEL_CMD: R87.1, U11.13 (IN2); also elsewhere on the board
/GLOW_CMD: R86.1, U11.14 (IN1); also elsewhere on the board
/GND: C21.2, C22.2, R86.2, R87.2, U11.5 (GND), U11.8 (~ENBL), U11.9 (RESET), U11.10 (IN4), U11.11 (IN3), U11.12 (GND), U11.17 (EP); also elsewhere on the board
/K_CLUTCH_RUN_COIL_LOW: U11.4 (OUT2); also elsewhere on the board
/K_GLOW_COIL_LOW: U11.3 (OUT1); also elsewhere on the board
/P24_PROTECTED: C21.1, C22.1, U11.1 (VM), U11.2 (VCLAMP); also elsewhere on the board

Notes on the sheet:
K1: glow plug. K2: fuel-pump clutch. Both use normally-open contacts.
ESP32 controls startup, purge, operating timing and faults. Motor power is external.
24 V RELAY OUTPUTS — DRV8803
IN1=GLOW_CMD; IN2=FUEL_CMD. R86/R87 keep commands LOW. Unused IN3/IN4 and nENBL/RESET=GND; OUT3/OUT4 not connected. No independent welded-contact cutoff.
Commands are active HIGH; relay coils are switched on the low side.
Firmware: internal ESP32-S3 IWDT/TWDT, supervised control task, outputs OFF after reset, no automatic restart.
SIROKKO — RELAY DRIVER

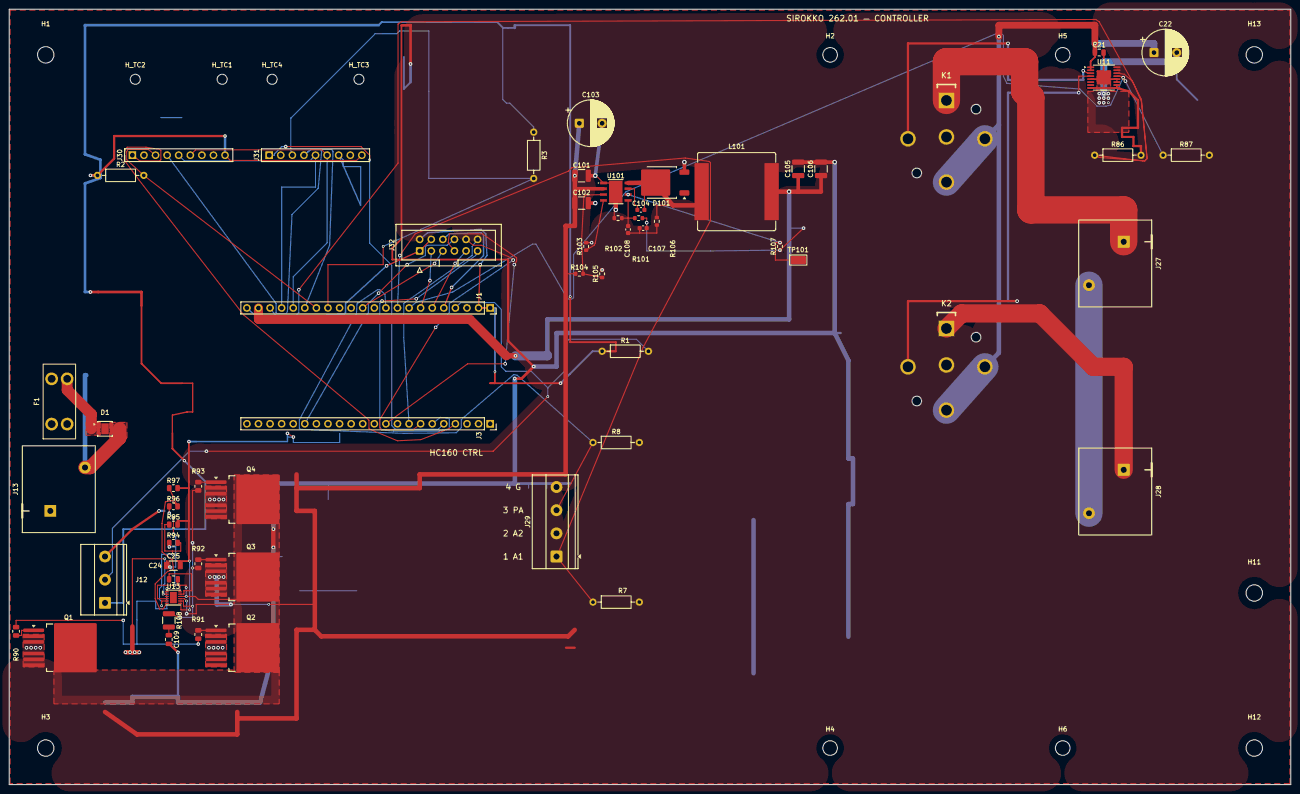
[picture p15: board Sirokko.kicad_pcb from above]

Board: 2 copper layers, 281.0 x 170.0 mm, 73 parts (0 on the bottom side), 49 nets.

Other parts of the board:
H1, H3, H11, H12, H13: MountingHole_3.6mm_R5.5
H2, H4: M3; MountingHole_3.2mm_M3
H5, H6: M3 SUPPORT; MountingHole_3.2mm_M3
H_TC1, H_TC2, H_TC3, H_TC4: MountingHole_2.2mm_M2
