krolbot/sirokko-26201-controller/docs/reviews/c25_native_v8_wip/project/tft_power_tps62162_standalone_DRAFT/tft_power_tps62162_review_DRAFT.kicad_sch

## KiCad design docs/reviews/c25_native_v8_wip/project/tft_power_tps62162_standalone_DRAFT/tft_power_tps62162_review_DRAFT.kicad_sch (2026-10-27)

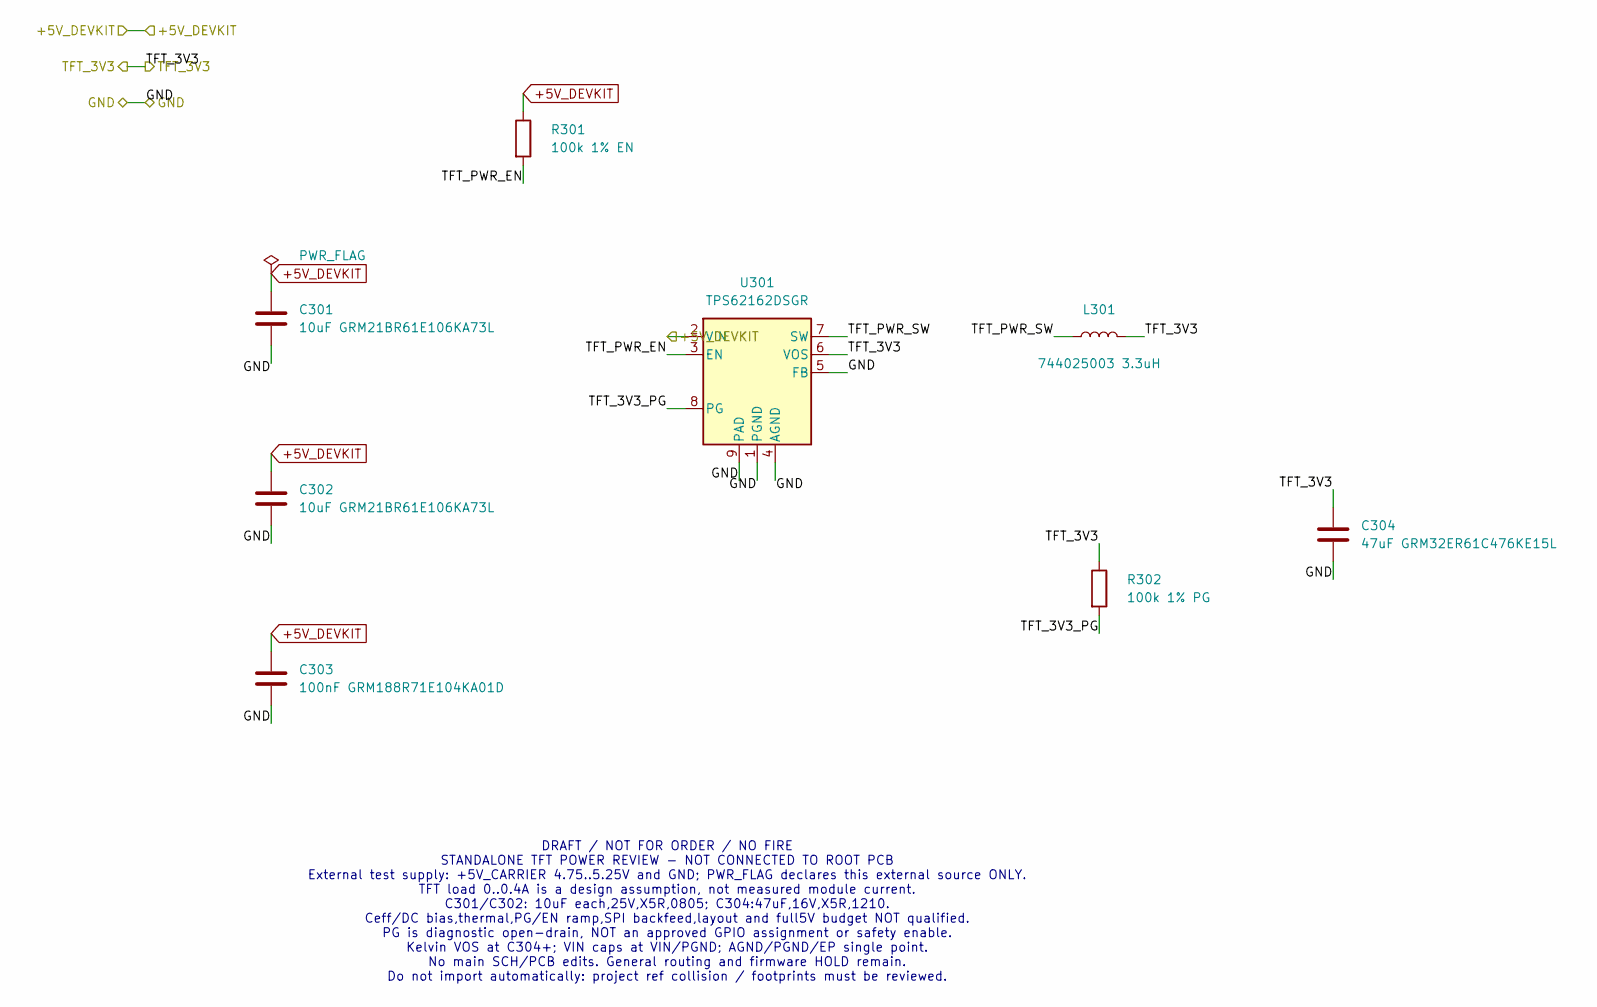
[picture p16: schematic tft_power_tps62162_review_DRAFT.kicad_sch]

Parts:
C301, C302: 10uF GRM21BR61E106KA73L; C_Murata_GRM21B_2012_Reflow; MPN GRM21BR61E106KA73L
C303: 100nF GRM188R71E104KA01D; C_Murata_GRM188_1608_Reflow; MPN GRM188R71E104KA01D
C304: 47uF GRM32ER61C476KE15L; C_Murata_GRM32E_3225_Reflow; MPN GRM32ER61C476KE15L
L301: 744025003 3.3uH; L_Wuerth_744025003_2828_Reflow; MPN 744025003
R301: 100k 1% EN; R_Yageo_RC0603_1608_Reflow; MPN RC0603FR-07100KL
R302: 100k 1% PG; R_Yageo_RC0603_1608_Reflow; MPN RC0603FR-07100KL
U301: TPS62162DSGR; Texas_DSG0008A_WSON-8-1EP_2x2mm_P0.5mm_EP0.9x1.6mm; MPN TPS62162DSGR

Connections:
+5V_DEVKIT: C301.1, C302.1, C303.1, R301.1, U301.2 (VIN)
GND: C301.2, C302.2, C303.2, C304.2, U301.1 (PGND), U301.4 (AGND), U301.5 (FB), U301.9 (PAD)
TFT_3V3: C304.1, L301.2, R302.1, U301.6 (VOS)
TFT_3V3_PG: R302.2, U301.8 (PG)
TFT_PWR_EN: R301.2, U301.3 (EN)
TFT_PWR_SW: L301.1, U301.7 (SW)

Notes on the sheet:
DRAFT / NOT FOR ORDER / NO FIRE STANDALONE TFT POWER REVIEW - NOT CONNECTED TO ROOT PCB External test supply: +5V_CARRIER 4.75..5.25V and GND; PWR_FLAG declares this external source ONLY. TFT load 0..0.4A is a design assumption, not measured module current. C301/C302: 10uF each,25V,X5R,0805; C304:4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
