krolbot/sirokko-26201-controller/docs/reviews/c25_native_v8_wip/project/tft_reset_local_DRAFT/sirokko_tft_reset_local_DRAFT.kicad_sch

## KiCad design docs/reviews/c25_native_v8_wip/project/tft_reset_local_DRAFT/sirokko_tft_reset_local_DRAFT.kicad_sch (2026-10-28)

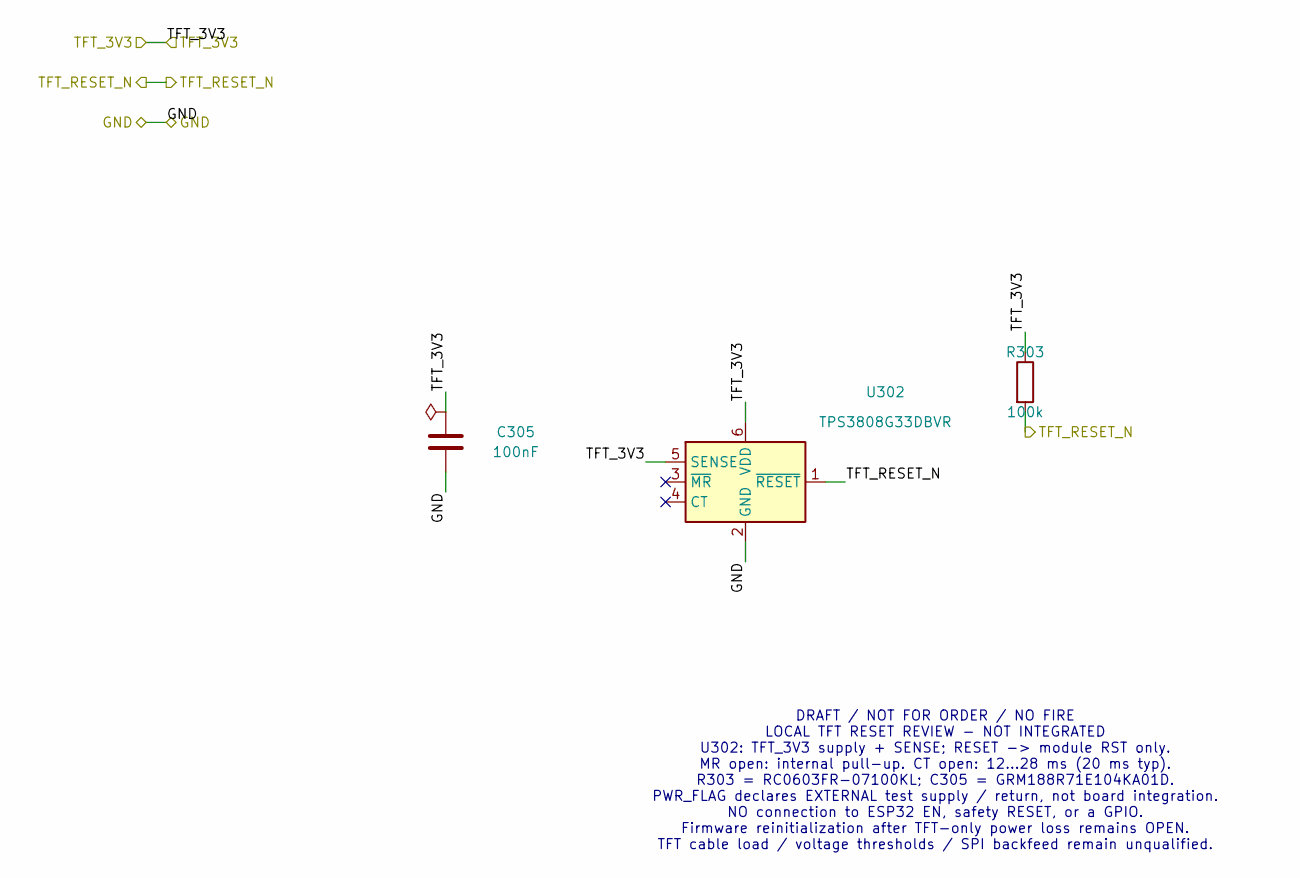
[picture p17: schematic sirokko_tft_reset_local_DRAFT.kicad_sch]

Parts:
C305: 100nF; C_Murata_GRM188_1608_Reflow; MPN GRM188R71C104KA01D
R303: 100k; R_0603_1608Metric; MPN RC0603FR-07100KL
U302: TPS3808G33DBVR; SOT-23-6; MPN TPS3808G33DBVR

Connections:
GND: C305.2, U302.2 (GND)
TFT_3V3: C305.1, R303.1, U302.5 (SENSE), U302.6 (VDD)
TFT_RESET_N: R303.2, U302.1 (~RESET)

Notes on the sheet:
DRAFT / NOT FOR ORDER / NO FIRE LOCAL TFT RESET REVIEW - NOT INTEGRATED U302: TFT_3V3 supply + SENSE; RESET -> module RST only. MR open: internal pull-up. CT open: 12...28 ms (20 ms typ). R303 = RC0603FR-07100KL; C305 = GRM188R71E104KA01D. PWR_FLAG declares EXTERNAL test supply / return, not board 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
