krolbot/sirokko-26201-controller/docs/reviews/c25_native_v8_wip/project/tft_spi_isolation_DRAFT/sirokko_tft_spi_isolation_DRAFT.kicad_sch

## KiCad design docs/reviews/c25_native_v8_wip/project/tft_spi_isolation_DRAFT/sirokko_tft_spi_isolation_DRAFT.kicad_sch (2026-10-28)

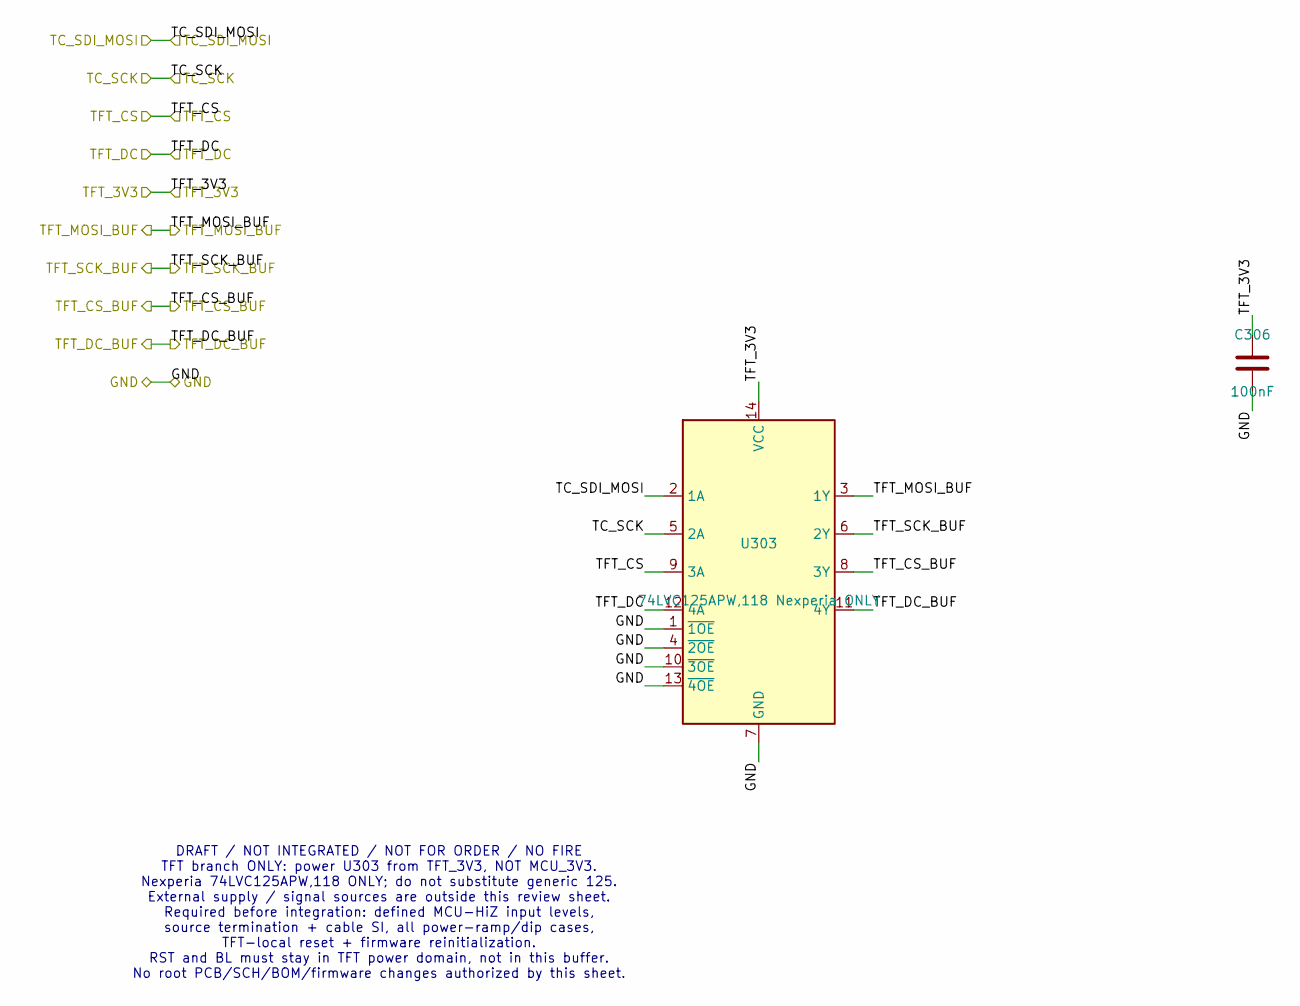
[picture p18: schematic sirokko_tft_spi_isolation_DRAFT.kicad_sch]

Parts:
C306: 100nF; C_Murata_GRM188_1608_Reflow; MPN GRM188R71C104KA01D
U303: 74LVC125APW,118 Nexperia ONLY; TSSOP-14_4.4x5mm_P0.65mm; MPN 74LVC125APW,118

Connections:
GND: C306.2, U303.1 (~1OE), U303.4 (~2OE), U303.7 (GND), U303.10 (~3OE), U303.13 (~4OE)
TC_SCK: U303.5 (2A)
TC_SDI_MOSI: U303.2 (1A)
TFT_3V3: C306.1, U303.14 (VCC)
TFT_CS: U303.9 (3A)
TFT_CS_BUF: U303.8 (3Y)
TFT_DC: U303.12 (4A)
TFT_DC_BUF: U303.11 (4Y)
TFT_MOSI_BUF: U303.3 (1Y)
TFT_SCK_BUF: U303.6 (2Y)

Notes on the sheet:
DRAFT / NOT INTEGRATED / NOT FOR ORDER / NO FIRE TFT branch ONLY: power U303 from TFT_3V3, NOT MCU_3V3. Nexperia 74LVC125APW,118 ONLY; do not substitute generic 125. External supply / signal sources are outside this review sheet. Required before integration: defined MCU-HiZ input levels, source ter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
