krolbot/sirokko-26201-controller/firmware/main/network_config.hpp

#pragma once
namespace network_config {
inline constexpr char address[] = "192.168.26.1";
inline constexpr char url[] = "http://192.168.26.1/";
inline constexpr unsigned clients = 4;
} // namespace network_config
