krolbot/sirokko-26201-controller/firmware/tests/control_test.cpp

#include "control_fixture.hpp"
#include <cassert>
#include <iostream>
#include <limits>
using namespace sirokko;
using namespace control_fixture;
namespace {
TickInput trial_input(uint64_t now, bool held = false, int32_t exhaust = 20000) {
    auto i = input(now, exhaust, 20000);
    i.sensors.room = {}; // Trial uses a manual motor command, not room regulation.
    i.local_button_held = held;
    i.local_button_valid = true;
    i.local_button_sample_ms = now;
    return i;
}
Controller trial_ignition(SafetyEnvelope profile = {}) {
    Settings settings{};
    settings.duration_ms = 1; // Normal timer must not affect a trial.
    Controller c(profile, settings, 21, Startup::CLEAN);
    auto i = trial_input(100);
    i.trial_request = true;
    auto s = c.tick(i);
    assert(s.state == State::TRIAL_READY && s.trial_active && !s.run_id);
    assert(s.trial_remaining_ms == kTrialArmMs);
    off(s);
    assert(!s.outputs.fan_request);
    assert(!c.update_settings(Settings{}));
    s = c.tick(trial_input(120, true));
    assert(s.state == State::PREHEAT && s.run_id && s.outputs.glow);
    assert(!s.outputs.fuel && !s.outputs.fan_request && !s.duration_active);
    s = c.tick(trial_input(kIgnitionAt - 1, false));
    assert(s.state == State::PREHEAT && s.outputs.glow && !s.outputs.fuel);
    s = c.tick(trial_input(kIgnitionAt, false));
    assert(s.state == State::IGNITION && s.outputs.glow && s.outputs.fan_request);
    assert(s.outputs.speed_code == kPwmMaximum && s.outputs.fuel);
    return c;
}
void test_trials() {
    {
        auto c = trial_ignition();
        const auto before = envelope_fingerprint(c.safety_envelope());
        auto future_snapshot = c.snapshot(kIgnitionAt + kIgnitionGlowMs + 1);
        assert(future_snapshot.outputs.glow); // A read cannot change the applied output command.
        Snapshot s{};
        for (uint64_t elapsed = 100; elapsed <= kFiringStartupMaximumMs; elapsed += 100) {
            auto i = trial_input(kIgnitionAt + elapsed, true, 100000);
            i.set_shutdown_timer = true;
            i.shutdown_after_ms = 1;
            i.trial_request = true; // Repeated requests cannot extend the window.
            s = c.tick(i);
            assert(s.state != State::RUN && !s.duration_active && !s.faults);
            assert(!c.update_settings(Settings{}));
            if (elapsed < kFiringStartupMaximumMs) {
                assert(s.state == State::IGNITION);
                assert(s.outputs.glow == (elapsed < kIgnitionGlowMs));
                assert(s.outputs.fuel);
                assert(s.trial_remaining_ms == kFiringStartupMaximumMs - elapsed);
            } else {
                assert(s.state == State::STOP_PURGE && s.trial_active);
                off(s);
            }
        }
        const auto stopped = kIgnitionAt + kFiringStartupMaximumMs;
        assert(s.outputs.fan_request && s.outputs.speed_code == kPwmMaximum);
        assert(c.tick(trial_input(stopped + kPostpurgeMinimumMs - 1, false)).state == State::STOP_PURGE);
        assert(c.tick(trial_input(stopped + kPostpurgeMinimumMs, false, 40000)).state == State::STOP_PURGE);
        s = c.tick(trial_input(stopped + kPostpurgeMinimumMs + 20, false, 39999));
        assert(s.state == State::UNCONFIGURED && !s.trial_active);
        assert(!s.outputs.fan_request && !s.outputs.fuel && !s.outputs.glow);
        assert(!s.envelope_provisioned && envelope_fingerprint(c.safety_envelope()) == before);
        s = c.tick(trial_input(stopped + kPostpurgeMinimumMs + 40, true));
        assert(s.state == State::UNCONFIGURED && !s.outputs.glow);
    }
    for (unsigned scenario = 0; scenario < 7; ++scenario) {
        Controller c({}, Settings{}, 1, Startup::CLEAN);
        auto i = trial_input(100);
        i.trial_request = true;
        switch (scenario) {
        case 0:
            i.local_button_held = true;
            break;
        case 1:
            i.local_button_valid = false;
            break;
        case 2:
            i.local_button_sample_ms = 101;
            break;
        case 3:
            i.cycle_record_ready = false;
            break;
        case 4:
            i.sensors.air.valid = false;
            break;
        case 5:
            i.sensors.exhaust.milli_c = 40000;
            break;
        case 6:
            i.stop = true;
            break;
        }
        const auto s = c.tick(i);
        assert(s.state != State::TRIAL_READY && !s.trial_active);
        off(s);
        assert(!s.outputs.fan_request);
    }
    Controller pending({}, Settings{}, 1, Startup::CLEAN);
    auto i = trial_input(100);
    i.trial_request = true;
    pending.tick(i);
    auto expired = pending;
    auto s = expired.tick(trial_input(100 + kTrialArmMs, true));
    assert(s.state == State::UNCONFIGURED && !s.trial_active && !s.outputs.glow);
    i = trial_input(120, true);
    i.local_button_valid = false; // Press debounce: wait without energizing anything.
    s = pending.tick(i);
    assert(s.state == State::TRIAL_READY && !s.faults && !s.outputs.glow);
    s = pending.tick(trial_input(140, true));
    assert(s.state == State::PREHEAT && s.outputs.glow);
    i = trial_input(160, false);
    i.local_button_valid = false; // Releasing the start button must keep preheat running.
    s = pending.tick(i);
    assert(s.state == State::PREHEAT && s.outputs.glow && !s.faults);
    i = trial_input(180, false);
    i.stop = true;
    s = pending.tick(i);
    assert(s.state == State::STOP_PURGE && !s.faults);
    off(s);
    for (unsigned scenario = 0; scenario < 5; ++scenario) {
        auto c = trial_ignition();
        i = trial_input(kIgnitionAt + 200, true);
        switch (scenario) {
        case 0:
            i.local_button_sample_ms = i.now_ms - kLocalButtonFreshMs - 1;
            break;
        case 1:
            i.local_button_sample_ms = i.now_ms + 1;
            break;
        case 2:
            i.sensors.air.valid = false;
            break;
        case 3:
            i.sensors.exhaust.valid = false;
            break;
        case 4:
            i.external_faults = FAULT_CONTROL_WATCHDOG;
            break;
        }
        s = c.tick(i);
        assert(s.state == State::FAULT_PURGE && s.faults && s.outputs.fan_request);
        off(s);
        s = c.tick(trial_input(i.now_ms + kPostpurgeMinimumMs));
        assert(s.state == State::FAULT && !s.trial_active);
        i = trial_input(i.now_ms + kPostpurgeMinimumMs + 20);
        i.reset_fault = true;
        s = c.tick(i);
        assert(s.state == State::UNCONFIGURED && !s.faults); // No room sensor required for trial reset.
    }
    auto c = trial_ignition();
    i = trial_input(kIgnitionAt + 100, true);
    i.local_button_sample_ms = kIgnitionAt;
    assert(c.tick(i).outputs.fuel); // Exactly 100 ms is still fresh.
    s = c.tick(trial_input(kIgnitionAt + 120, false));
    assert(s.state == State::IGNITION && s.outputs.fuel && s.outputs.glow && !s.faults);
    i = trial_input(kIgnitionAt + 140, false);
    i.stop = true;
    s = c.tick(i);
    assert(s.state == State::STOP_PURGE && !s.faults);
    off(s);
    auto partial = SafetyEnvelope{};
    partial.purge_speed_code = 1;
    Controller recovered(partial, Settings{}, 21, Startup::RECOVER);
    s = recovered.tick(trial_input(100));
    assert(s.state == State::RECOVERY_PURGE && s.outputs.speed_code == kPwmMaximum);
    off(s);
    assert(recovered.tick(trial_input(kPostpurgeMinimumMs - 1)).state == State::RECOVERY_PURGE);
    s = recovered.tick(trial_input(kPostpurgeMinimumMs));
    assert(s.state == State::UNCONFIGURED && !s.outputs.fan_request);
    Controller mixed(envelope(), Settings{}, 21, Startup::CLEAN);
    i = trial_input(100);
    i.start = true;
    i.trial_request = true;
    s = mixed.tick(i);
    assert(s.state == State::TRIAL_READY && s.trial_active);
    off(s);
    auto known_limit = SafetyEnvelope{};
    known_limit.maximum_exhaust_milli_c = 50000;
    c = trial_ignition(known_limit);
    s = c.tick(trial_input(kIgnitionAt + 20, true, 50000));
    assert(s.state == State::FAULT_PURGE && (s.faults & FAULT_OVER_TEMPERATURE));
    off(s);
}
void test_trial_measurements() {
    auto c = trial_ignition();
    const auto profile_before = envelope_fingerprint(c.safety_envelope());
    auto i = trial_input(kIgnitionAt + kIgnitionGlowMs - 1, true, 100000);
    i.trial_confirm = i.set_trial_pwm = true;
    i.trial_pwm_code = 1;
    auto s = c.tick(i);
    assert(s.state == State::IGNITION && s.outputs.glow && s.outputs.speed_code == kPwmMaximum);
    i = trial_input(kIgnitionAt + kIgnitionGlowMs, true, 100000);
    i.trial_confirm = i.set_trial_pwm = true;
    i.trial_pwm_code = 1;
    s = c.tick(i);
    assert(s.state == State::RUN && s.trial_active && s.outputs.fuel && !s.outputs.glow);
    assert(s.outputs.speed_code == kPwmMaximum); // Confirmation always enters at the starting command.
    assert(s.trial_elapsed_ms == 0 && s.trial_remaining_ms == kTrialMeasurementMs);
    const uint64_t confirmed_at = i.now_ms;
    const auto run = c;
    i = trial_input(confirmed_at + 20, false, 100000);
    i.set_trial_pwm = true;
    i.trial_pwm_code = 2007;
    s = c.tick(i);
    assert(s.state == State::RUN && s.outputs.speed_code == 2007 && s.outputs.fuel && !s.outputs.glow);
    assert(s.trial_elapsed_ms == 20 && s.trial_remaining_ms == kTrialMeasurementMs - 20);
    const auto &event = c.events()[c.event_count() - 1];
    assert(std::string(event.kind) == "TRIAL_PWM_CHANGED" && event.speed_code == 2007);
    auto version = s.state_version;
    for (const auto code : {0U, static_cast<unsigned>(kPwmMaximum) + 1U}) {
        i.now_ms += 20;
        i = trial_input(i.now_ms, true, 100000);
        i.set_trial_pwm = true;
        i.trial_pwm_code = code;
        s = c.tick(i);
        assert(s.outputs.speed_code == 2007 && s.state_version == version);
    }
    i = trial_input(confirmed_at + 100, true, 100000);
    i.set_trial_pwm = true;
    i.trial_pwm_code = 1;
    s = c.tick(i);
    assert(s.outputs.speed_code == 1 && s.outputs.fuel && s.state_version > version);
    i = trial_input(confirmed_at + kTrialMeasurementMs - 1, true, 100000);
    i.trial_request = i.trial_confirm = i.set_trial_pwm = i.set_shutdown_timer = true;
    i.trial_pwm_code = kPwmMaximum;
    i.shutdown_after_ms = kMaximumTimerMs;
    s = c.tick(i);
    assert(s.state == State::RUN && s.trial_remaining_ms == 1 && !s.duration_active);
    i = trial_input(confirmed_at + kTrialMeasurementMs, true, 100000);
    i.trial_confirm = i.set_trial_pwm = true;
    i.trial_pwm_code = 1;
    s = c.tick(i);
    assert(s.state == State::STOP_PURGE && s.outputs.speed_code == kPwmMaximum);
    off(s);
    assert(!s.envelope_provisioned && envelope_fingerprint(c.safety_envelope()) == profile_before);
    i = trial_input(confirmed_at + kTrialMeasurementMs + 20, true, 100000);
    i.set_trial_pwm = i.trial_confirm = true;
    i.trial_pwm_code = 1;
    s = c.tick(i);
    assert(s.state == State::STOP_PURGE && s.outputs.speed_code == kPwmMaximum);
    off(s);

    auto late = trial_ignition();
    i = trial_input(kIgnitionAt + kFiringStartupMaximumMs, true, 100000);
    i.trial_confirm = true;
    s = late.tick(i);
    assert(s.state == State::STOP_PURGE);
    off(s); // Confirmation cannot revive an expired ignition window.

    for (unsigned scenario = 0; scenario < 5; ++scenario) {
        auto interrupted = run;
        i = trial_input(confirmed_at + 20, true, 100000);
        i.trial_confirm = i.set_trial_pwm = true;
        i.trial_pwm_code = 1;
        switch (scenario) {
        case 0:
            i.stop = true;
            break;
        case 1:
            i.local_button_held = false;
            i.stop = true;
            break;
        case 2:
            i.sensors.exhaust.valid = false;
            break;
        case 3:
            i.local_button_sample_ms = i.now_ms - kLocalButtonFreshMs - 1;
            break;
        case 4:
            i.external_faults = FAULT_CONTROL_WATCHDOG;
            break;
        }
        s = interrupted.tick(i);
        assert(s.state == (scenario < 2 ? State::STOP_PURGE : State::FAULT_PURGE));
        assert(s.outputs.speed_code == kPwmMaximum && s.outputs.fan_request);
        off(s);
    }
    auto known_profile = envelope();
    known_profile.minimum_run_exhaust_milli_c = 150000;
    auto known = trial_ignition(known_profile);
    i = trial_input(confirmed_at, true, 100000);
    i.trial_confirm = true;
    assert(known.tick(i).state == State::RUN);
    s = known.tick(trial_input(confirmed_at + kTemperatureConfirmationMs + 20, true, 100000));
    assert(s.state == State::RUN && !s.faults); // Measurement does not assume the configured flame floor.
    s = known.tick(trial_input(confirmed_at + kTemperatureConfirmationMs + 40, true,
                               known_profile.maximum_exhaust_milli_c));
    assert(s.state == State::FAULT_PURGE && (s.faults & FAULT_OVER_TEMPERATURE));
    off(s);
}
void test_optional_exhaust_cutoff() {
    auto profile = envelope();
    profile.maximum_exhaust_milli_c = 0;
    assert(valid_safety_envelope(profile));
    Controller c(profile, Settings{}, 1, Startup::CLEAN);
    auto i = input(120);
    i.start = true;
    auto s = c.tick(i);
    assert(s.state == State::PREHEAT && s.outputs.glow);
    s = c.tick(input(kIgnitionAt));
    assert(s.state == State::IGNITION && s.outputs.fuel);
    s = confirm_ignition(c, kProcessMeasurementCeilingMilliC - 1);
    assert(s.state == State::RUN && s.outputs.fuel && !s.faults);
    s = c.tick(input(kRunAt + 20, kProcessMeasurementCeilingMilliC));
    assert(s.state == State::FAULT_PURGE && (s.faults & FAULT_EXHAUST));
    off(s); // The probe range still applies when no additional exhaust cutoff is configured.
}
void test_exhaust_delay() {
    auto p = envelope();
    p.exhaust_low_delay_ms = 5000;
    Controller c(p, Settings{}, 1, Startup::CLEAN);
    auto i = input(120); i.start = true; c.tick(i);
    c.tick(input(kIgnitionAt));
    auto s = confirm_ignition(c, 50000);
    assert(s.state == State::RUN); // Ignition still uses its original confirmation.
    for (uint64_t t = kRunAt + 100; t <= kRunAt + 3000; t += 100) {
        s = c.tick(input(t, 39000)); assert(s.outputs.fuel);
    }
    s = c.tick(input(kRunAt + 3100, 40000)); assert(s.outputs.fuel);
    for (uint64_t t = kRunAt + 3200; t < kRunAt + 8200; t += 100) {
        s = c.tick(input(t, 39000)); assert(s.outputs.fuel);
    }
    s = c.tick(input(kRunAt + 8200, 39000));
    assert(!s.outputs.fuel && (s.faults & FAULT_FLAME_LOST));
    for (auto delay : {0ULL, 999ULL, 30001ULL}) { p.exhaust_low_delay_ms = delay; assert(!valid_profile_draft(p)); }
}

} // namespace

int main() {
    test_exhaust_delay();
    test_trials();
    test_trial_measurements();
    test_optional_exhaust_cutoff();
    Controller disconnected({}, Settings{}, 7, Startup::CLEAN);
    auto detached = disconnected.snapshot(0);
    assert(detached.state == State::UNCONFIGURED && !detached.purge_active && !detached.outputs.fan_request);
    auto request = input(100);
    request.start = request.set_shutdown_timer = true;
    request.shutdown_after_ms = 10000;
    detached = disconnected.tick(request);
    assert(detached.state == State::UNCONFIGURED && !detached.faults && !detached.duration_active);
    assert(!detached.outputs.fuel && !detached.outputs.glow);
    Settings preview{};
    preview.room_setpoint_milli_c = 23000;
    assert(disconnected.update_settings(preview));
    request = {};
    request.now_ms = 200;
    request.enter_maintenance = true;
    assert(disconnected.tick(request).state == State::MAINTENANCE);
    request.stop = true;
    assert(disconnected.tick(request).state == State::UNCONFIGURED);

    assert(SafetyEnvelope{}.preheat_ms == 30000 && SafetyEnvelope{}.postpurge_ms == 150000);
    auto limits = envelope();
    limits.preheat_ms = 29999;
    assert(!valid_safety_envelope(limits));
    limits = envelope();
    limits.preheat_ms = 60001;
    assert(!valid_safety_envelope(limits));
    limits = envelope();
    limits.preheat_ms = 60000;
    assert(valid_safety_envelope(limits));
    limits = envelope();
    limits.postpurge_ms = 149999;
    assert(!valid_safety_envelope(limits));
    limits = envelope();
    limits.ignition_timeout_ms = 90000;
    assert(valid_safety_envelope(limits));
    ++limits.ignition_timeout_ms;
    assert(!valid_safety_envelope(limits));
    limits = envelope();
    limits.ignition_timeout_ms = kIgnitionGlowMs + kTemperatureConfirmationMs;
    assert(!valid_safety_envelope(limits));
    assert(valid_profile_draft(limits)); // Keep saved values editable after an update.
    Controller short_timeout(limits, Settings{}, 1, Startup::CLEAN);
    assert(short_timeout.tick(input(100)).state == State::UNCONFIGURED);
    ++limits.ignition_timeout_ms;
    assert(valid_safety_envelope(limits));
    Controller empty({}, Settings{}, 1, Startup::CLEAN);
    auto s = empty.tick(input(100));
    off(s);
    assert(s.start_block == Block::ENVELOPE_MISSING && !s.outputs.fan_request && !s.purge_active);
    Controller missing(envelope(), Settings{}, 1, Startup::CLEAN);
    s = missing.tick(input(100));
    assert(s.start_block == Block::NONE);
    auto i = input(120);
    i.start = true;
    s = missing.tick(i);
    assert(s.state == State::PREHEAT && s.outputs.glow && !s.outputs.fuel);
    Controller cold(envelope(), Settings{}, 1, Startup::CLEAN);
    s = cold.tick(input(100, -20000, -20000));
    assert(s.state == State::IDLE && s.start_block == Block::NONE);
    i = input(120, -20000, -20000);
    i.start = true;
    s = cold.tick(i);
    assert(s.state == State::PREHEAT);
    i = input(140, kThermocoupleMinimumMilliC - 1, 20000);
    s = cold.tick(i);
    off(s);
    assert(s.faults & FAULT_EXHAUST);
    Controller idle(envelope(), Settings{}, 1, Startup::CLEAN);
    idle.tick(input(100));
    CommandGate queued;
    const auto version = idle.snapshot(100).state_version;
    const auto pending = queued.issue(Action::START, 0, 100, version, 99);
    i = input(120);
    i.stop = true;
    s = idle.tick(i);
    assert(s.state == State::IDLE && s.state_version != version);
    assert(!queued.consume(pending, 140, s.state_version));
    const auto current = queued.issue(Action::START, 0, 140, s.state_version, 100);
    queued.issue(Action::SETTINGS, 0, 140, version, 101);
    assert(queued.consume(current, 150, s.state_version));
    const auto c = ignition();
    for (unsigned scenario = 0; scenario < 8; ++scenario) {
        auto copy = c;
        i = input(kIgnitionAt + 20);
        switch (scenario) {
        case 0:
            i.stop = true;
            i.start = true;
            break;
        case 1:
            i.sensors.exhaust.milli_c = 300000;
            break;
        case 2:
            i.sensors.air.milli_c = kProcessMeasurementCeilingMilliC;
            break;
        case 3:
            i.now_ms = kIgnitionAt + 680;
            i.sensors.exhaust.sample_ms = kIgnitionAt - 20;
            break;
        case 4:
            i.external_faults = FAULT_LOCAL_CONTROLS;
            break;
        case 5:
            i.sensors.exhaust.status = 1;
            break;
        case 6:
            i.now_ms = 300;
            break;
        case 7:
            i.sensors.air.sample_ms = kIgnitionAt + 21;
            break;
        }
        s = copy.tick(i);
        off(s);
        assert(s.state == State::STOP_PURGE || s.state == State::FAULT_PURGE);
        assert(s.outputs.fan_request);
    }
    // Glow duration is independent of exhaust temperature; cold exhaust still has a deadline.
    for (int32_t exhaust : {20000, 50000}) {
        auto timed = c;
        for (uint64_t t = kIgnitionAt + 100; t < kIgnitionAt + kIgnitionGlowMs; t += 100) {
            s = timed.tick(input(t, exhaust));
            assert(s.state == State::IGNITION && s.outputs.glow && s.outputs.fuel);
        }
        s = timed.tick(input(kIgnitionAt + kIgnitionGlowMs, exhaust));
        assert(s.state == State::IGNITION && !s.outputs.glow && s.outputs.fuel && s.outputs.fan_request);
        if (exhaust == 20000) {
            s = timed.tick(input(kIgnitionAt + envelope().ignition_timeout_ms));
            off(s);
            assert(s.state == State::FAULT_PURGE && (s.faults & FAULT_IGNITION_TIMEOUT));
        }
    }
    // STOP and sensor failures override both sides of the glow-off boundary.
    for (uint64_t offset : {kIgnitionGlowMs - 1, kIgnitionGlowMs, kIgnitionGlowMs + 1}) {
        for (bool stop : {false, true}) {
            auto interrupted = c;
            i = input(kIgnitionAt + offset);
            if (stop)
                i.stop = true;
            else
                i.sensors.exhaust.valid = false;
            s = interrupted.tick(i);
            off(s);
            assert(s.outputs.fan_request);
            assert(s.state == (stop ? State::STOP_PURGE : State::FAULT_PURGE));
        }
    }
    // Heated-air temperature is telemetry, not an ignition-rise or overheat threshold.
    auto slow_air = c;
    s = confirm_ignition(slow_air, 50000, 20000);
    assert(s.state == State::RUN && s.outputs.fuel && !s.faults);
    s = slow_air.tick(input(kRunAt + 20, 50000, 200000));
    assert(s.state == State::RUN && s.outputs.fuel && !s.faults);
    auto invalid_air = input(kRunAt + 40, 50000, kProcessMeasurementCeilingMilliC);
    s = slow_air.tick(invalid_air);
    assert((s.faults & FAULT_AIR) && !(s.faults & FAULT_OVER_TEMPERATURE));
    off(s);
    auto failed = c;
    s = failed.tick(input(kIgnitionAt + envelope().ignition_timeout_ms));
    off(s);
    assert(s.faults & FAULT_IGNITION_TIMEOUT);
    // The same guard drives fault-reset admission and the transition.
    s = failed.tick(input(kIgnitionAt + envelope().ignition_timeout_ms + kPostpurgeMinimumMs));
    assert(s.state == State::FAULT && s.reset_fault_block == Block::NONE);
    auto reset = input(kIgnitionAt + envelope().ignition_timeout_ms + 20 + kPostpurgeMinimumMs);
    reset.reset_fault = true;
    reset.external_faults = FAULT_LOCAL_CONTROLS;
    s = failed.tick(reset);
    assert(s.faults && s.reset_fault_block != Block::NONE);
    reset = input(kIgnitionAt + 140 + 2 * kPostpurgeMinimumMs);
    s = failed.tick(reset);
    assert(s.state == State::FAULT);
    reset.now_ms += 20;
    reset.sensors.air.valid = false;
    reset.reset_fault = true;
    s = failed.tick(reset);
    assert(s.state == State::FAULT && s.reset_fault_block == Block::SENSOR_INVALID);
    reset = input(reset.now_ms + 20);
    reset.reset_fault = true;
    s = failed.tick(reset);
    assert(s.state == State::IDLE && !s.faults);
    auto running = c;
    s = confirm_ignition(running);
    assert(s.state == State::RUN && s.outputs.fuel && !s.outputs.glow);
    auto flame = running;
    for (uint64_t t = kRunAt + 20; t <= kRunAt + 1020; t += 100) {
        s = flame.tick(input(t, 30000, 30000));
        if (t < kRunAt + 1020)
            assert(s.state == State::RUN && !s.faults);
    }
    off(s);
    assert(s.faults & FAULT_FLAME_LOST);
    i = input(kRunAt + 20, 50000, 30000);
    i.set_shutdown_timer = true;
    i.shutdown_after_ms = 100;
    running.tick(i);
    i = input(kRunAt + 120, 50000, 30000);
    i.set_shutdown_timer = true;
    i.shutdown_after_ms = 1000;
    s = running.tick(i);
    off(s);
    assert(s.state == State::STOP_PURGE); // Expiry wins over extension.
    i = input(kRunAt + 180, 60000, 30000);
    s = running.tick(i);
    assert(s.state == State::STOP_PURGE);
    s = running.tick(input(kRunAt + 120 + kPostpurgeMinimumMs));
    assert(s.state == State::IDLE);
    const uint64_t kConfirmationAt = kIgnitionAt + kIgnitionGlowMs;
    // A spike, duplicated sample or interrupted sequence cannot finish ignition.
    auto noisy = ignition();
    assert(noisy.tick(input(kConfirmationAt + 100, 50000)).state == State::IGNITION);
    auto repeated = input(kConfirmationAt + 500, 50000);
    repeated.sensors.exhaust.sample_ms = kConfirmationAt + 100;
    assert(noisy.tick(repeated).state == State::IGNITION);
    assert(noisy.tick(input(kConfirmationAt + 600, 20000)).state == State::IGNITION);
    for (uint64_t t = kConfirmationAt + 700; t < kConfirmationAt + 1700; t += 100)
        assert(noisy.tick(input(t, 50000)).state == State::IGNITION);
    assert(noisy.tick(input(kConfirmationAt + 1700, 50000)).state == State::RUN);
    // One short fall after ignition must not extinguish the heater.
    assert(noisy.tick(input(kConfirmationAt + 1800, 20000)).state == State::RUN);
    assert(noisy.tick(input(kConfirmationAt + 1900, 50000)).state == State::RUN);
    assert(noisy.tick(input(kConfirmationAt + 2000, 50000)).faults == 0);
    // A gap restarts confirmation rather than bridging missing observations.
    auto gap = ignition();
    gap.tick(input(kConfirmationAt + 100, 50000));
    gap.tick(input(kConfirmationAt + 800, 50000));
    assert(gap.tick(input(kConfirmationAt + 1100, 50000)).state == State::IGNITION);
    // Expiry takes priority even if the last reading would complete confirmation.
    auto deadline = ignition();
    const auto expires = kIgnitionAt + envelope().ignition_timeout_ms;
    for (uint64_t t = expires - 1000; t < expires; t += 100)
        assert(deadline.tick(input(t, 50000)).state == State::IGNITION);
    auto expired_start = deadline.tick(input(expires, 50000));
    off(expired_start);
    assert(expired_start.faults & FAULT_IGNITION_TIMEOUT);
    // The probe's measurement range is not the configurable overheat threshold.
    auto range_fault = ignition();
    auto invalid_probe = range_fault.tick(input(kIgnitionAt + 20, kProcessMeasurementCeilingMilliC));
    assert((invalid_probe.faults & FAULT_EXHAUST) && !(invalid_probe.faults & FAULT_OVER_TEMPERATURE));
    off(invalid_probe);
    auto gate = CommandGate{};
    auto a = gate.issue(Action::START, 10, 0, 1, 100);
    auto b = gate.issue(Action::SETTINGS, 11, 0, 1, 101);
    assert(a.valid && b.valid && gate.consume(a, 1, 1) && gate.consume(b, 1, 1));
    assert(!gate.consume(a, 2, 1));
    a = gate.issue(Action::START, 10, 0, 1, 100);
    auto forged = a;
    forged.params_hash++;
    assert(!gate.consume(forged, 1, 1));
    assert(gate.consume(a, 1, 1));
    a = gate.issue(Action::START, 10, 0, 1, 100);
    assert(!gate.consume(a, kCommandFreshnessMs, 1));
    a = gate.issue(Action::START, 10, 0, 1, 100);
    assert(!gate.consume(a, 1, 2));
    a = gate.issue(Action::START, 10, 0, 1, 100);
    gate.invalidate();
    assert(!gate.consume(a, 1, 1));
    for (unsigned n = 1; n <= 16; ++n)
        assert(gate.issue(Action::START, 0, 0, 1, n).valid);
    assert(!gate.issue(Action::START, 0, 0, 1, 17).valid);
    assert(gate.issue(Action::START, 0, 5000, 1, 17).valid);
    assert(!gate.issue(Action::START, 0, std::numeric_limits<uint64_t>::max(), 1, 18).valid);
    std::cout << "PASS control: first start from profile, STOP, sensors, faults, purge, timer, grants\n";
}
