krolbot/sirokko-26201-controller/firmware/tests/combustion_test.cpp

#include "control_fixture.hpp"
#include "thermal_history.hpp"
#include <iostream>
using namespace sirokko;
using namespace control_fixture;

combustion::Monitor learned() {
    combustion::Monitor m;
    m.reset(40000, 2000);
    for (uint64_t t = 500; t <= 30000; t += 500) {
        const int noise = (t / 500) % 2 ? 1000 : -1000;
        m.observe(t, input(t, 200000 + noise, 80000 + noise / 2).sensors, 2000);
    }
    assert(m.snapshot().phase == combustion::Phase::WATCHING);
    return m;
}
void monitoring() {
    auto m = learned();
    auto s = m.observe(30500, input(30500, 140000, 78000).sensors, 2000);
    assert(s.phase == combustion::Phase::SUSPECT && s.exhaust_slope_milli_c_per_s < 0);
    assert(s.reference_exhaust_milli_c == 200000);
    // Reusing the same conversion is never another confirming observation.
    for (uint64_t now = 30520; now <= 31000; now += 20)
        assert(m.observe(now, input(30500, 140000, 78000).sensors, 2000).phase == combustion::Phase::SUSPECT);
    assert(m.observe(31000, input(31000, 200000, 80000).sensors, 2000).phase == combustion::Phase::WATCHING);
    for (uint64_t t = 31500; t <= 33000; t += 500)
        s = m.observe(t, input(t, 140000, 78000).sensors, 2000);
    assert(s.phase == combustion::Phase::LOST && s.suspect_ms == 1500);

    m = learned();
    for (uint64_t t = 30500; t <= 240000 && m.snapshot().phase != combustion::Phase::LOST; t += 500) {
        const int drop = static_cast<int>((t - 30000) / 500) * 250;
        m.observe(t, input(t, 200000 - drop, 80000).sensors, 2000);
    }
    assert(m.snapshot().phase == combustion::Phase::LOST); // No downward re-learning.
    m = learned();
    s = m.observe(30500, input(30500, 140000, 60000).sensors, 1700);
    assert(s.phase == combustion::Phase::LEARNING); // A commanded change has a different reference.
    for (uint64_t t = 31000; t < 70000; t += 500)
        m.observe(t, input(t, 140000, 60000).sensors, 1700);
    assert(m.snapshot().phase == combustion::Phase::WATCHING);
    assert(m.snapshot().reference_exhaust_milli_c == 140000);
    m = learned();
    auto invalid = input(30500).sensors;
    invalid.exhaust.valid = false;
    assert(m.observe(30500, invalid, 2000).phase == combustion::Phase::LEARNING);
    m = learned();
    assert(m.observe(100, input(100).sensors, 2000).phase == combustion::Phase::LEARNING);
    m = learned();
    m.observe(30500, input(30500, 140000, 80000).sensors, 2000);
    assert(m.observe(32500, input(32500, 140000, 80000).sensors, 2000).phase == combustion::Phase::LEARNING);

    m.reset(40000, 2000);
    for (uint64_t t = 500; t < 60000; t += 500)
        m.observe(t, input(t, 200000 - static_cast<int>(t), 80000).sensors, 2000);
    assert(m.snapshot().phase == combustion::Phase::LEARNING); // Warmup/cooldown is not a stable baseline.
    m.reset(40000, 2000);
    for (uint64_t t = 500; t < 60000; t += 500)
        m.observe(t, input(t, 200000 + ((t / 500) % 2 ? 20000 : -20000), 80000).sensors, 2000);
    assert(m.snapshot().phase == combustion::Phase::LEARNING); // Large noise cannot inflate the drop margin.

    auto c = ignition();
    confirm_ignition(c, 200000, 80000);
    auto settings = c.settings();
    settings.mode = Mode::MANUAL;
    settings.manual_percent = 100;
    assert(c.update_settings(settings));
    auto control = c.tick(input(kRunAt + 20, 200000, 80000));
    uint64_t now = kRunAt + 20;
    for (unsigned i = 0; i < 65; ++i) {
        now += 500;
        control = c.tick(input(now, 200000, 80000));
    }
    assert(control.combustion.phase == combustion::Phase::WATCHING);
    auto suspicious = c;
    auto check = suspicious.tick(input(now + 500, 140000, 80000));
    assert(check.combustion.phase == combustion::Phase::SUSPECT);
    assert(!suspicious.update_settings(settings));
    auto stop = input(now + 520, 140000, 80000);
    stop.stop = true;
    assert(suspicious.tick(stop).state == State::STOP_PURGE);
    assert(suspicious.update_settings(settings));
    auto absolute = c;
    auto immediate = absolute.tick(input(now + 20, 30000, 80000));
    assert(!immediate.faults);
    for (uint64_t t = now + 120; t <= now + 1020; t += 100)
        immediate = absolute.tick(input(t, 30000, 80000));
    assert(immediate.faults & FAULT_FLAME_LOST); // Confirmed floor works without a learned baseline.
    for (unsigned i = 0; i < 4; ++i) {
        now += 500;
        control = c.tick(input(now, 140000, 78000));
    }
    assert(control.faults & FAULT_COMBUSTION_DROP);
    assert(control.state == State::FAULT_PURGE && control.outputs.fan_request);
    off(control);
}

void history() {
    ThermalHistory history;
    Snapshot s{};
    s.boot_id = 7;
    for (uint64_t t = 0; t < 2 * kHistoryCapacity * kHistoryPeriodMs; t += kHistoryPeriodMs)
        history.record(t, input(t).sensors, s);
    HistorySnapshot copy{};
    history.copy(&copy);
    assert(copy.count == kHistoryCapacity && copy.boot_id == 7);
    assert(copy.points.front().at_ms == kHistoryCapacity * kHistoryPeriodMs);
    for (size_t n = 1; n < copy.count; ++n)
        assert(copy.points[n].at_ms > copy.points[n - 1].at_ms);
    const uint64_t now = copy.points.back().at_ms + 20;
    auto sensors = input(now).sensors;
    sensors.air.valid = false;
    s.faults = FAULT_AIR;
    s.state = State::FAULT_PURGE;
    history.record(now, sensors, s);
    history.copy(&copy);
    assert(copy.points.back().at_ms == now && !(copy.points.back().valid & 2));
    char encoded[256]{};
    JsonBuilder json(encoded, sizeof(encoded));
    append_history_point(&json, copy.points.back());
    assert(json.ok());
    s.boot_id++;
    history.record(0, input(0).sensors, s);
    history.copy(&copy);
    assert(copy.count == 1 && copy.boot_id == 8);
}
int main() {
    monitoring();
    history();
    std::cout << "PASS combustion/history: noisy reference, spike, sustained/slow drop, transitions, "
                 "stale/repeated data, real cutoff, no automatic "
                 "restart, ring wrap/reboot\n";
}
