krolbot/sirokko-26201-controller/(commit log)

2026-10-24 docs: publish Sirokko 262.01 DRAFT-01
    [Sirokko26201_control.kicad_sch]
2026-10-24 hardware: publish DRAFT-02 PCB WIP
    [Sirokko26201_control.kicad_pcb, Sirokko26201_control.kicad_sch]
2026-10-24 feat: add fail-safe ESP32-S3 firmware draft
    [partitions.csv]
2026-10-24 fix: align reset latch and watchdog timing
    [app_main.cpp, control.cpp, control.hpp]
2026-10-24 fix: require safety qualification before reset release
    [control.cpp, control.hpp]
2026-10-24 hardware: snapshot input protection candidate
    [input_protection_CANDIDATE.kicad_sch, input_protection_CANDIDATE_REVISED.kicad_sch]
2026-10-24 docs: record selected MINI fuse pair
2026-10-24 hardware: preserve recovered main PCB WIP checkpoint
    [Sirokko26201_control.kicad_pcb, Sirokko26201_control.kicad_sch, logic_power_24_5_DRAFT.kicad_sch, motor_pwm_DRAFT.kicad_sch, motor_pwm_REBUILD.kicad_sch, power_return_reset_DRAFT.kicad_sch, relay_level_shift_REVB.kicad_sch]
2026-10-25 hardware: WIP preserve TC_AIR_CS routed PCB candidate
    [Sirokko26201_control_spi_recovered.kicad_pcb]
2026-10-25 firmware: WIP preserve verified ESP32-S3 build kit
2026-10-25 hardware: WIP preserve MINI CVCAP draft snapshot
    [input_protection_MINI_DRAFT-bom.csv, input_protection_MINI_DRAFT.kicad_pcb, input_protection_MINI_DRAFT.kicad_sch]
2026-10-25 hardware: WIP verify Murata CVCAP footprint and candidate
    [Murata_CVCAP_isolated.kicad_pcb, bom.csv, full-pinmap-diff.csv, input_protection_MINI_DRAFT.kicad_pcb, input_protection_MINI_DRAFT.kicad_sch]
2026-10-25 hardware: WIP preserve partial TC_EXH_CS snapshot 137-36
    [Sirokko26201_control_spi_verified_TC_EXH_CS_partial_verified.kicad_pcb]
2026-10-25 hardware: WIP preserve complete TC_EXH_CS snapshot 138-37
    [Sirokko26201_control_spi_verified_TC_EXH_CS_complete_WIP.kicad_pcb]
2026-10-25 firmware: WIP qualify PWM limits and true static motor output
2026-10-25 WIP firmware: integrate local controls and authenticated service paths
    [partitions.csv]
2026-10-25 hardware: WIP correct TVS and relay decisions and motor labels
    [motor_pwm_REBUILD.kicad_sch]
2026-10-25 hardware: WIP preserve full TC_SCK snapshot 152-41
    [Sirokko26201_control_spi_sck_full.kicad_pcb]
2026-10-25 firmware: publish reproducible 0.1.6-DRAFT bench kit
    [partition-decoded.csv, partitions.csv]
2026-10-25 hardware: WIP preserve verified DRDY GND snapshot 148-39
    [Sirokko26201_control_spi_verified_DRDY_complete_WIP.kicad_pcb]
2026-10-25 firmware: fix ST7789 timing and shared 20-row DMA geometry
    [board.hpp]
2026-10-25 hardware: WIP preserve verified MISO snapshot 159-42
    Preserve the accepted archive byte for byte in a separate immutable candidate; do not replace canonical hardware or earlier snapshots.
    MISO continuity is recorded for U9.11/U10.11/J1.19. Still NOT FOR ORDER: SCK/MOSI unfinished, 175 unconnected items, four existing library warnings; no physical SPI qualification.
    [Sirokko26201_control_spi_verified_DRDY_complete_WIP.kicad_pcb]
2026-10-25 firmware: publish verified 0.1.7-DRAFT bench kit
    [partition-decoded.csv, partitions.csv]
2026-10-25 hardware: WIP preserve verified SCK MISO snapshot 176-47
    Publish the accepted integrated SCK/MISO/DRDY/GND archive as a new immutable candidate after MISO 159-42. Keep canonical hardware, prior candidates and firmware unchanged.
    Still NOT FOR ORDER: MOSI unfinished, 172 unconnected items and four existing library warnings. No physical SPI frequency, return-path or EMC qualification.
    [Sirokko26201_control_spi_verified_DRDY_complete_WIP.kicad_pcb]
2026-10-25 hardware: WIP publish partial MOSI U9-TFT with repaired GND
    [Sirokko26201_control_spi_MOSI_partial_GNDrepaired.kicad_pcb]
2026-10-25 hardware: WIP publish all-four MOSI connectivity 194-52
    [parent_MOSI_all_four_connected.kicad_pcb]
2026-10-25 docs: WIP preserve R9001 CAD review with HOLD unchanged
2026-10-25 hardware: WIP publish RTC DS3231 CR2032 draft schematic
    [RTC_DS3231_CR2032_DRAFT.kicad_sch, RTC_INTEGRATION_FIXTURE_NOT_PCB.kicad_sch]
2026-10-25 hardware: WIP unify motor and accepted SPI copper 194-52
    [Sirokko26201_control_motor_candidate.kicad_pcb, Sirokko26201_control_motor_candidate.kicad_sch, logic_power_24_5_DRAFT.kicad_sch, motor_pwm_REBUILD.kicad_sch]
2026-10-25 hardware: WIP continue unified TFT routing 215-55
    [Sirokko26201_control_motor_candidate.kicad_pcb]
2026-10-25 hardware: WIP route unified TFT power ground and EN 251-72
    [Sirokko26201_control_motor_candidate.kicad_pcb]
2026-10-25 docs: WIP freeze four-button GPIO8 draft-06 contract
    [BOOLEAN_MODEL_4096.csv]
2026-10-25 firmware: WIP four-button draft-06 gestures and fail-safe GPIO8
    [app_main.cpp, control.cpp, control.hpp]
2026-10-25 docs: WIP qualify NKK RESET contact candidate without PCB approval
    [RESET_NKK_CONTACT_CHECK.csv]
2026-10-25 firmware: WIP publish verified 0.1.8 draft-06 bench kit
    [BOOLEAN_MODEL_4096.csv, RESET_NKK_CONTACT_CHECK.csv, partition-decoded.csv, partitions.csv]
2026-10-25 docs: WIP expose draft-06 kit and PCB incompatibility at entry points
2026-10-25 hardware: WIP publish U4/U5 logic supply routing 283/72
    [Sirokko26201_control_motor_candidate.kicad_pcb]
2026-10-25 hardware: WIP publish U3/C3 supply 294/74 and RESET erratum
    [Sirokko26201_control_motor_candidate.kicad_pcb]
2026-10-25 hardware: WIP publish U2/C2 supply routing 313/74
    [Sirokko26201_control_motor_candidate.kicad_pcb]
2026-10-25 hardware: WIP publish protection logic signals 326/78
    [Sirokko26201_control_motor_candidate.kicad_pcb]
2026-10-25 hardware: WIP restore R9001 FPID and confirm nominal land pattern
    [Sirokko26201_control_motor_candidate.kicad_pcb]
2026-10-25 hardware: WIP Kelvin routes R9001/INA240 340/78, DRC 180
    [Sirokko26201_control_motor_candidate.kicad_pcb]
2026-10-25 hardware: WIP OCP TLV9020 and INA240 routing 375/80, DRC 167
    [BOM_CHANGE_U9003_DRAFT.csv, Sirokko26201_control_motor_candidate.kicad_pcb, motor_pwm_REBUILD.kicad_sch, schematic_format_changes.json]
2026-10-25 hardware: WIP mounting keepouts and motor logic 405/82, DRC 158
    [Sirokko26201_control_motor_candidate.kicad_pcb]
2026-10-25 docs: WIP panel UX with separate controls and rotary encoder
2026-10-25 hardware: WIP motor ground candidate, DRC 158 to 157
    [Sirokko26201_control_motor_candidate.kicad_pcb, Sirokko26201_control_motor_candidate.kicad_sch, logic_power_24_5_DRAFT.kicad_sch, motor_pwm_DRAFT.kicad_sch, motor_pwm_REBUILD.kicad_sch, power_return_reset_DRAFT.kicad_sch, relay_level_shift_REVB.kicad_sch]
2026-10-25 hardware: WIP motor supply v5 candidate 421/86, DRC 156
    [Sirokko26201_control_motor_candidate.kicad_pcb, Sirokko26201_control_motor_candidate.kicad_sch, logic_power_24_5_DRAFT.kicad_sch, motor_pwm_DRAFT.kicad_sch, motor_pwm_REBUILD.kicad_sch, power_return_reset_DRAFT.kicad_sch, relay_level_shift_REVB.kicad_sch]
2026-10-25 hardware: WIP motor logic supply v2 445/96, DRC 147
    [Sirokko26201_control_motor_candidate.kicad_pcb, Sirokko26201_control_motor_candidate.kicad_sch, logic_power_24_5_DRAFT.kicad_sch, motor_pwm_DRAFT.kicad_sch, motor_pwm_REBUILD.kicad_sch, power_return_reset_DRAFT.kicad_sch, relay_level_shift_REVB.kicad_sch]
2026-10-25 hardware: WIP driver DC v3 478/101, DRC 138
    [Sirokko26201_control_motor_candidate.kicad_pcb, Sirokko26201_control_motor_candidate.kicad_sch, logic_power_24_5_DRAFT.kicad_sch, motor_pwm_DRAFT.kicad_sch, motor_pwm_REBUILD.kicad_sch, power_return_reset_DRAFT.kicad_sch, relay_level_shift_REVB.kicad_sch]
2026-10-25 hardware: WIP correct D9002 MBR1100G package to DO-41
    [Sirokko26201_control_motor_candidate.kicad_pcb, Sirokko26201_control_motor_candidate.kicad_sch, logic_power_24_5_DRAFT.kicad_sch, motor_pwm_DRAFT.kicad_sch, motor_pwm_REBUILD.kicad_sch, power_return_reset_DRAFT.kicad_sch, relay_level_shift_REVB.kicad_sch]
2026-10-25 hardware: WIP bootstrap route 491/102, DRC 133
    [Sirokko26201_control_motor_candidate.kicad_pcb, Sirokko26201_control_motor_candidate.kicad_sch, logic_power_24_5_DRAFT.kicad_sch, motor_pwm_DRAFT.kicad_sch, motor_pwm_REBUILD.kicad_sch, power_return_reset_DRAFT.kicad_sch, relay_level_shift_REVB.kicad_sch]
2026-10-25 hardware: WIP gate and LM317 input route 506/102, DRC 129
    [Sirokko26201_control_motor_candidate.kicad_pcb, Sirokko26201_control_motor_candidate.kicad_sch, logic_power_24_5_DRAFT.kicad_sch, motor_pwm_DRAFT.kicad_sch, motor_pwm_REBUILD.kicad_sch, power_return_reset_DRAFT.kicad_sch, relay_level_shift_REVB.kicad_sch]
2026-10-25 hardware: WIP U9005/U9006 local bypass 518/104, DRC 129
    [Sirokko26201_control_motor_candidate.kicad_pcb, Sirokko26201_control_motor_candidate.kicad_sch, logic_power_24_5_DRAFT.kicad_sch, motor_pwm_DRAFT.kicad_sch, motor_pwm_REBUILD.kicad_sch, power_return_reset_DRAFT.kicad_sch, relay_level_shift_REVB.kicad_sch]
2026-10-26 hardware: WIP FAN_REQUEST/SPEED_CMD routing 554/126, DRC 122
    [Sirokko26201_control_motor_candidate.kicad_pcb, Sirokko26201_control_motor_candidate.kicad_sch, logic_power_24_5_DRAFT.kicad_sch, motor_pwm_DRAFT.kicad_sch, motor_pwm_REBUILD.kicad_sch, power_return_reset_DRAFT.kicad_sch, relay_level_shift_REVB.kicad_sch]
2026-10-26 hardware: WIP bias supply and ground routing 575/130, DRC 109
    [Sirokko26201_control_motor_candidate.kicad_pcb, Sirokko26201_control_motor_candidate.kicad_sch, logic_power_24_5_DRAFT.kicad_sch, motor_pwm_DRAFT.kicad_sch, motor_pwm_REBUILD.kicad_sch, power_return_reset_DRAFT.kicad_sch, relay_level_shift_REVB.kicad_sch]
2026-10-26 hardware: WIP MAX31856 U10 supply and ground 597/138, DRC 103
    [Sirokko26201_control_motor_candidate.kicad_pcb, Sirokko26201_control_motor_candidate.kicad_sch, logic_power_24_5_DRAFT.kicad_sch, motor_pwm_DRAFT.kicad_sch, motor_pwm_REBUILD.kicad_sch, power_return_reset_DRAFT.kicad_sch, relay_level_shift_REVB.kicad_sch]
2026-10-26 hardware: WIP MAX31856 U9 capacitor ground 602/138, DRC 101
    [Sirokko26201_control_motor_candidate.kicad_pcb, Sirokko26201_control_motor_candidate.kicad_sch, logic_power_24_5_DRAFT.kicad_sch, motor_pwm_DRAFT.kicad_sch, motor_pwm_REBUILD.kicad_sch, power_return_reset_DRAFT.kicad_sch, relay_level_shift_REVB.kicad_sch]
2026-10-26 hardware: WIP U6 supply and static input ties 621/138, DRC 92
    [Sirokko26201_control_motor_candidate.kicad_pcb, Sirokko26201_control_motor_candidate.kicad_sch, logic_power_24_5_DRAFT.kicad_sch, motor_pwm_DRAFT.kicad_sch, motor_pwm_REBUILD.kicad_sch, power_return_reset_DRAFT.kicad_sch, relay_level_shift_REVB.kicad_sch]
2026-10-26 hardware: WIP U8 C8 supply bypass 638/146, DRC 88
    [Sirokko26201_control_motor_candidate.kicad_pcb, Sirokko26201_control_motor_candidate.kicad_sch, logic_power_24_5_DRAFT.kicad_sch, motor_pwm_DRAFT.kicad_sch, motor_pwm_REBUILD.kicad_sch, power_return_reset_DRAFT.kicad_sch, relay_level_shift_REVB.kicad_sch]
2026-10-26 hardware: WIP watchdog rails 679/155, DRC 76
    [Sirokko26201_control_motor_candidate.kicad_pcb, Sirokko26201_control_motor_candidate.kicad_sch, logic_power_24_5_DRAFT.kicad_sch, motor_pwm_DRAFT.kicad_sch, motor_pwm_REBUILD.kicad_sch, power_return_reset_DRAFT.kicad_sch, relay_level_shift_REVB.kicad_sch]
2026-10-26 hardware: WIP three relay sockets, mechanical placement only
    [Sirokko26201_control_motor_candidate.kicad_pcb, Sirokko26201_control_motor_candidate.kicad_sch, logic_power_24_5_DRAFT.kicad_sch, motor_pwm_DRAFT.kicad_sch, motor_pwm_REBUILD.kicad_sch, power_return_reset_DRAFT.kicad_sch, relay_level_shift_REVB.kicad_sch]
2026-10-26 docs: freeze development freedom and optional relay qualification
2026-10-26 hardware: freeze routed J12 ROOM_DQ candidate, DRAFT only
    [Sirokko26201_control_motor_candidate.kicad_pcb, Sirokko26201_control_motor_candidate.kicad_sch, logic_power_24_5_DRAFT.kicad_sch, motor_pwm_DRAFT.kicad_sch, motor_pwm_REBUILD.kicad_sch, power_return_reset_DRAFT.kicad_sch, relay_level_shift_REVB.kicad_sch]
2026-10-26 firmware: publish verified 0.1.9 timer bench kit and source identities
    [partitions.csv]
2026-10-26 hardware: freeze v2 edge terminal placement, DRAFT only
    [Sirokko26201_control_motor_candidate.kicad_pcb, Sirokko26201_control_motor_candidate.kicad_sch, logic_power_24_5_DRAFT.kicad_sch, motor_pwm_DRAFT.kicad_sch, motor_pwm_REBUILD.kicad_sch, power_return_reset_DRAFT.kicad_sch, relay_level_shift_REVB.kicad_sch]
2026-10-26 docs: confirm encoder and unified start-stop panel contract
2026-10-26 hardware: WIP frozen layout v2 572b56702daa
    [Sirokko26201_control_motor_candidate.kicad_pcb]
2026-10-26 hardware: freeze panel v2 mechanical candidate
    Preserve the frozen source bytes as a separate BENCH ONLY candidate. Retain DRC 0 errors/12 warnings/84 unconnected and ERC 0 errors/11 warnings; TFT window and z_front remain HOLD pending control assembly.
    [Sirokko26201_control_motor_candidate-drc.json, Sirokko26201_control_motor_candidate-erc.json, Sirokko26201_control_motor_candidate.kicad_pcb, Sirokko26201_control_motor_candidate.kicad_sch, logic_power_24_5_DRAFT.kicad_sch, motor_pwm_DRAFT.kicad_sch, motor_pwm_REBUILD.kicad_sch, power_return_reset_DRAFT.kicad_sch]
2026-10-26 docs: fix design without samples and post-PCB purchasing requirements
2026-10-26 hardware: WIP TFT mounting keepout correction
    [Sirokko26201_control_motor_candidate.kicad_pcb]
2026-10-26 hardware: WIP approved TFT washer and engineering completion requirement
    [Sirokko26201_control_motor_candidate.kicad_pcb, TFT_MECHANICAL_BOM.csv]
2026-10-26 hardware: WIP selected Connfly TFT socket and assembly limits
    [Sirokko26201_control_motor_candidate.kicad_pcb, TFT_MECHANICAL_BOM.csv]
2026-10-26 hardware: WIP UI centres and mirrored operator layout
    Publish frozen UI PCB 57f75761 with centre properties for J22/J23/J24 and the mirrored B-side UI/TFT-only plan. J22 centre is 102.25,146.50 mm, not its footprint origin. Geometry and copper are unchanged; hidden metadata font defaults were made explicit by KiCad.
    DRAFT / NOT FOR ORDER / NO FIRE TESTING. Not the full board view or an enclosure drilling template. TFT height chain and overall layout remain unaccepted. Supplied DRC: 0 errors in violations, 12 warnings, 84 separate unconnected errors; 5 preexisting ignored checks retained. No new native DRC run or production release.
    [Sirokko_UI_57f75761.kicad_pcb]
2026-10-26 hardware: WIP H5/H6 mounting clearance correction
    Publish frozen PCB 5207650d: replace the two existing 7x7 mm H5/H6 rule areas with 64-vertex R5.01 mm polygons on F.Cu and B.Cu. Tracks, vias and copper fill remain forbidden; own NPTH pads remain permitted. Copper geometry is unchanged; hidden metadata font defaults were made explicit by KiCad.
    DRAFT / NOT FOR ORDER / NO FIRE TESTING. Mechanical-layer mirrored B-view only, not copper or 3D. TFT assembly heights and overall layout remain unaccepted. Supplied project-context DRC: 0 errors in violations, 12 warnings, 84 separate unconnected errors; the same 5 preexisting ignored checks retained, none newly disabled. No new native DRC run. Pres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
    [Sirokko26201_control_motor_candidate.kicad_pcb]
2026-10-26 hardware: WIP TFT BL panel window study
    Publish the three frozen TFT/UI study files based on PCB 5207650d. Document the invalid centered MH5 A.A. contour and the proposed nominal 52 x 36.5 mm full-BL window; no CAD or prior snapshot changes.
    DRAFT / NOT FOR ORDER / NOT FOR MANUFACTURE / NO FIRE TESTING. Position tolerances, assembly heights, control openings and overall layout remain unqualified. No PCB, firmware or system changes.
2026-10-26 hardware: WIP accepted REQ-029 and YD panel-v2 snapshot
    [DEVKIT_YD_V14_TO_CARRIER_PINMAP.csv, Sirokko26201_control_motor_candidate-drc.json, Sirokko26201_control_motor_candidate.kicad_pcb]
2026-10-26 hardware: WIP local U7 C7 copper and TFT keepout erratum
    [Sirokko26201_control_motor_candidate.kicad_pcb]
2026-10-26 hardware: WIP accepted TFT D8 keepouts and driver correction rationale
    [Sirokko26201_control_motor_candidate.kicad_pcb, Sirokko26201_control_motor_candidate.kicad_sch, logic_power_24_5_DRAFT.kicad_sch, motor_pwm_DRAFT.kicad_sch, motor_pwm_REBUILD.kicad_sch, power_return_reset_DRAFT.kicad_sch, relay_level_shift_REVB.kicad_sch]
2026-10-26 docs: WIP YD power limits and knob axial-chain research
2026-10-26 docs: WIP partial 3.3V load budget and qualification limits
2026-10-26 docs: WIP panel clearances, dimensioned UI and bootstrap charge
2026-10-27 docs: record accepted D9002 pin map without CAD replacement
2026-10-27 hardware: publish accepted J27 J28 placement WIP 14e676dd
    [Sirokko26201_control_motor_candidate.kicad_pcb, Sirokko26201_control_motor_candidate.kicad_sch, logic_power_24_5_DRAFT.kicad_sch, motor_pwm_DRAFT.kicad_sch, motor_pwm_REBUILD.kicad_sch, power_return_reset_DRAFT.kicad_sch, relay_level_shift_REVB.kicad_sch]
2026-10-27 docs: select Waveshare 18366 cable interface and recover decisions
2026-10-27 docs: record Type 1 TFT header and SPI power reviews
2026-10-27 docs: correct TFT power boundary and record logic power findings
2026-10-27 hardware: publish standalone TPS62162 draft and native checks
    [tft_power_tps62162_review_DRAFT.kicad_sch]
2026-10-27 hardware: fix TPS62162 draft fields and identify pull-ups
    [tft_power_tps62162_review_DRAFT.kicad_sch]
2026-10-27 hardware: separate TFT input label from power flag
    [tft_power_tps62162_review_DRAFT.kicad_sch]
2026-10-27 hardware: assign eight TPS62162 draft footprints
    [tft_power_tps62162_review_DRAFT.kicad_sch]
2026-10-27 hardware: publish WIP local TFT reset candidate
    [sirokko_tft_reset_local_DRAFT.kicad_sch]
2026-10-27 docs: WIP correct LM5013 frequency units and current target
2026-10-27 docs: WIP publish frozen TFT SPI and relay checks
2026-10-27 hardware: WIP preserve native BEFORE_MOTOR_WING_RUN243
    [Sirokko26201_control_motor_candidate.kicad_pcb, Sirokko26201_control_motor_candidate.kicad_sch, logic_power_24_5_DRAFT.kicad_sch, motor_pwm_REBUILD.kicad_sch, sirokko_tft_reset_local_DRAFT.kicad_sch, sirokko_tft_spi_isolation_DRAFT.kicad_sch, tft_power_tps62162_review_DRAFT.kicad_sch]
2026-10-27 hardware: WIP preserve frozen motor right wing f0170893
    [Sirokko26201_control_motor_candidate.kicad_pcb, Sirokko26201_control_motor_candidate.kicad_sch, logic_power_24_5_DRAFT.kicad_sch, motor_pwm_REBUILD.kicad_sch, sirokko_tft_reset_local_DRAFT.kicad_sch, sirokko_tft_spi_isolation_DRAFT.kicad_sch, tft_power_tps62162_review_DRAFT.kicad_sch]
2026-10-27 hardware: publish frozen H11 H12 WIP 0179185b
    [Sirokko26201_control_motor_candidate.kicad_pcb, Sirokko26201_control_motor_candidate.kicad_sch, logic_power_24_5_DRAFT.kicad_sch, motor_pwm_REBUILD.kicad_sch, sirokko_tft_reset_local_DRAFT.kicad_sch, sirokko_tft_spi_isolation_DRAFT.kicad_sch, tft_power_tps62162_review_DRAFT.kicad_sch]
2026-10-27 hardware: publish frozen left strip WIP 02aed516
    [Sirokko26201_control_motor_candidate.kicad_pcb, Sirokko26201_control_motor_candidate.kicad_sch, logic_power_24_5_DRAFT.kicad_sch, motor_pwm_REBUILD.kicad_sch, sirokko_tft_reset_local_DRAFT.kicad_sch, sirokko_tft_spi_isolation_DRAFT.kicad_sch, tft_power_tps62162_review_DRAFT.kicad_sch]
2026-10-27 docs(hardware): publish f1ffc0b3 pre-rectangle WIP
    [BOM_DRAFT_NOT_FOR_ORDER.csv, Sirokko26201_control_motor_candidate.kicad_pcb, Sirokko26201_control_motor_candidate.kicad_sch, logic_power_24_5_DRAFT.kicad_sch, motor_pwm_REBUILD.kicad_sch, sirokko_tft_reset_local_DRAFT.kicad_sch, sirokko_tft_spi_isolation_DRAFT.kicad_sch, tft_power_tps62162_review_DRAFT.kicad_sch]
2026-10-27 docs(hardware): publish metadata 358262f0 and BOM candidate
    [COMPONENT_SELECTIONS.csv, PROPOSED_BOM_NOT_CANONICAL.csv, Sirokko26201_control_motor_candidate.kicad_pcb, Sirokko26201_control_motor_candidate.kicad_sch, logic_power_24_5_DRAFT.kicad_sch, motor_pwm_REBUILD.kicad_sch, pcb_scope_audit.json, production_bom.csv]
2026-10-28 docs(hardware): publish BOM46 and corrected F1 screen
    [PROPOSED_BOM_NOT_CANONICAL.csv]
2026-10-28 hardware: publish PCB 05c58003 WIP snapshot
    [Sirokko26201_control_motor_candidate.kicad_pcb, Sirokko26201_control_motor_candidate.kicad_sch, Sirokko26201_control_motor_candidate.xml, before_Sirokko26201_control_motor_candidate.xml, before_production_bom.csv, logic_power_24_5_DRAFT.kicad_sch, motor_pwm_REBUILD.kicad_sch, production_bom.csv]
2026-10-28 hardware: publish relay integration WIP fc6a6d98
    [FINAL_BOM_DETAILED.csv, Sirokko26201_control_motor_candidate.kicad_pcb, Sirokko26201_control_motor_candidate.kicad_sch, logic_power_24_5_DRAFT.kicad_sch, motor_pwm_REBUILD.kicad_sch, sirokko_tft_reset_local_DRAFT.kicad_sch, sirokko_tft_spi_isolation_DRAFT.kicad_sch, tft_power_tps62162_review_DRAFT.kicad_sch]
2026-10-28 hardware: publish input repair WIP f251bdfc
    [Sirokko26201_control_motor_candidate.kicad_pcb, Sirokko26201_control_motor_candidate.kicad_sch, Sirokko_Input_Protection_WIP.kicad_sch, logic_power_24_5_DRAFT.kicad_sch, motor_pwm_REBUILD.kicad_sch, sirokko_tft_reset_local_DRAFT.kicad_sch, sirokko_tft_spi_isolation_DRAFT.kicad_sch, tft_power_tps62162_review_DRAFT.kicad_sch]
2026-10-28 hardware: publish unified layout WIP da1962d9
    [BOM.csv, BOM_EXACT_MPN.csv, Sirokko26201_control_motor_candidate.kicad_pcb, Sirokko26201_control_motor_candidate.kicad_sch, Sirokko_Input_Protection_WIP.kicad_sch, logic_power_24_5_DRAFT.kicad_sch, motor_pwm_REBUILD.kicad_sch, sirokko_tft_reset_local_DRAFT.kicad_sch]
2026-10-28 hardware: publish T521 frozen layout WIP
    [ASSEMBLY_HARDWARE_BOM_DRAFT.csv, BOM_latest.csv, EXTERNAL_PINMAP_DRAFT.csv, PCB_FOCUS_AUDIT.json, Sirokko26201_control_motor_candidate.kicad_pcb, Sirokko26201_control_motor_candidate.kicad_sch, Sirokko_Input_Protection_WIP.kicad_sch, logic_power_24_5_DRAFT.kicad_sch]
2026-10-28 docs: publish unified closure and wiring drafts
    [EXTERNAL_PINMAP_DRAFT.csv]
2026-10-28 docs: publish TFT mount procurement candidate
    [TFT_MOUNT_PROCUREMENT_CANDIDATE.csv]
2026-10-28 hardware: publish panel-axis and relay 3D draft
    [EXTERNAL_PINMAP_DRAFT.csv, Sirokko26201_control_motor_candidate.kicad_pcb, Sirokko26201_control_motor_candidate.kicad_sch, Sirokko_Input_Protection_WIP.kicad_sch, baseline_before_18366.kicad_pcb, before_safezone_reroute.kicad_pcb, logic_power_24_5_DRAFT.kicad_sch, motor_pwm_REBUILD.kicad_sch]
2026-10-28 hardware: publish Harwin 4fe3 native WIP
    [Sirokko26201_control_motor_candidate-bom.csv, Sirokko26201_control_motor_candidate.kicad_pcb, Sirokko26201_control_motor_candidate.kicad_sch, Sirokko_Input_Protection_WIP.kicad_sch, logic_power_24_5_DRAFT.kicad_sch, motor_pwm_REBUILD.kicad_sch, sirokko_tft_reset_local_DRAFT.kicad_sch, sirokko_tft_spi_isolation_DRAFT.kicad_sch]
2026-10-28 docs: publish free-cable assembly checkpoint
2026-10-28 hardware: publish TFT power feed WIP 965b97be
    [Sirokko26201_control_motor_candidate.kicad_pcb, Sirokko26201_control_motor_candidate.kicad_sch, Sirokko_Input_Protection_WIP.kicad_sch, logic_power_24_5_DRAFT.kicad_sch, motor_pwm_REBUILD.kicad_sch, sirokko_tft_reset_local_DRAFT.kicad_sch, sirokko_tft_spi_isolation_DRAFT.kicad_sch, tft_power_tps62162_review_DRAFT.kicad_sch]
2026-10-28 hardware: publish TFT full power WIP 02a52c42
    [Sirokko26201_control_motor_candidate.kicad_pcb, Sirokko26201_control_motor_candidate.kicad_sch, Sirokko_Input_Protection_WIP.kicad_sch, logic_power_24_5_DRAFT.kicad_sch, motor_pwm_REBUILD.kicad_sch, sirokko_tft_reset_local_DRAFT.kicad_sch, sirokko_tft_spi_isolation_DRAFT.kicad_sch, tft_power_tps62162_review_DRAFT.kicad_sch]
2026-10-28 hardware: publish TFT reset WIP fe7754dc
    [Sirokko26201_control_motor_candidate.kicad_pcb, Sirokko26201_control_motor_candidate.kicad_sch, Sirokko_Input_Protection_WIP.kicad_sch, logic_power_24_5_DRAFT.kicad_sch, motor_pwm_REBUILD.kicad_sch, sirokko_tft_reset_local_DRAFT.kicad_sch, sirokko_tft_spi_isolation_DRAFT.kicad_sch, tft_power_tps62162_review_DRAFT.kicad_sch]
2026-10-28 hardware: publish TFT SPI outputs WIP 6d0ae9c1
    [Sirokko26201_control_motor_candidate.kicad_pcb, Sirokko26201_control_motor_candidate.kicad_sch, Sirokko_Input_Protection_WIP.kicad_sch, logic_power_24_5_DRAFT.kicad_sch, motor_pwm_REBUILD.kicad_sch, sirokko_tft_reset_local_DRAFT.kicad_sch, sirokko_tft_spi_isolation_DRAFT.kicad_sch, tft_power_tps62162_review_DRAFT.kicad_sch]
2026-10-28 hardware: publish TFT control inputs WIP a13d8fa2
    [Sirokko26201_control_motor_candidate.kicad_pcb, Sirokko26201_control_motor_candidate.kicad_sch, Sirokko_Input_Protection_WIP.kicad_sch, logic_power_24_5_DRAFT.kicad_sch, motor_pwm_REBUILD.kicad_sch, sirokko_tft_reset_local_DRAFT.kicad_sch, sirokko_tft_spi_isolation_DRAFT.kicad_sch, tft_power_tps62162_review_DRAFT.kicad_sch]
2026-10-28 hardware: publish DRV8803 local bypass WIP fe3d69a4
    [Sirokko26201_control_motor_candidate.kicad_pcb, Sirokko26201_control_motor_candidate.kicad_sch, Sirokko_Input_Protection_WIP.kicad_sch, logic_power_24_5_DRAFT.kicad_sch, motor_pwm_REBUILD.kicad_sch, sirokko_tft_reset_local_DRAFT.kicad_sch, sirokko_tft_spi_isolation_DRAFT.kicad_sch, tft_power_tps62162_review_DRAFT.kicad_sch]
2026-10-28 hardware: publish DRV8803 thermal copper WIP 59f84adb
    [Sirokko26201_control_motor_candidate.kicad_pcb, Sirokko26201_control_motor_candidate.kicad_sch, Sirokko_Input_Protection_WIP.kicad_sch, logic_power_24_5_DRAFT.kicad_sch, motor_pwm_REBUILD.kicad_sch, sirokko_tft_reset_local_DRAFT.kicad_sch, sirokko_tft_spi_isolation_DRAFT.kicad_sch, tft_power_tps62162_review_DRAFT.kicad_sch]
2026-10-28 hardware: publish DRV pull-down WIP 614aa289
    [Sirokko26201_control_motor_candidate.kicad_pcb, Sirokko26201_control_motor_candidate.kicad_sch, Sirokko_Input_Protection_WIP.kicad_sch, logic_power_24_5_DRAFT.kicad_sch, motor_pwm_REBUILD.kicad_sch, sirokko_tft_reset_local_DRAFT.kicad_sch, sirokko_tft_spi_isolation_DRAFT.kicad_sch, tft_power_tps62162_review_DRAFT.kicad_sch]
2026-10-28 hardware: publish DRV fault WIP 683cc36b
    [Sirokko26201_control_motor_candidate.kicad_pcb, Sirokko26201_control_motor_candidate.kicad_sch, Sirokko_Input_Protection_WIP.kicad_sch, logic_power_24_5_DRAFT.kicad_sch, motor_pwm_REBUILD.kicad_sch, sirokko_tft_reset_local_DRAFT.kicad_sch, sirokko_tft_spi_isolation_DRAFT.kicad_sch, tft_power_tps62162_review_DRAFT.kicad_sch]
2026-10-28 hardware: publish DRV safety WIP 1e41e99a
    [Sirokko26201_control_motor_candidate.kicad_pcb, Sirokko26201_control_motor_candidate.kicad_sch, Sirokko_Input_Protection_WIP.kicad_sch, logic_power_24_5_DRAFT.kicad_sch, motor_pwm_REBUILD.kicad_sch, sirokko_tft_reset_local_DRAFT.kicad_sch, sirokko_tft_spi_isolation_DRAFT.kicad_sch, tft_power_tps62162_review_DRAFT.kicad_sch]
2026-10-28 hardware: publish DRV fault U6 WIP 387b0ce7
    [Sirokko26201_control_motor_candidate.kicad_pcb, Sirokko26201_control_motor_candidate.kicad_sch, Sirokko_Input_Protection_WIP.kicad_sch, logic_power_24_5_DRAFT.kicad_sch, motor_pwm_REBUILD.kicad_sch, sirokko_tft_reset_local_DRAFT.kicad_sch, sirokko_tft_spi_isolation_DRAFT.kicad_sch, tft_power_tps62162_review_DRAFT.kicad_sch]
2026-10-28 hardware: publish CLEAR_OK and ALLOW_LATCH WIP
    [Sirokko26201_control_motor_candidate.kicad_pcb, Sirokko26201_control_motor_candidate.kicad_sch, Sirokko_Input_Protection_WIP.kicad_sch, logic_power_24_5_DRAFT.kicad_sch, motor_pwm_REBUILD.kicad_sch, sirokko_tft_reset_local_DRAFT.kicad_sch, sirokko_tft_spi_isolation_DRAFT.kicad_sch, tft_power_tps62162_review_DRAFT.kicad_sch]
2026-10-28 hardware: publish CLEAR_OK_BASE WIP
    [Sirokko26201_control_motor_candidate.kicad_pcb, Sirokko26201_control_motor_candidate.kicad_sch, Sirokko_Input_Protection_WIP.kicad_sch, logic_power_24_5_DRAFT.kicad_sch, motor_pwm_REBUILD.kicad_sch, sirokko_tft_reset_local_DRAFT.kicad_sch, sirokko_tft_spi_isolation_DRAFT.kicad_sch, tft_power_tps62162_review_DRAFT.kicad_sch]
2026-10-28 hardware: publish safety and reset WIP
    [Sirokko26201_control_motor_candidate.kicad_pcb, Sirokko26201_control_motor_candidate.kicad_sch, Sirokko_Input_Protection_WIP.kicad_sch, logic_power_24_5_DRAFT.kicad_sch, motor_pwm_REBUILD.kicad_sch, sirokko_tft_reset_local_DRAFT.kicad_sch, sirokko_tft_spi_isolation_DRAFT.kicad_sch, tft_power_tps62162_review_DRAFT.kicad_sch]
2026-10-28 hardware: publish local P24 routing WIP
    [Sirokko26201_control_motor_candidate.kicad_pcb, Sirokko26201_control_motor_candidate.kicad_sch, Sirokko_Input_Protection_WIP.kicad_sch, logic_power_24_5_DRAFT.kicad_sch, motor_pwm_REBUILD.kicad_sch, sirokko_tft_reset_local_DRAFT.kicad_sch, sirokko_tft_spi_isolation_DRAFT.kicad_sch, tft_power_tps62162_review_DRAFT.kicad_sch]
2026-10-28 hardware: publish local U20 power WIP
    [Sirokko26201_control_motor_candidate.kicad_pcb, Sirokko26201_control_motor_candidate.kicad_sch, Sirokko_Input_Protection_WIP.kicad_sch, logic_power_24_5_DRAFT.kicad_sch, motor_pwm_REBUILD.kicad_sch, sirokko_tft_reset_local_DRAFT.kicad_sch, sirokko_tft_spi_isolation_DRAFT.kicad_sch, tft_power_tps62162_review_DRAFT.kicad_sch]
2026-10-28 hardware: publish P24 main-feed WIP
    [Sirokko26201_control_motor_candidate.kicad_pcb, Sirokko26201_control_motor_candidate.kicad_sch, Sirokko_Input_Protection_WIP.kicad_sch, logic_power_24_5_DRAFT.kicad_sch, motor_pwm_REBUILD.kicad_sch, sirokko_tft_reset_local_DRAFT.kicad_sch, sirokko_tft_spi_isolation_DRAFT.kicad_sch, tft_power_tps62162_review_DRAFT.kicad_sch]
2026-10-28 hardware: publish P24_PRESENT WIP
    [Sirokko26201_control_motor_candidate.kicad_pcb, Sirokko26201_control_motor_candidate.kicad_sch, Sirokko_Input_Protection_WIP.kicad_sch, logic_power_24_5_DRAFT.kicad_sch, motor_pwm_REBUILD.kicad_sch, sirokko_tft_reset_local_DRAFT.kicad_sch, sirokko_tft_spi_isolation_DRAFT.kicad_sch, tft_power_tps62162_review_DRAFT.kicad_sch]
2026-10-28 hardware: publish UI power WIP
    [Sirokko26201_control_motor_candidate.kicad_pcb, Sirokko26201_control_motor_candidate.kicad_sch, Sirokko_Input_Protection_WIP.kicad_sch, logic_power_24_5_DRAFT.kicad_sch, motor_pwm_REBUILD.kicad_sch, sirokko_tft_reset_local_DRAFT.kicad_sch, sirokko_tft_spi_isolation_DRAFT.kicad_sch, tft_power_tps62162_review_DRAFT.kicad_sch]
2026-10-28 hardware: publish local start contacts WIP
    [Sirokko26201_control_motor_candidate.kicad_pcb, Sirokko26201_control_motor_candidate.kicad_sch, Sirokko_Input_Protection_WIP.kicad_sch, logic_power_24_5_DRAFT.kicad_sch, motor_pwm_REBUILD.kicad_sch, sirokko_tft_reset_local_DRAFT.kicad_sch, sirokko_tft_spi_isolation_DRAFT.kicad_sch, tft_power_tps62162_review_DRAFT.kicad_sch]
2026-10-28 hardware: publish START_REQUEST to U5 WIP
    [Sirokko26201_control_motor_candidate.kicad_pcb, Sirokko26201_control_motor_candidate.kicad_sch, Sirokko_Input_Protection_WIP.kicad_sch, logic_power_24_5_DRAFT.kicad_sch, motor_pwm_REBUILD.kicad_sch, sirokko_tft_reset_local_DRAFT.kicad_sch, sirokko_tft_spi_isolation_DRAFT.kicad_sch, tft_power_tps62162_review_DRAFT.kicad_sch]
2026-10-28 hardware: publish local encoder support WIP
    [Sirokko26201_control_motor_candidate.kicad_pcb, Sirokko26201_control_motor_candidate.kicad_sch, Sirokko_Input_Protection_WIP.kicad_sch, logic_power_24_5_DRAFT.kicad_sch, motor_pwm_REBUILD.kicad_sch, sirokko_tft_reset_local_DRAFT.kicad_sch, sirokko_tft_spi_isolation_DRAFT.kicad_sch, tft_power_tps62162_review_DRAFT.kicad_sch]
2026-10-28 hardware: publish encoder switch routing WIP
    [Sirokko26201_control_motor_candidate.kicad_pcb, Sirokko26201_control_motor_candidate.kicad_sch, Sirokko_Input_Protection_WIP.kicad_sch, logic_power_24_5_DRAFT.kicad_sch, motor_pwm_REBUILD.kicad_sch, sirokko_tft_reset_local_DRAFT.kicad_sch, sirokko_tft_spi_isolation_DRAFT.kicad_sch, tft_power_tps62162_review_DRAFT.kicad_sch]
2026-10-28 hardware: publish encoder A/B routing WIP
    [Sirokko26201_control_motor_candidate.kicad_pcb, Sirokko26201_control_motor_candidate.kicad_sch, Sirokko_Input_Protection_WIP.kicad_sch, logic_power_24_5_DRAFT.kicad_sch, motor_pwm_REBUILD.kicad_sch, sirokko_tft_reset_local_DRAFT.kicad_sch, sirokko_tft_spi_isolation_DRAFT.kicad_sch, tft_power_tps62162_review_DRAFT.kicad_sch]
2026-10-28 hardware: publish encoder A pull-up WIP
    [Sirokko26201_control_motor_candidate.kicad_pcb, Sirokko26201_control_motor_candidate.kicad_sch, Sirokko_Input_Protection_WIP.kicad_sch, logic_power_24_5_DRAFT.kicad_sch, motor_pwm_REBUILD.kicad_sch, sirokko_tft_reset_local_DRAFT.kicad_sch, sirokko_tft_spi_isolation_DRAFT.kicad_sch, tft_power_tps62162_review_DRAFT.kicad_sch]
2026-10-28 hardware: publish encoder B pull-up WIP
    [Sirokko26201_control_motor_candidate.kicad_pcb, Sirokko26201_control_motor_candidate.kicad_sch, Sirokko_Input_Protection_WIP.kicad_sch, logic_power_24_5_DRAFT.kicad_sch, motor_pwm_REBUILD.kicad_sch, sirokko_tft_reset_local_DRAFT.kicad_sch, sirokko_tft_spi_isolation_DRAFT.kicad_sch, tft_power_tps62162_review_DRAFT.kicad_sch]
2026-10-28 hardware: publish encoder MCU routing WIP
    [Sirokko26201_control_motor_candidate.kicad_pcb, Sirokko26201_control_motor_candidate.kicad_sch, Sirokko_Input_Protection_WIP.kicad_sch, logic_power_24_5_DRAFT.kicad_sch, motor_pwm_REBUILD.kicad_sch, sirokko_tft_reset_local_DRAFT.kicad_sch, sirokko_tft_spi_isolation_DRAFT.kicad_sch, tft_power_tps62162_review_DRAFT.kicad_sch]
2026-10-28 hardware: publish START_REQUEST MCU routing WIP
    [Sirokko26201_control_motor_candidate.kicad_pcb, Sirokko26201_control_motor_candidate.kicad_sch, Sirokko_Input_Protection_WIP.kicad_sch, logic_power_24_5_DRAFT.kicad_sch, motor_pwm_REBUILD.kicad_sch, sirokko_tft_reset_local_DRAFT.kicad_sch, sirokko_tft_spi_isolation_DRAFT.kicad_sch, tft_power_tps62162_review_DRAFT.kicad_sch]
2026-10-29 hardware: complete START_REQUEST routing WIP
    [Sirokko26201_control_motor_candidate.kicad_pcb, Sirokko26201_control_motor_candidate.kicad_sch, Sirokko_Input_Protection_WIP.kicad_sch, logic_power_24_5_DRAFT.kicad_sch, motor_pwm_REBUILD.kicad_sch, sirokko_tft_reset_local_DRAFT.kicad_sch, sirokko_tft_spi_isolation_DRAFT.kicad_sch, tft_power_tps62162_review_DRAFT.kicad_sch]
2026-10-29 hardware: route HW_RESET_CLK WIP
    [Sirokko26201_control_motor_candidate.kicad_pcb, Sirokko26201_control_motor_candidate.kicad_sch, Sirokko_Input_Protection_WIP.kicad_sch, logic_power_24_5_DRAFT.kicad_sch, motor_pwm_REBUILD.kicad_sch, sirokko_tft_reset_local_DRAFT.kicad_sch, sirokko_tft_spi_isolation_DRAFT.kicad_sch, tft_power_tps62162_review_DRAFT.kicad_sch]
2026-10-29 hardware: publish DevKit GND WIP cc1447f2
    [Sirokko26201_control_motor_candidate.kicad_pcb, Sirokko26201_control_motor_candidate.kicad_sch, Sirokko_Input_Protection_WIP.kicad_sch, logic_power_24_5_DRAFT.kicad_sch, motor_pwm_REBUILD.kicad_sch, sirokko_tft_reset_local_DRAFT.kicad_sch, sirokko_tft_spi_isolation_DRAFT.kicad_sch, tft_power_tps62162_review_DRAFT.kicad_sch]
2026-10-29 hardware: publish EXT header power WIP 03d257f6
    [Sirokko26201_control_motor_candidate.kicad_pcb, Sirokko26201_control_motor_candidate.kicad_sch, Sirokko_Input_Protection_WIP.kicad_sch, logic_power_24_5_DRAFT.kicad_sch, motor_pwm_REBUILD.kicad_sch, sirokko_tft_reset_local_DRAFT.kicad_sch, sirokko_tft_spi_isolation_DRAFT.kicad_sch, tft_power_tps62162_review_DRAFT.kicad_sch]
2026-10-29 hardware: publish local D1 TVS buses WIP cbc1e192
    [Sirokko26201_control_motor_candidate.kicad_pcb, Sirokko26201_control_motor_candidate.kicad_sch, Sirokko_Input_Protection_WIP.kicad_sch, logic_power_24_5_DRAFT.kicad_sch, motor_pwm_REBUILD.kicad_sch, sirokko_tft_reset_local_DRAFT.kicad_sch, sirokko_tft_spi_isolation_DRAFT.kicad_sch, tft_power_tps62162_review_DRAFT.kicad_sch]
2026-10-29 docs: publish cbc1e192 PCB views
2026-10-29 hardware: publish U13 C24 routing WIP d9475d5e
    [Sirokko26201_control_motor_candidate.kicad_pcb, Sirokko26201_control_motor_candidate.kicad_sch, Sirokko_Input_Protection_WIP.kicad_sch, logic_power_24_5_DRAFT.kicad_sch, motor_pwm_REBUILD.kicad_sch, sirokko_tft_reset_local_DRAFT.kicad_sch, sirokko_tft_spi_isolation_DRAFT.kicad_sch, tft_power_tps62162_review_DRAFT.kicad_sch]
2026-10-29 hardware: publish EN OV divider routing WIP 2a7bf85c
    [Sirokko26201_control_motor_candidate.kicad_pcb, Sirokko26201_control_motor_candidate.kicad_sch, Sirokko_Input_Protection_WIP.kicad_sch, logic_power_24_5_DRAFT.kicad_sch, motor_pwm_REBUILD.kicad_sch, sirokko_tft_reset_local_DRAFT.kicad_sch, sirokko_tft_spi_isolation_DRAFT.kicad_sch, tft_power_tps62162_review_DRAFT.kicad_sch]
2026-10-29 hardware: publish REV MID signal routing WIP d3d80e54
    [Sirokko26201_control_motor_candidate.kicad_pcb, Sirokko26201_control_motor_candidate.kicad_sch, Sirokko_Input_Protection_WIP.kicad_sch, logic_power_24_5_DRAFT.kicad_sch, motor_pwm_REBUILD.kicad_sch, sirokko_tft_reset_local_DRAFT.kicad_sch, sirokko_tft_spi_isolation_DRAFT.kicad_sch, tft_power_tps62162_review_DRAFT.kicad_sch]
2026-10-29 hardware: publish gate resistor placement WIP 49978656
    [Sirokko26201_control_motor_candidate.kicad_pcb, Sirokko26201_control_motor_candidate.kicad_sch, Sirokko_Input_Protection_WIP.kicad_sch, logic_power_24_5_DRAFT.kicad_sch, motor_pwm_REBUILD.kicad_sch, sirokko_tft_reset_local_DRAFT.kicad_sch, sirokko_tft_spi_isolation_DRAFT.kicad_sch, tft_power_tps62162_review_DRAFT.kicad_sch]
2026-10-29 hardware: publish HGATE connectivity WIP 03b3a919
    [Sirokko26201_control_motor_candidate.kicad_pcb, Sirokko26201_control_motor_candidate.kicad_sch, Sirokko_Input_Protection_WIP.kicad_sch, logic_power_24_5_DRAFT.kicad_sch, motor_pwm_REBUILD.kicad_sch, sirokko_tft_reset_local_DRAFT.kicad_sch, sirokko_tft_spi_isolation_DRAFT.kicad_sch, tft_power_tps62162_review_DRAFT.kicad_sch]
2026-10-29 hardware: publish DGATE connectivity WIP 534eecf8
    [Sirokko26201_control_motor_candidate.kicad_pcb, Sirokko26201_control_motor_candidate.kicad_sch, Sirokko_Input_Protection_WIP.kicad_sch, logic_power_24_5_DRAFT.kicad_sch, motor_pwm_REBUILD.kicad_sch, sirokko_tft_reset_local_DRAFT.kicad_sch, sirokko_tft_spi_isolation_DRAFT.kicad_sch, tft_power_tps62162_review_DRAFT.kicad_sch]
2026-10-29 hardware: publish U13 ground return WIP
    [Sirokko26201_control_motor_candidate.kicad_pcb, Sirokko26201_control_motor_candidate.kicad_sch, Sirokko_Input_Protection_WIP.kicad_sch, logic_power_24_5_DRAFT.kicad_sch, motor_pwm_REBUILD.kicad_sch, sirokko_tft_reset_local_DRAFT.kicad_sch, sirokko_tft_spi_isolation_DRAFT.kicad_sch, tft_power_tps62162_review_DRAFT.kicad_sch]
2026-10-29 hardware: publish U13 VIN WIP 9a40a53c
    [Sirokko26201_control_motor_candidate.kicad_pcb, Sirokko26201_control_motor_candidate.kicad_sch, Sirokko_Input_Protection_WIP.kicad_sch, logic_power_24_5_DRAFT.kicad_sch, motor_pwm_REBUILD.kicad_sch, sirokko_tft_reset_local_DRAFT.kicad_sch, sirokko_tft_spi_isolation_DRAFT.kicad_sch, tft_power_tps62162_review_DRAFT.kicad_sch]
2026-10-29 hardware: publish U13 P24 WIP a07a93f8
    [Sirokko26201_control_motor_candidate.kicad_pcb, Sirokko26201_control_motor_candidate.kicad_sch, Sirokko_Input_Protection_WIP.kicad_sch, logic_power_24_5_DRAFT.kicad_sch, motor_pwm_REBUILD.kicad_sch, sirokko_tft_reset_local_DRAFT.kicad_sch, sirokko_tft_spi_isolation_DRAFT.kicad_sch, tft_power_tps62162_review_DRAFT.kicad_sch]
2026-10-29 hardware: publish cb0e1805 source-bank WIP
    [Sirokko26201_control_motor_candidate.kicad_pcb, Sirokko26201_control_motor_candidate.kicad_sch, Sirokko_Input_Protection_WIP.kicad_sch, logic_power_24_5_DRAFT.kicad_sch, motor_pwm_REBUILD.kicad_sch, sirokko_tft_reset_local_DRAFT.kicad_sch, sirokko_tft_spi_isolation_DRAFT.kicad_sch, tft_power_tps62162_review_DRAFT.kicad_sch]
2026-10-29 hardware: publish 35628a20 common-drain WIP
    [Sirokko26201_control_motor_candidate.kicad_pcb, Sirokko26201_control_motor_candidate.kicad_sch, Sirokko_Input_Protection_WIP.kicad_sch, logic_power_24_5_DRAFT.kicad_sch, motor_pwm_REBUILD.kicad_sch, sirokko_tft_reset_local_DRAFT.kicad_sch, sirokko_tft_spi_isolation_DRAFT.kicad_sch, tft_power_tps62162_review_DRAFT.kicad_sch]
2026-10-29 hardware: publish 10085c31 REV_MID join WIP
    [Sirokko26201_control_motor_candidate.kicad_pcb, Sirokko26201_control_motor_candidate.kicad_sch, Sirokko_Input_Protection_WIP.kicad_sch, logic_power_24_5_DRAFT.kicad_sch, motor_pwm_REBUILD.kicad_sch, sirokko_tft_reset_local_DRAFT.kicad_sch, sirokko_tft_spi_isolation_DRAFT.kicad_sch, tft_power_tps62162_review_DRAFT.kicad_sch]
2026-10-29 hardware: publish 7b125f15 Q1 drain-bus WIP
    [Sirokko26201_control_motor_candidate.kicad_pcb, Sirokko26201_control_motor_candidate.kicad_sch, Sirokko_Input_Protection_WIP.kicad_sch, logic_power_24_5_DRAFT.kicad_sch, motor_pwm_REBUILD.kicad_sch, sirokko_tft_reset_local_DRAFT.kicad_sch, sirokko_tft_spi_isolation_DRAFT.kicad_sch, tft_power_tps62162_review_DRAFT.kicad_sch]
2026-10-29 hardware: publish 6ba06ca8 VIN source-bus WIP
    [Sirokko26201_control_motor_candidate.kicad_pcb, Sirokko26201_control_motor_candidate.kicad_sch, Sirokko_Input_Protection_WIP.kicad_sch, logic_power_24_5_DRAFT.kicad_sch, motor_pwm_REBUILD.kicad_sch, sirokko_tft_reset_local_DRAFT.kicad_sch, sirokko_tft_spi_isolation_DRAFT.kicad_sch, tft_power_tps62162_review_DRAFT.kicad_sch]
2026-10-29 hardware: publish 72af4b85 VIN local-join WIP
    [Sirokko26201_control_motor_candidate.kicad_pcb, Sirokko26201_control_motor_candidate.kicad_sch, Sirokko_Input_Protection_WIP.kicad_sch, logic_power_24_5_DRAFT.kicad_sch, motor_pwm_REBUILD.kicad_sch, sirokko_tft_reset_local_DRAFT.kicad_sch, sirokko_tft_spi_isolation_DRAFT.kicad_sch, tft_power_tps62162_review_DRAFT.kicad_sch]
2026-10-29 hardware: publish 8d516517 P24 source-bus WIP
    [Sirokko26201_control_motor_candidate.kicad_pcb, Sirokko26201_control_motor_candidate.kicad_sch, Sirokko_Input_Protection_WIP.kicad_sch, logic_power_24_5_DRAFT.kicad_sch, motor_pwm_REBUILD.kicad_sch, sirokko_tft_reset_local_DRAFT.kicad_sch, sirokko_tft_spi_isolation_DRAFT.kicad_sch, tft_power_tps62162_review_DRAFT.kicad_sch]
2026-10-29 hardware: publish fd2f819b input-feed WIP
    [Sirokko26201_control_motor_candidate.kicad_pcb, Sirokko26201_control_motor_candidate.kicad_sch, Sirokko_Input_Protection_WIP.kicad_sch, logic_power_24_5_DRAFT.kicad_sch, motor_pwm_REBUILD.kicad_sch, sirokko_tft_reset_local_DRAFT.kicad_sch, sirokko_tft_spi_isolation_DRAFT.kicad_sch, tft_power_tps62162_review_DRAFT.kicad_sch]
2026-10-29 hardware: publish 4c86dc30 J25 interface WIP
    [Sirokko26201_control_motor_candidate-erc.json, Sirokko26201_control_motor_candidate.kicad_pcb, Sirokko26201_control_motor_candidate.kicad_sch, Sirokko26201_control_motor_candidate.xml, Sirokko_Input_Protection_WIP.kicad_sch, logic_power_24_5_DRAFT.kicad_sch, motor_pwm_REBUILD.kicad_sch, sirokko_tft_reset_local_DRAFT.kicad_sch]
2026-10-29 hardware: publish 9d55cba7 ERC cleanup WIP
    [Sirokko26201_control_motor_candidate.kicad_pcb, Sirokko26201_control_motor_candidate.kicad_sch, Sirokko_Input_Protection_WIP.kicad_sch, logic_power_24_5_DRAFT.kicad_sch, motor_pwm_REBUILD.kicad_sch, sirokko_tft_reset_local_DRAFT.kicad_sch, sirokko_tft_spi_isolation_DRAFT.kicad_sch, tft_power_tps62162_review_DRAFT.kicad_sch]
2026-10-29 hardware: publish 7d8b0134 TVS entry-return WIP
    [Sirokko26201_control_motor_candidate.kicad_pcb, Sirokko26201_control_motor_candidate.kicad_sch, Sirokko_Input_Protection_WIP.kicad_sch, logic_power_24_5_DRAFT.kicad_sch, motor_pwm_REBUILD.kicad_sch, sirokko_tft_reset_local_DRAFT.kicad_sch, sirokko_tft_spi_isolation_DRAFT.kicad_sch, tft_power_tps62162_review_DRAFT.kicad_sch]
2026-10-29 hardware: publish 185baa26 relay coil supply WIP
    [Sirokko26201_control_motor_candidate.kicad_pcb, Sirokko26201_control_motor_candidate.kicad_sch, Sirokko_Input_Protection_WIP.kicad_sch, logic_power_24_5_DRAFT.kicad_sch, motor_pwm_REBUILD.kicad_sch, sirokko_tft_reset_local_DRAFT.kicad_sch, sirokko_tft_spi_isolation_DRAFT.kicad_sch, tft_power_tps62162_review_DRAFT.kicad_sch]
2026-10-29 hardware: publish 068c6783 relay outputs WIP
    [Sirokko26201_control_motor_candidate.kicad_pcb, Sirokko26201_control_motor_candidate.kicad_sch, Sirokko_Input_Protection_WIP.kicad_sch, logic_power_24_5_DRAFT.kicad_sch, motor_pwm_REBUILD.kicad_sch, sirokko_tft_reset_local_DRAFT.kicad_sch, sirokko_tft_spi_isolation_DRAFT.kicad_sch, tft_power_tps62162_review_DRAFT.kicad_sch]
2026-10-29 hardware: publish silk cleanup 8bdeca20 WIP
    [Sirokko26201_control_motor_candidate.kicad_pcb, Sirokko26201_control_motor_candidate.kicad_sch, Sirokko_Input_Protection_WIP.kicad_sch, logic_power_24_5_DRAFT.kicad_sch, motor_pwm_REBUILD.kicad_sch, sirokko_tft_reset_local_DRAFT.kicad_sch, sirokko_tft_spi_isolation_DRAFT.kicad_sch, tft_power_tps62162_review_DRAFT.kicad_sch]
2026-10-29 hardware: publish J25 library match 279d316f WIP
    [Sirokko26201_control_motor_candidate.kicad_pcb, Sirokko26201_control_motor_candidate.kicad_sch, Sirokko_Input_Protection_WIP.kicad_sch, logic_power_24_5_DRAFT.kicad_sch, motor_pwm_REBUILD.kicad_sch, sirokko_tft_reset_local_DRAFT.kicad_sch, sirokko_tft_spi_isolation_DRAFT.kicad_sch, tft_power_tps62162_review_DRAFT.kicad_sch]
2026-10-29 hardware: publish current TFT keepouts b21b8c1a WIP
    [Sirokko26201_control_motor_candidate.kicad_pcb, Sirokko26201_control_motor_candidate.kicad_sch, Sirokko_Input_Protection_WIP.kicad_sch, logic_power_24_5_DRAFT.kicad_sch, motor_pwm_REBUILD.kicad_sch, sirokko_tft_reset_local_DRAFT.kicad_sch, sirokko_tft_spi_isolation_DRAFT.kicad_sch, tft_power_tps62162_review_DRAFT.kicad_sch]
2026-10-29 hardware: publish YD 25.40 mm row spacing 73caf79a WIP
    [Sirokko26201_control_motor_candidate.kicad_pcb, Sirokko26201_control_motor_candidate.kicad_sch, Sirokko_Input_Protection_WIP.kicad_sch, logic_power_24_5_DRAFT.kicad_sch, motor_pwm_REBUILD.kicad_sch, sirokko_tft_reset_local_DRAFT.kicad_sch, sirokko_tft_spi_isolation_DRAFT.kicad_sch, tft_power_tps62162_review_DRAFT.kicad_sch]
2026-10-29 docs: publish read-only antenna audit 73caf79a
2026-10-29 docs: publish corrected antenna audit and rejected edge trial
    [Sirokko26201_control_motor_candidate.kicad_pcb, Sirokko26201_control_motor_candidate.kicad_sch, Sirokko_Input_Protection_WIP.kicad_sch, logic_power_24_5_DRAFT.kicad_sch, motor_pwm_REBUILD.kicad_sch, sirokko_tft_reset_local_DRAFT.kicad_sch, sirokko_tft_spi_isolation_DRAFT.kicad_sch, tft_power_tps62162_review_DRAFT.kicad_sch]
2026-10-29 docs: preserve DevKit local rebuild snapshots
    [Sirokko26201_control_motor_candidate.kicad_pcb, Sirokko26201_control_motor_candidate.kicad_sch, Sirokko_Input_Protection_WIP.kicad_sch, logic_power_24_5_DRAFT.kicad_sch, motor_pwm_REBUILD.kicad_sch, sirokko_tft_reset_local_DRAFT.kicad_sch, sirokko_tft_spi_isolation_DRAFT.kicad_sch, tft_power_tps62162_review_DRAFT.kicad_sch]
2026-10-29 docs: publish DevKit supply and silkscreen snapshot
    [Sirokko26201_control_motor_candidate.kicad_pcb, Sirokko26201_control_motor_candidate.kicad_sch, Sirokko_Input_Protection_WIP.kicad_sch, logic_power_24_5_DRAFT.kicad_sch, motor_pwm_REBUILD.kicad_sch, sirokko_tft_reset_local_DRAFT.kicad_sch, sirokko_tft_spi_isolation_DRAFT.kicad_sch, tft_power_tps62162_review_DRAFT.kicad_sch]
2026-10-29 docs: preserve BE6D086C DRDY restoration
    [Sirokko26201_control_motor_candidate.kicad_pcb, Sirokko26201_control_motor_candidate.kicad_sch, Sirokko_Input_Protection_WIP.kicad_sch, logic_power_24_5_DRAFT.kicad_sch, motor_pwm_REBUILD.kicad_sch, sirokko_tft_reset_local_DRAFT.kicad_sch, sirokko_tft_spi_isolation_DRAFT.kicad_sch, tft_power_tps62162_review_DRAFT.kicad_sch]
2026-10-29 docs: archive A6ABF29E DevKit local routing
    [Sirokko26201_control_motor_candidate.kicad_pcb, Sirokko26201_control_motor_candidate.kicad_sch, Sirokko_Input_Protection_WIP.kicad_sch, logic_power_24_5_DRAFT.kicad_sch, motor_pwm_REBUILD.kicad_sch, sirokko_tft_reset_local_DRAFT.kicad_sch, sirokko_tft_spi_isolation_DRAFT.kicad_sch, tft_power_tps62162_review_DRAFT.kicad_sch]
2026-10-29 docs: archive 29219993 DevKit SCK and MISO routing
    [Sirokko26201_control_motor_candidate.kicad_pcb, Sirokko26201_control_motor_candidate.kicad_sch, Sirokko_Input_Protection_WIP.kicad_sch, logic_power_24_5_DRAFT.kicad_sch, motor_pwm_REBUILD.kicad_sch, sirokko_tft_reset_local_DRAFT.kicad_sch, sirokko_tft_spi_isolation_DRAFT.kicad_sch, tft_power_tps62162_review_DRAFT.kicad_sch]
2026-10-29 docs: publish minimal three-IC safety candidate
    [BOM_CANDIDATE.csv, Sirokko_minimal_safety.kicad_sch]
2026-10-29 docs: publish integrated minimal safety PCB WIP
    [MinimalSafety.kicad_sch, Sirokko26201_control_motor_candidate.kicad_pcb, Sirokko26201_control_motor_candidate.kicad_sch, Sirokko_Input_Protection_WIP.kicad_sch, logic_power_24_5_DRAFT.kicad_sch, motor_pwm_REBUILD.kicad_sch, pcb_drc.json, pcb_final_native_checks.json]
2026-10-29 docs: publish GPIO8 TFT_DC WIP
    [DEVKIT_PINMAP_CURRENT.csv, MinimalSafety.kicad_sch, Sirokko26201_control_motor_candidate.kicad_pcb, Sirokko26201_control_motor_candidate.kicad_sch, Sirokko_Input_Protection_WIP.kicad_sch, logic_power_24_5_DRAFT.kicad_sch, motor_pwm_REBUILD.kicad_sch, pcb_drc.json]
2026-10-29 docs: publish external connections V3 review
    [EXTERNAL_PINMAP.csv]
2026-10-29 hardware: publish no-J25 V4 WIP snapshot
    [EXTERNAL_PINMAP_CURRENT.csv, MinimalSafety.kicad_sch, Sirokko26201_control_motor_candidate.kicad_pcb, Sirokko26201_control_motor_candidate.kicad_sch, Sirokko_Input_Protection_WIP.kicad_sch, logic_power_24_5_DRAFT.kicad_sch, motor_pwm_REBUILD.kicad_sch, sirokko_tft_reset_local_DRAFT.kicad_sch]
2026-10-29 hardware: publish internal-permit V5 WIP snapshot
    [BOM_CURRENT_CANDIDATE.csv, MinimalSafety.kicad_sch, Sirokko26201_control_motor_candidate.kicad_pcb, Sirokko26201_control_motor_candidate.kicad_sch, Sirokko_Input_Protection_WIP.kicad_sch, logic_power_24_5_DRAFT.kicad_sch, motor_pwm_REBUILD.kicad_sch, sirokko_tft_reset_local_DRAFT.kicad_sch]
2026-10-29 docs: publish terminal-service V6 review
    [MinimalSafety.kicad_sch, Sirokko26201_control_motor_candidate.kicad_pcb, Sirokko26201_control_motor_candidate.kicad_sch, Sirokko_Input_Protection_WIP.kicad_sch, logic_power_24_5_DRAFT.kicad_sch, motor_pwm_REBUILD.kicad_sch, sirokko_tft_reset_local_DRAFT.kicad_sch, sirokko_tft_spi_isolation_DRAFT.kicad_sch]
2026-10-29 hardware: publish R90 service-clearance V7 WIP
    [BOM_CURRENT_CANDIDATE.csv, MinimalSafety.kicad_sch, Sirokko26201_control_motor_candidate.kicad_pcb, Sirokko26201_control_motor_candidate.kicad_sch, Sirokko_Input_Protection_WIP.kicad_sch, logic_power_24_5_DRAFT.kicad_sch, motor_pwm_REBUILD.kicad_sch, sirokko_tft_reset_local_DRAFT.kicad_sch]
2026-10-29 hardware: publish DG85BM relay-axis V8 WIP
    [MinimalSafety.kicad_sch, Sirokko26201_control_motor_candidate.kicad_pcb, Sirokko26201_control_motor_candidate.kicad_sch, Sirokko_Input_Protection_WIP.kicad_sch, logic_power_24_5_DRAFT.kicad_sch, motor_pwm_REBUILD.kicad_sch, sirokko_tft_reset_local_DRAFT.kicad_sch, sirokko_tft_spi_isolation_DRAFT.kicad_sch]
2026-10-29 docs: publish V8 relay UI TFT review
2026-10-29 hardware: publish C25 native V8 WIP
    [BOM_C25.csv, MinimalSafety.kicad_sch, Sirokko26201_control_motor_candidate.kicad_pcb, Sirokko26201_control_motor_candidate.kicad_sch, Sirokko_Input_Protection_WIP.kicad_sch, Waveshare_18366_k01-2_official_nominal.stp, logic_power_24_5_DRAFT.kicad_sch, motor_pwm_REBUILD.kicad_sch]
2026-10-29 chore: consolidate current CAD project
    [ASSEMBLY_HARDWARE_BOM_DRAFT.csv, BOM.csv, BOM_CANDIDATE.csv, BOM_CHANGE_U9003_DRAFT.csv, BOM_CURRENT_CANDIDATE.csv, BOM_DRAFT_NOT_FOR_ORDER.csv, BOM_EXACT_MPN.csv, BOM_latest.csv]
2026-10-29 pcb: add after20 logic routing
    [Sirokko26201_control_motor_candidate.kicad_pcb]
2026-10-29 pcb: add after30 routing
    [Sirokko26201_control_motor_candidate.kicad_pcb]
2026-10-29 pcb: add after34 ground routing
    [Sirokko26201_control_motor_candidate.kicad_pcb]
2026-10-29 pcb: add after42 3v3 routing
    [Sirokko26201_control_motor_candidate.kicad_pcb]
2026-10-29 pcb: add after52 power and ground routing
    [Sirokko26201_control_motor_candidate.kicad_pcb]
2026-10-29 pcb: add after55 return routing
    [Sirokko26201_control_motor_candidate.kicad_pcb]
2026-10-29 docs: add complete after55 board views
2026-10-29 Add after63 native GND routing candidate
    [Sirokko26201_control_motor_candidate.kicad_pcb]
2026-10-29 chore: remove revision artifacts
    [BOM_C25.csv]
2026-10-29 hardware: finish LM5013 feedback layout
    [Sirokko26201_control_motor_candidate.kicad_pcb]
2026-10-29 hardware: connect watchdog CWD signal
    [Sirokko26201_control_motor_candidate.kicad_pcb]
2026-10-29 hardware: finish watchdog WIP cleanup
    [Sirokko26201_control_motor_candidate.kicad_pcb]
2026-10-29 hardware: verify WD_OK and close two GND gaps
    [Sirokko26201_control_motor_candidate.kicad_pcb, logic_power_24_5_DRAFT.kicad_sch]
2026-10-29 Route WD_HEARTBEAT and CLEAR_N
    [Sirokko26201_control_motor_candidate.kicad_pcb]
2026-10-30 Remove manual RESET from Sirokko WIP
    [MinimalSafety.kicad_sch, Sirokko26201_control_motor_candidate.kicad_pcb, Sirokko26201_control_motor_candidate.kicad_sch]
2026-10-30 WIP: restore local +3V3 label on U6.4
    [MinimalSafety.kicad_sch]
2026-10-30 WIP: publish current unfinished CAD sources
    [MinimalSafety.kicad_sch, Sirokko26201_control_motor_candidate.kicad_pcb, Sirokko26201_control_motor_candidate.kicad_sch, logic_power_24_5_DRAFT.kicad_sch, motor_pwm_REBUILD.kicad_sch]
2026-10-30 Update PCB WIP routing snapshot
    [Sirokko26201_control_motor_candidate.kicad_pcb]
2026-10-30 Update +3V3 PCB WIP routing snapshot
    [Sirokko26201_control_motor_candidate.kicad_pcb]
2026-10-30 Publish GND PCB WIP snapshot
    [Sirokko26201_control_motor_candidate.kicad_pcb]
2026-10-30 hardware: publish 1527 GND WIP
    [Sirokko26201_control_motor_candidate.kicad_pcb]
2026-10-30 hardware: publish 1531 +3V3 WIP
    [Sirokko26201_control_motor_candidate.kicad_pcb]
2026-10-30 docs: update power-stage research WIP
2026-10-30 hardware: publish 1537 GND bridge WIP
    [Sirokko26201_control_motor_candidate.kicad_pcb]
2026-10-30 hardware: publish 1536 orphan-track cleanup WIP
    [Sirokko26201_control_motor_candidate.kicad_pcb]
2026-10-30 hardware: remove external EN_CHIP_PU path
    [Sirokko26201_control_motor_candidate.kicad_pcb, Sirokko26201_control_motor_candidate.kicad_sch]
2026-10-30 Move R9004 beside Q101
    [Sirokko26201_control_motor_candidate.kicad_pcb]
2026-10-30 Mark R9001 Kelvin pads as jumpers
    [Sirokko26201_control_motor_candidate.kicad_pcb, motor_pwm_REBUILD.kicad_sch]
2026-10-30 WIP: connect OCP_OK feedback to GPIO18
    [MinimalSafety.kicad_sch, Sirokko26201_control_motor_candidate.kicad_pcb, Sirokko26201_control_motor_candidate.kicad_sch, Sirokko_Input_Protection_WIP.kicad_sch, logic_power_24_5_DRAFT.kicad_sch, motor_pwm_REBUILD.kicad_sch, sirokko_tft_reset_local_DRAFT.kicad_sch, sirokko_tft_spi_isolation_DRAFT.kicad_sch]
2026-10-30 WIP: publish current MCP-routed PCB snapshot
    [Sirokko26201_control_motor_candidate.kicad_pcb]
2026-10-30 WIP: publish zero-open PCB routing snapshot
    [Sirokko26201_control_motor_candidate.kicad_pcb]
2026-10-30 Publish current HC-160A CAD snapshot
    [Sirokko26201_control_motor_candidate.kicad_pcb, Sirokko26201_control_motor_candidate.kicad_sch, motor_external_hc160.kicad_sch, motor_pwm_REBUILD.kicad_sch]
2026-10-30 Publish DFR0650 schematic WIP
    [Sirokko26201_control_motor_candidate.kicad_sch, sirokko_tft_reset_local_DRAFT.kicad_sch, sirokko_tft_spi_isolation_DRAFT.kicad_sch, tft_power_tps62162_review_DRAFT.kicad_sch]
2026-10-30 Publish low-cost OLED schematic WIP
    [Sirokko26201_control_motor_candidate.kicad_sch]
2026-10-30 Publish remote-only WIP schematic snapshot
    [Sirokko26201_control_motor_candidate.kicad_sch]
2026-10-30 Publish clean remote-only PCB WIP
    [Sirokko26201_control_motor_candidate.kicad_pcb]
2026-10-30 Publish J29 metadata and draft interface BOM
    [BOM_DRAFT_NOT_FOR_ORDER.csv, Sirokko26201_control_motor_candidate.kicad_pcb, motor_external_hc160.kicad_sch]
2026-10-30 Publish draft purchasing BOM split
    [BOM_PURCHASE_DRAFT_NOT_FOR_ORDER.csv]
2026-10-30 Publish draft fabrication outputs
    [BOM_DRAFT_NOT_FOR_ORDER.csv, BOM_PURCHASE_DRAFT_NOT_FOR_ORDER.csv, POSITIONS_ALL_DRAFT.csv, POSITIONS_SMD_DRAFT.csv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]
2026-10-31 Publish DRC-complete CAD draft
    [Sirokko26201_control_motor_candidate-B_Cu.gbl, Sirokko26201_control_motor_candidate-B_Mask.gbs, Sirokko26201_control_motor_candidate-B_Paste.gbp, Sirokko26201_control_motor_candidate-B_Silkscreen.gbo, Sirokko26201_control_motor_candidate-Edge_Cuts.gm1, Sirokko26201_control_motor_candidate-F_Cu.gtl, Sirokko26201_control_motor_candidate-F_Mask.gts, Sirokko26201_control_motor_candidate-F_Paste.gtp]
2026-10-31 Publish cleaned PCB assembly draft
    [Sirokko26201_control_motor_candidate-B_Cu.gbl, Sirokko26201_control_motor_candidate-B_Mask.gbs, Sirokko26201_control_motor_candidate-B_Paste.gbp, Sirokko26201_control_motor_candidate-B_Silkscreen.gbo, Sirokko26201_control_motor_candidate-Edge_Cuts.gm1, Sirokko26201_control_motor_candidate-F_Cu.gtl, Sirokko26201_control_motor_candidate-F_Mask.gts, Sirokko26201_control_motor_candidate-F_Paste.gtp]
2026-10-31 Publish verified YD power documentation
2026-10-31 Publish two-relay PCB draft
    [BOM_DRAFT_NOT_FOR_ORDER.csv, BOM_PURCHASE_DRAFT_NOT_FOR_ORDER.csv, MinimalSafety.kicad_sch, POSITIONS_ALL_DRAFT.csv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]
2026-10-31 Publish C104 C0G manufacturing draft
    [BOM_DRAFT_NOT_FOR_ORDER.csv, BOM_PURCHASE_DRAFT_NOT_FOR_ORDER.csv, POSITIONS_ALL_DRAFT.csv, POSITIONS_SMD_DRAFT.csv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]
2026-10-31 Publish thermocouple correction draft package
    [BOM_DRAFT_NOT_FOR_ORDER.csv, BOM_PURCHASE_DRAFT_NOT_FOR_ORDER.csv, POSITIONS_ALL_DRAFT.csv, POSITIONS_SMD_DRAFT.csv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]
2026-10-31 Publish modular MAX31856 schematic WIP
    [MinimalSafety.kicad_sch, Sirokko26201_control_motor_candidate.kicad_sch]
2026-10-31 Publish modular MAX31856 PCB WIP
    [MinimalSafety.kicad_sch, Sirokko26201_control_motor_candidate.kicad_pcb]
2026-11-01 Apply MAX31856 socket footprints
    [Sirokko26201_control_motor_candidate.kicad_pcb, Sirokko26201_control_motor_candidate.kicad_sch]
2026-11-01 Apply first HC160 relayout step
    [Sirokko26201_control_motor_candidate.kicad_pcb]
2026-11-01 Simplify ROOM_DQ routing
    [Sirokko26201_control_motor_candidate.kicad_pcb]
2026-11-01 Simplify relay command routing
    [Sirokko26201_control_motor_candidate.kicad_pcb]
2026-11-01 Relocate MAX31856 CS pull-up
    [Sirokko26201_control_motor_candidate.kicad_pcb]
2026-11-01 Publish current modular BOM draft
    [BOM_DRAFT_NOT_FOR_ORDER.csv, BOM_EXTERNAL_COMPONENTS_DRAFT.csv, BOM_MECHANICAL_INTERFACES_DRAFT.csv, BOM_PURCHASE_ALLOCATION_DRAFT.csv, BOM_PURCHASE_DRAFT_NOT_FOR_ORDER.csv]
2026-11-01 Publish current CAM draft archive
    [POSITIONS_ALL_DRAFT.csv, POSITIONS_SMD_DRAFT.csv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]
2026-11-01 docs(cad): publish 33 nF input startup WIP
    [Sirokko26201_control_motor_candidate.kicad_sch, Sirokko_Input_Protection_WIP.kicad_sch]
2026-11-01 fix(kicad): clarify input protection schematic labels
    [Sirokko_Input_Protection_WIP.kicad_sch]
2026-11-01 feat(kicad): publish no-P24 review candidate
2026-11-01 feat(kicad): promote no-P24 design to canonical CAD
    [BOM_DRAFT_NOT_FOR_ORDER.csv, BOM_PURCHASE_ALLOCATION_DRAFT.csv, BOM_PURCHASE_DRAFT_NOT_FOR_ORDER.csv, Sirokko26201_control_motor_candidate.kicad_pcb, Sirokko26201_control_motor_candidate.kicad_sch]
2026-11-01 feat(kicad): publish verified copper cleanup
    [Sirokko26201_control_motor_candidate.kicad_pcb]
2026-11-01 docs: publish final PCB routing views
2026-11-01 chore(kicad): keep canonical project only
    [Sirokko26201_control_motor_candidate.kicad_pcb]
2026-11-01 Publish ESP32 relocation WIP and parity audit
    [Sirokko26201_control_motor_candidate.kicad_pcb]
2026-11-01 Publish accepted Sirokko PCB WIP and current renders
    [Sirokko26201_control_motor_candidate.kicad_pcb]
2026-11-01 Publish front-side ESP PCB and draft CAM
    [Sirokko26201_control_motor_candidate-B_Cu.gbr, Sirokko26201_control_motor_candidate-B_Mask.gbr, Sirokko26201_control_motor_candidate-B_Paste.gbr, Sirokko26201_control_motor_candidate-B_Silkscreen.gbr, Sirokko26201_control_motor_candidate-Edge_Cuts.gbr, Sirokko26201_control_motor_candidate-F_Cu.gbr, Sirokko26201_control_motor_candidate-F_Mask.gbr, Sirokko26201_control_motor_candidate-F_Paste.gbr]
2026-11-02 Publish current Sirokko validation records
    [CONTROL_CONNECTIONS_CURRENT.csv, Sirokko_components_ChipDip.csv]
2026-11-02 docs: publish imposed-ramp startup diagnostic
    [INPUT_SLEW_BUCK_TRACE_CURRENT.csv]
2026-11-02 docs: publish input storage current calculation
    [feed_100m_trace.csv, feed_10m_trace.csv]
2026-11-02 pcb: enlarge safe via lands
    [Sirokko26201_control_motor_candidate.kicad_pcb, VIA_RING_NATIVE_CONFLICTS_CURRENT.csv]
2026-11-02 pcb: integrate cdvdt RC pair
    [BOM_DRAFT_NOT_FOR_ORDER.csv, BOM_PURCHASE_ALLOCATION_DRAFT.csv, BOM_PURCHASE_DRAFT_NOT_FOR_ORDER.csv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]
2026-11-02 docs: publish RC verification package
    [CONTROL_CONNECTIONS_CURRENT.csv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]
2026-11-02 Complete current fabrication and editable project bundle
    [Sirokko26201_control_motor_candidate-B_Cu.gbl, Sirokko26201_control_motor_candidate-B_Mask.gbs, Sirokko26201_control_motor_candidate-B_Paste.gbp, Sirokko26201_control_motor_candidate-B_Silkscreen.gbo, Sirokko26201_control_motor_candidate-Edge_Cuts.gm1, Sirokko26201_control_motor_candidate-F_Cu.gtl, Sirokko26201_control_motor_candidate-F_Mask.gts, Sirokko26201_control_motor_candidate-F_Paste.gtp]
2026-11-02 Optimize MOSI route and update project records
    [BOM_EXTERNAL_COMPONENTS_DRAFT.csv, BOM_MECHANICAL_INTERFACES_DRAFT.csv, BOM_PURCHASE_ALLOCATION_DRAFT.csv, BOM_PURCHASE_DRAFT_NOT_FOR_ORDER.csv, MinimalSafety.kicad_sch, Sirokko26201_control_motor_candidate.kicad_pcb, Sirokko26201_control_motor_candidate.kicad_sch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]
2026-11-02 Clean schematic frame and obsolete current artifacts
    [Sirokko26201_control_motor_candidate.kicad_sch]
2026-11-02 Update ESP socket metadata to Samtec tin variant
    [BOM_PURCHASE_ALLOCATION_DRAFT.csv, BOM_PURCHASE_DRAFT_NOT_FOR_ORDER.csv, Sirokko26201_control_motor_candidate.kicad_pcb, Sirokko26201_control_motor_candidate.kicad_sch, Sirokko_components_ChipDip.csv]
2026-11-02 Refresh verified manufacturing package and metadata records
    [Sirokko26201_control_motor_candidate-B_Cu.gbr, Sirokko26201_control_motor_candidate-B_Mask.gbr, Sirokko26201_control_motor_candidate-B_Paste.gbr, Sirokko26201_control_motor_candidate-B_Silkscreen.gbr, Sirokko26201_control_motor_candidate-Edge_Cuts.gbr, Sirokko26201_control_motor_candidate-F_Cu.gbr, Sirokko26201_control_motor_candidate-F_Mask.gbr, Sirokko26201_control_motor_candidate-F_Paste.gbr]
2026-11-02 docs: correct current J29 geometry and revision references
2026-11-02 docs: correct mechanical edge-relative coordinates
    [BOM_MECHANICAL_INTERFACES_DRAFT.csv]
2026-11-02 docs: refresh power and relay reviews
2026-11-02 hardware: set 15A input fuse and load limits
    [BOM_DRAFT_NOT_FOR_ORDER.csv, BOM_PURCHASE_ALLOCATION_DRAFT.csv, BOM_PURCHASE_DRAFT_NOT_FOR_ORDER.csv, Sirokko26201_control_motor_candidate.kicad_pcb, Sirokko26201_control_motor_candidate.kicad_sch, Sirokko_Input_Protection_WIP.kicad_sch, Sirokko_components_ChipDip.csv]
2026-11-02 manufacturing: refresh 15A fuse verification package
    [Sirokko_components_ChipDip.csv, bom.csv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]
2026-11-02 Fix current mechanical PDF coordinates
2026-11-02 Close current KiCad library paths
2026-11-02 Clarify current hardware documentation
2026-11-02 Correct current F1 integration status
2026-11-02 docs: distinguish historical CAD baseline
2026-11-02 firmware: publish final control contract and sensor vectors
    [MAX31856_TEMPERATURE_VECTORS.csv]
2026-11-02 firmware: add safe control core and host tests
    [partitions.csv]
2026-11-02 firmware: add sensors AP UI and safe OTA path
2026-11-02 firmware: verify DS18B20 vectors and target dependencies
    [DS18B20_SCRATCHPAD_VECTORS.csv]
2026-11-02 firmware: fix ESP-IDF strict compilation
    [app_main.cpp, web.cpp]
2026-11-02 firmware: fix ESP32 session token formatting
    [web.cpp]
2026-11-02 firmware: close purge sensor and output safety gaps
2026-11-02 docs: add current copper routing views
2026-11-05 hardware: integrate ready TFT24 EC11 and regenerate checked fabrication draft [skip ci]
    [Sirokko26201_control_motor_candidate-B_Courtyard.gbr, Sirokko26201_control_motor_candidate-B_Cu.gbl, Sirokko26201_control_motor_candidate-B_Fab.gbr, Sirokko26201_control_motor_candidate-B_Mask.gbs, Sirokko26201_control_motor_candidate-B_Paste.gbp, Sirokko26201_control_motor_candidate-B_Silkscreen.gbo, Sirokko26201_control_motor_candidate-Edge_Cuts.gm1, Sirokko26201_control_motor_candidate-F_Court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]
2026-11-05 hardware: correct TFT control GPIOs against YD module pinout [skip ci]
    [Sirokko26201_control_motor_candidate-B_Courtyard.gbr, Sirokko26201_control_motor_candidate-B_Cu.gbl, Sirokko26201_control_motor_candidate-B_Fab.gbr, Sirokko26201_control_motor_candidate-B_Mask.gbs, Sirokko26201_control_motor_candidate-B_Paste.gbp, Sirokko26201_control_motor_candidate-B_Silkscreen.gbo, Sirokko26201_control_motor_candidate-Edge_Cuts.gm1, Sirokko26201_control_motor_candidate-F_Court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]
2026-11-05 hardware: publish TFT24 KEY0 v5 fabrication package and CAM review
    [Sirokko26201_control_motor_candidate-B_Cu.gbl, Sirokko26201_control_motor_candidate-B_Mask.gbs, Sirokko26201_control_motor_candidate-B_Paste.gbp, Sirokko26201_control_motor_candidate-B_Silkscreen.gbo, Sirokko26201_control_motor_candidate-Edge_Cuts.gm1, Sirokko26201_control_motor_candidate-F_Cu.gtl, Sirokko26201_control_motor_candidate-F_Mask.gts, Sirokko26201_control_motor_candidate-F_Paste.gtp]
2026-11-05 hardware: compact PCB to 281x170 mm and reduce vias to 147
    [Sirokko26201_control_motor_candidate-B_Cu.gbl, Sirokko26201_control_motor_candidate-B_Mask.gbs, Sirokko26201_control_motor_candidate-B_Paste.gbp, Sirokko26201_control_motor_candidate-B_Silkscreen.gbo, Sirokko26201_control_motor_candidate-Edge_Cuts.gm1, Sirokko26201_control_motor_candidate-F_Cu.gtl, Sirokko26201_control_motor_candidate-F_Mask.gts, Sirokko26201_control_motor_candidate-F_Paste.gtp]
2026-11-05 hardware: reduce vias to 115 and clear J29 wire access
    [Sirokko26201_control_motor_candidate-B_Cu.gbl, Sirokko26201_control_motor_candidate-B_Mask.gbs, Sirokko26201_control_motor_candidate-B_Paste.gbp, Sirokko26201_control_motor_candidate-B_Silkscreen.gbo, Sirokko26201_control_motor_candidate-Edge_Cuts.gm1, Sirokko26201_control_motor_candidate-F_Cu.gtl, Sirokko26201_control_motor_candidate-F_Mask.gts, Sirokko26201_control_motor_candidate-F_Paste.gtp]
2026-11-05 docs: separate accepted PCB design from prototype testing stages
2026-11-06 docs: require automatic calibration and short-press combustion feedback
2026-11-06 feat(firmware): implement calibration, panel, timers and signed OTA
2026-11-08 fix(firmware): harden persistence, calibration, sensor recovery and OTA
    [app_main.cpp, control.cpp, control.hpp, ota_activation.hpp, panel.cpp, panel_render.cpp, panel_ui.cpp, panel_ui.hpp]
2026-11-10 feat(firmware): replace process profile with commissioning model
    [app_main.cpp, control.cpp, control.hpp, ota_activation.hpp, panel.cpp, panel_render.cpp, panel_ui.cpp, panel_ui.hpp]
2026-11-12 chore: publish canonical Sirokko project and manufacturing package
    [BOM_DRAFT_NOT_FOR_ORDER.csv, BOM_EXTERNAL_COMPONENTS_DRAFT.csv, BOM_MECHANICAL_INTERFACES_DRAFT.csv, BOM_PURCHASE_ALLOCATION_DRAFT.csv, BOM_PURCHASE_DRAFT_NOT_FOR_ORDER.csv, CONTROL_CONNECTIONS_CURRENT.csv, DS18B20_SCRATCHPAD_VECTORS.csv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]
2026-11-12 docs: rebuild public project around buying, assembly and operation
    [BUY.csv, InputProtection.kicad_sch, MotorInterface.kicad_sch, Power5V.kicad_sch, RelayDriver.kicad_sch, Sirokko.kicad_pcb, Sirokko.kicad_sch, bom-smt.csv]
2026-11-12 docs: simplify project layout and consolidate user documentation
    [InputProtection.kicad_sch, MotorInterface.kicad_sch, Power5V.kicad_sch, RelayDriver.kicad_sch, Sirokko.kicad_pcb, Sirokko.kicad_sch, bom-smt.csv, bom.csv]
2026-11-12 docs: remove redundant explanations and simplify wording
    [bom.csv]
2026-11-12 Use 192.168.0.1 and add Wi-Fi captive portal
    Advertise the local DNS server through DHCP and redirect HTTP connectivity probes to the canonical controller URL. Preserve API errors and optional password behavior. Add bounded DNS packet tests and bump firmware to 1.0.2.
    [app_main.cpp, panel_render.cpp, web.cpp]
2026-11-12 Fix captive browser HTTP 431 with 8 KiB request headers
    Raise ESP-IDF's 512-byte default, reject stale build configuration at compile time, and log the effective limit. Add a bench-only integration test for long mobile connectivity probes and normal HTTP/API responses. All seven cases passed on the USB-only ESP32-S3. Bump firmware to 1.0.3.
    [web.cpp]
2026-11-13 Rework controller safety, calibration and control interfaces
    Unify command admission and panel/web state, add confirmed one-time calibration and bounded thermal history, and preserve interrupted-cycle recovery.
    Add heater parameter provisioning with verified persistence, simplify navigation and themes, and cover runtime behavior with portable regression tests. Document the measured operating limits still required for the two-wire motor drive.
    [app_main.cpp, board.hpp, bounded_receive.cpp, bounded_receive.hpp, combustion.cpp, combustion.hpp, combustion_test.cpp, command_policy.hpp]
2026-11-13 Keep web scratch buffers in PSRAM so HTTP can start
    On the ESP32-S3 N16R8, internal heap fragmentation left a largest block of 9728 bytes and HTTP task creation failed. Move bounded JSON, cookie and history snapshot buffers to PSRAM while retaining internal task stacks.
    Log HTTP startup allocation failures, remove an unsupported ESP-IDF option, and extend the on-device HTTP smoke test to cover authenticated history. All eight HTTP probes passed on the connected ESP.
    [web.cpp]
2026-11-13 Clarify supplied heater manuals and model applicability
2026-11-13 Add integrated manual commissioning and measurement capture
    Add supervised PWM, glow and fuel control with shared STOP, cooling, recovery and command admission. Allow partial parameter setup and use an adjustable 40 C exhaust cooling threshold. Preserve temperature regulation and verify manual control, UI synchronization and fault handling.
2026-11-13 Align heater startup, calibration and control interfaces
    Follow the documented glow-first startup sequence, confirm ignition and flame loss across fresh exhaust readings, and preserve cooling after interrupted operation. Remove the manual actuator debug mode and obsolete startup/profile fields.
    Keep profile readiness, calibration stages, cancellation and persistence results consistent across the core, local panel and web UI. Fix partial profile saving, model-bound manual control and calibration timing feedback. Keep unverified physical thresholds unset; correct the documented supply to the owner's stable 24 V source.
    Validation: 11 portable host suites with ASan/UBSan, 44 web tests, browse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
    [app_main.cpp, combustion.cpp, combustion_test.cpp, command_policy.hpp, control.cpp, control.hpp, control_fixture.hpp, control_test.cpp]
2026-11-13 Remove misleading calibration and use configured operating range
2026-11-13 Add attended first-start measurement cycles without a completed heater profile
2026-11-13 Add synchronized PWM adjustment and recorded steps to first start
2026-11-13 Clarify heater settings and operating messages
